ArrowElectronics/I.IMX8_Thor96/README.md

# I.IMX8_Thor96
Arrow Global solution based on iMX8M MPU for Human Machine Interface Applications
