ArrowElectronics/I.IMX8_Thor96/Hardware Docs/Schematic/eI_Arrow_iMX8M_HMI_Platform_SCHEMATIC.pdf

# Arrow iMX8M HMI Platform

# 13-Aug-2018

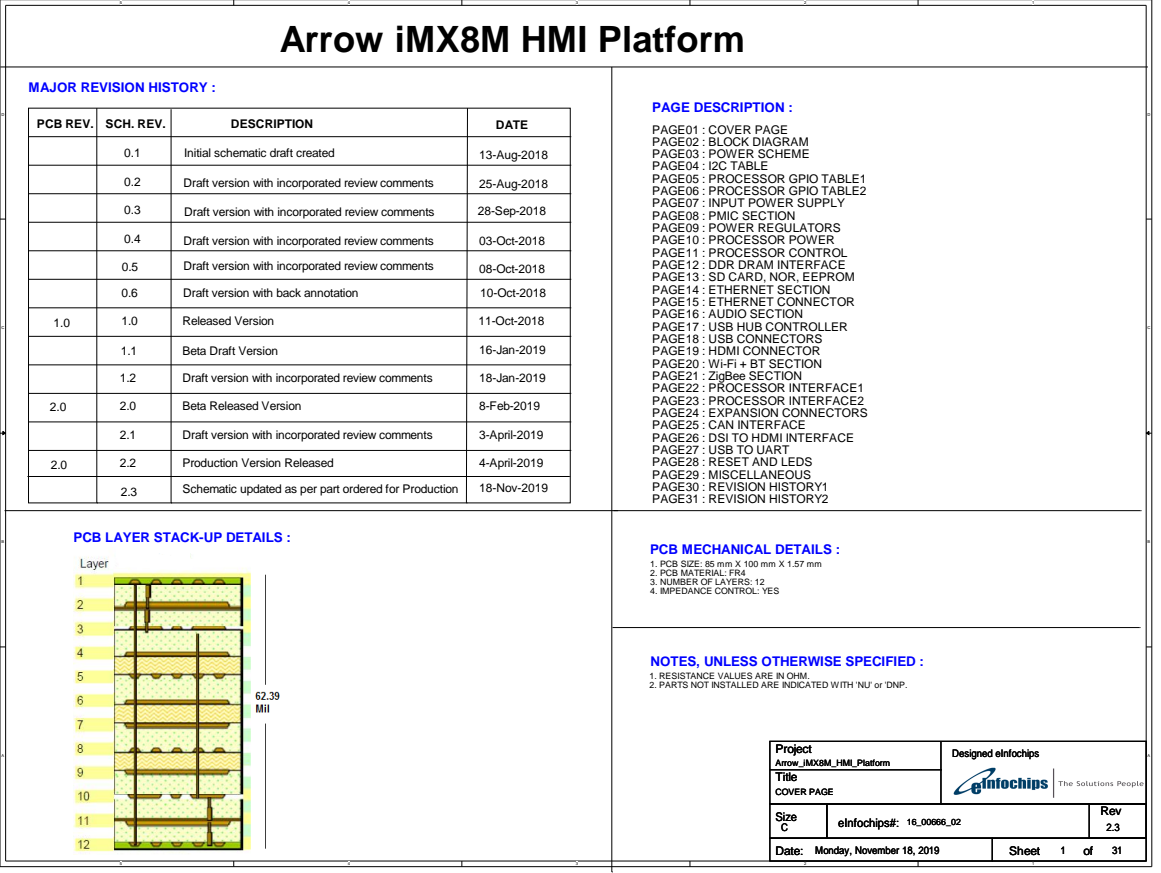
[picture p171: page 1]
8-Feb-2019; 3-April-2019; 25-Aug-2018; Released Version; 16-Jan-2019; 11-Oct-2018; 10-Oct-2018; DATE; Draft version with incorporated review comments; 18-Jan-2019; Beta Released Version; PCB REV.; SCH. REV.; DESCRIPTION; 28-Sep-2018; 03-Oct-2018; 08-Oct-2018; 4-April-2019; PAGE DESCRIPTION :; 18-Nov-2019 2.3; Schematic updated as per part ordered for Production; Title; Size; Project; Rev; Date:; Sheet; eInfochips#:; Designed eInfochips; Monday, November 18, 2019; COVER PAGE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

MAJOR REVISION HISTORY :

PAGE01 : COVER PAGE
PAGE02 : BLOCK DIAGRAM
PAGE03 : POWER SCHEME
PAGE04 : I2C TABLE
PAGE05 : PROCESSOR GPIO TABLE1
PAGE06 : PROCESSOR GPIO TABLE2
PAGE07 : INPUT POWER SUPPLY
PAGE08 : PMIC SECTION
PAGE09 : POWER REGULATORS
PAGE10 : PROCESSOR POWER
PAGE11 : PROCESSOR CONTROL
PAGE12 : DDR DRAM INTERFACE
PAGE13 : SD CARD, NOR, EEPROM
PAGE14 : ETHERNET SECTION
PAGE15 : ETHERNET CONNECTOR
PAGE16 : AUDIO SECTION
PAGE17 : USB HUB CONTROLLER
PAGE18 : USB CONNECTORS
PAGE19 : HDMI CONNECTOR
PAGE20 : Wi-Fi + BT SECTION
PAGE21 : ZigBee SECTION
PAGE22 : PROCESSOR INTERFACE1
PAGE23 : PROCESSOR INTERFACE2

Initial schematic draft created

Draft version with incorporated review comments

Draft version with back annotation

Beta Draft Version

PAGE24 : EXPANSION CONNECTORS
PAGE25 : CAN INTERFACE
PAGE26 : DSI TO HDMI INTERFACE
PAGE27 : USB TO UART
PAGE28 : RESET AND LEDS
PAGE29 : MISCELLANEOUS
PAGE30 : REVISION HISTORY1
PAGE31 : REVISION HISTORY2

Production Version Released

PCB LAYER STACK-UP DETAILS :

PCB MECHANICAL DETAILS :

1. PCB SIZE: 85 mm X 100 mm X 1.57 mm
2. PCB MATERIAL: FR4
3. NUMBER OF LAYERS: 12
4. IMPEDANCE CONTROL: YES

NOTES, UNLESS OTHERWISE SPECIFIED :

1. RESISTANCE VALUES ARE IN OHM.
2. PARTS NOT INSTALLED ARE INDICATED WITH 'NU' or 'DNP.

# BLOCK DIAGRAM

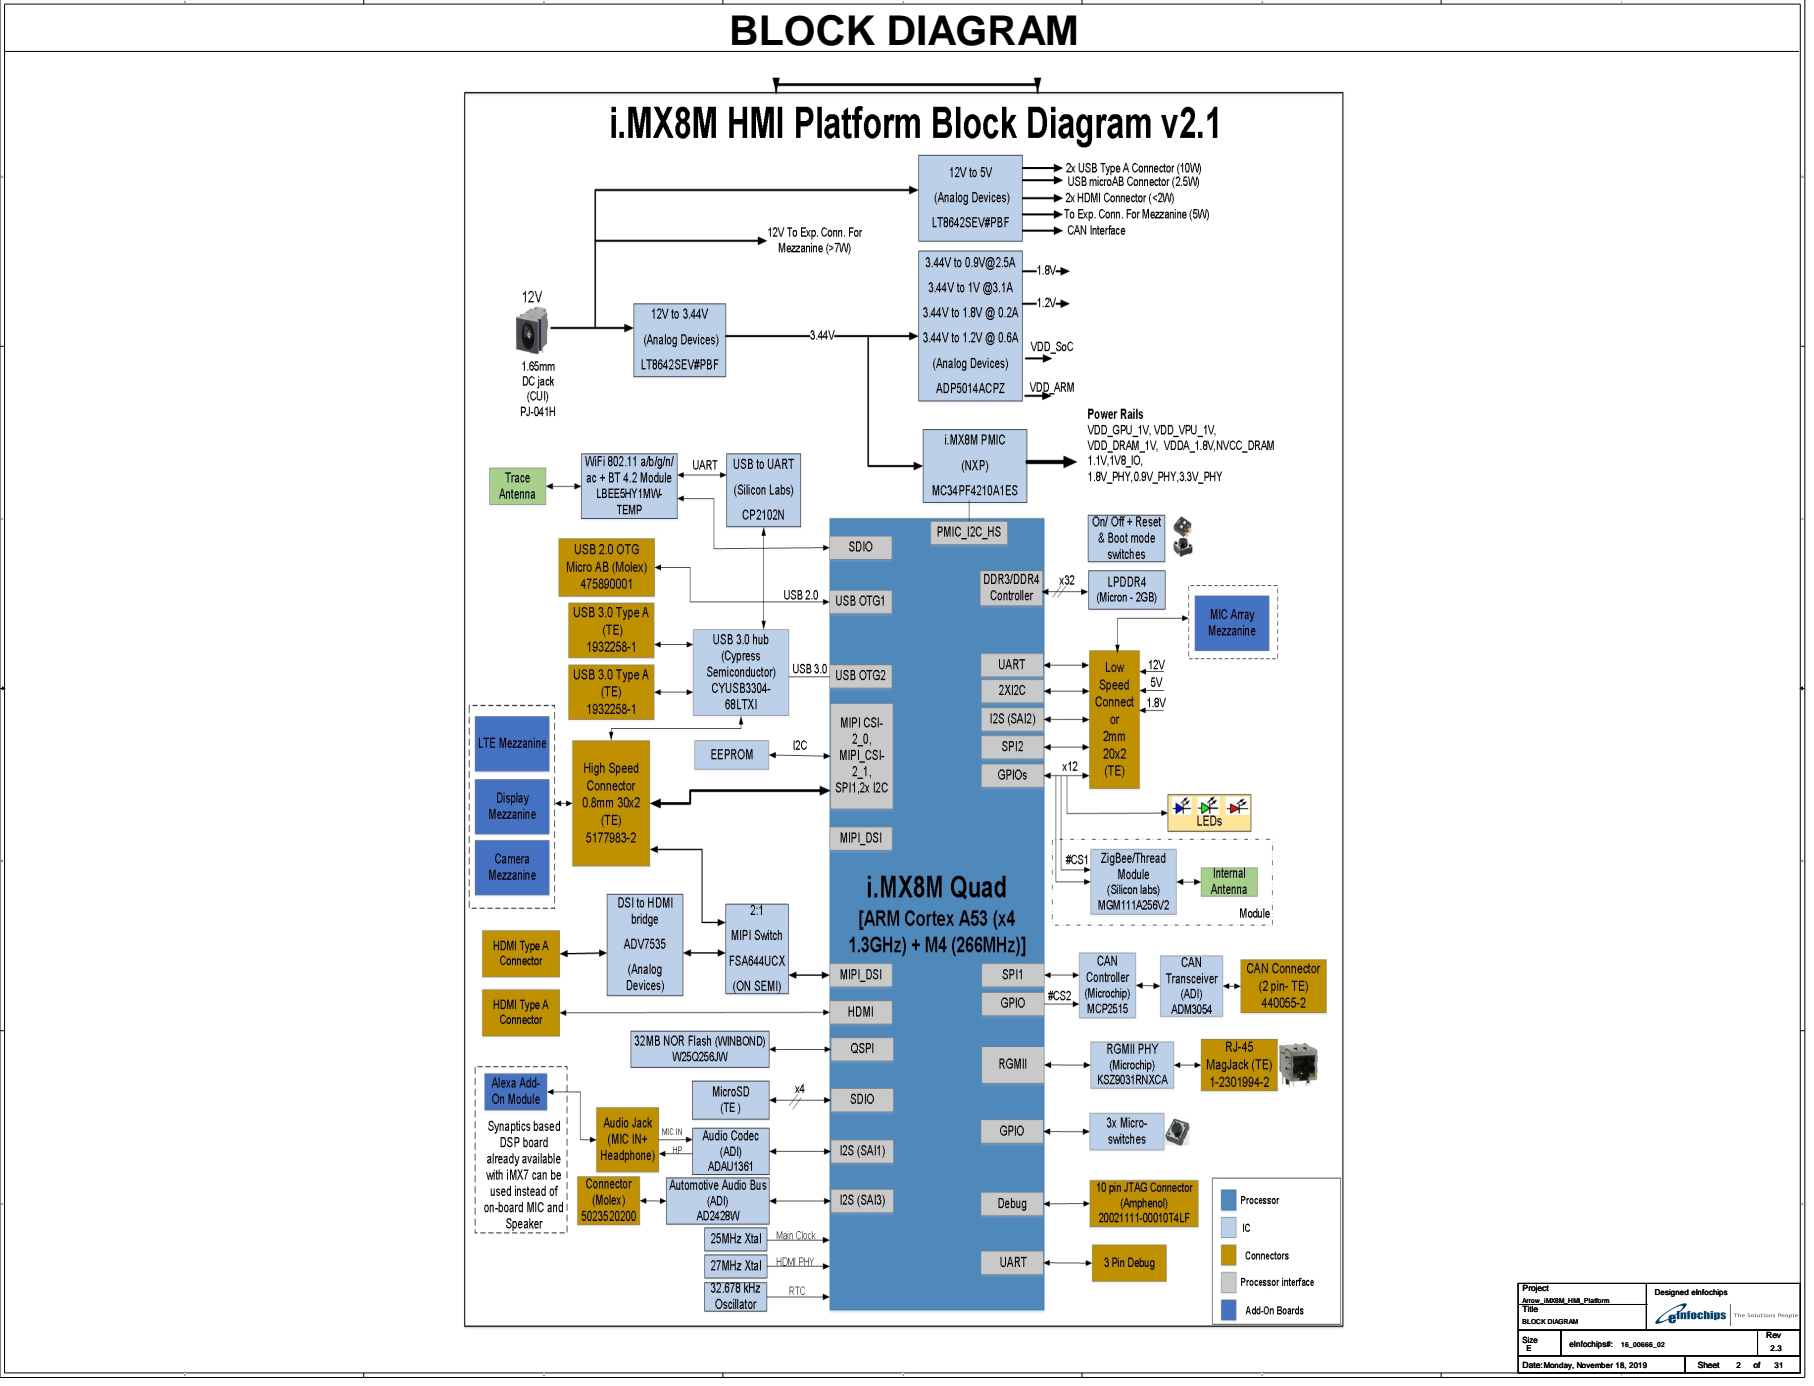
[picture p172: page 2]
Title; Project; Designed eInfochips; Monday, November 18, 2019; Arrow_iMX8M_HMI_Platform; BLOCK DIAGRAM

# POWER SCHEME

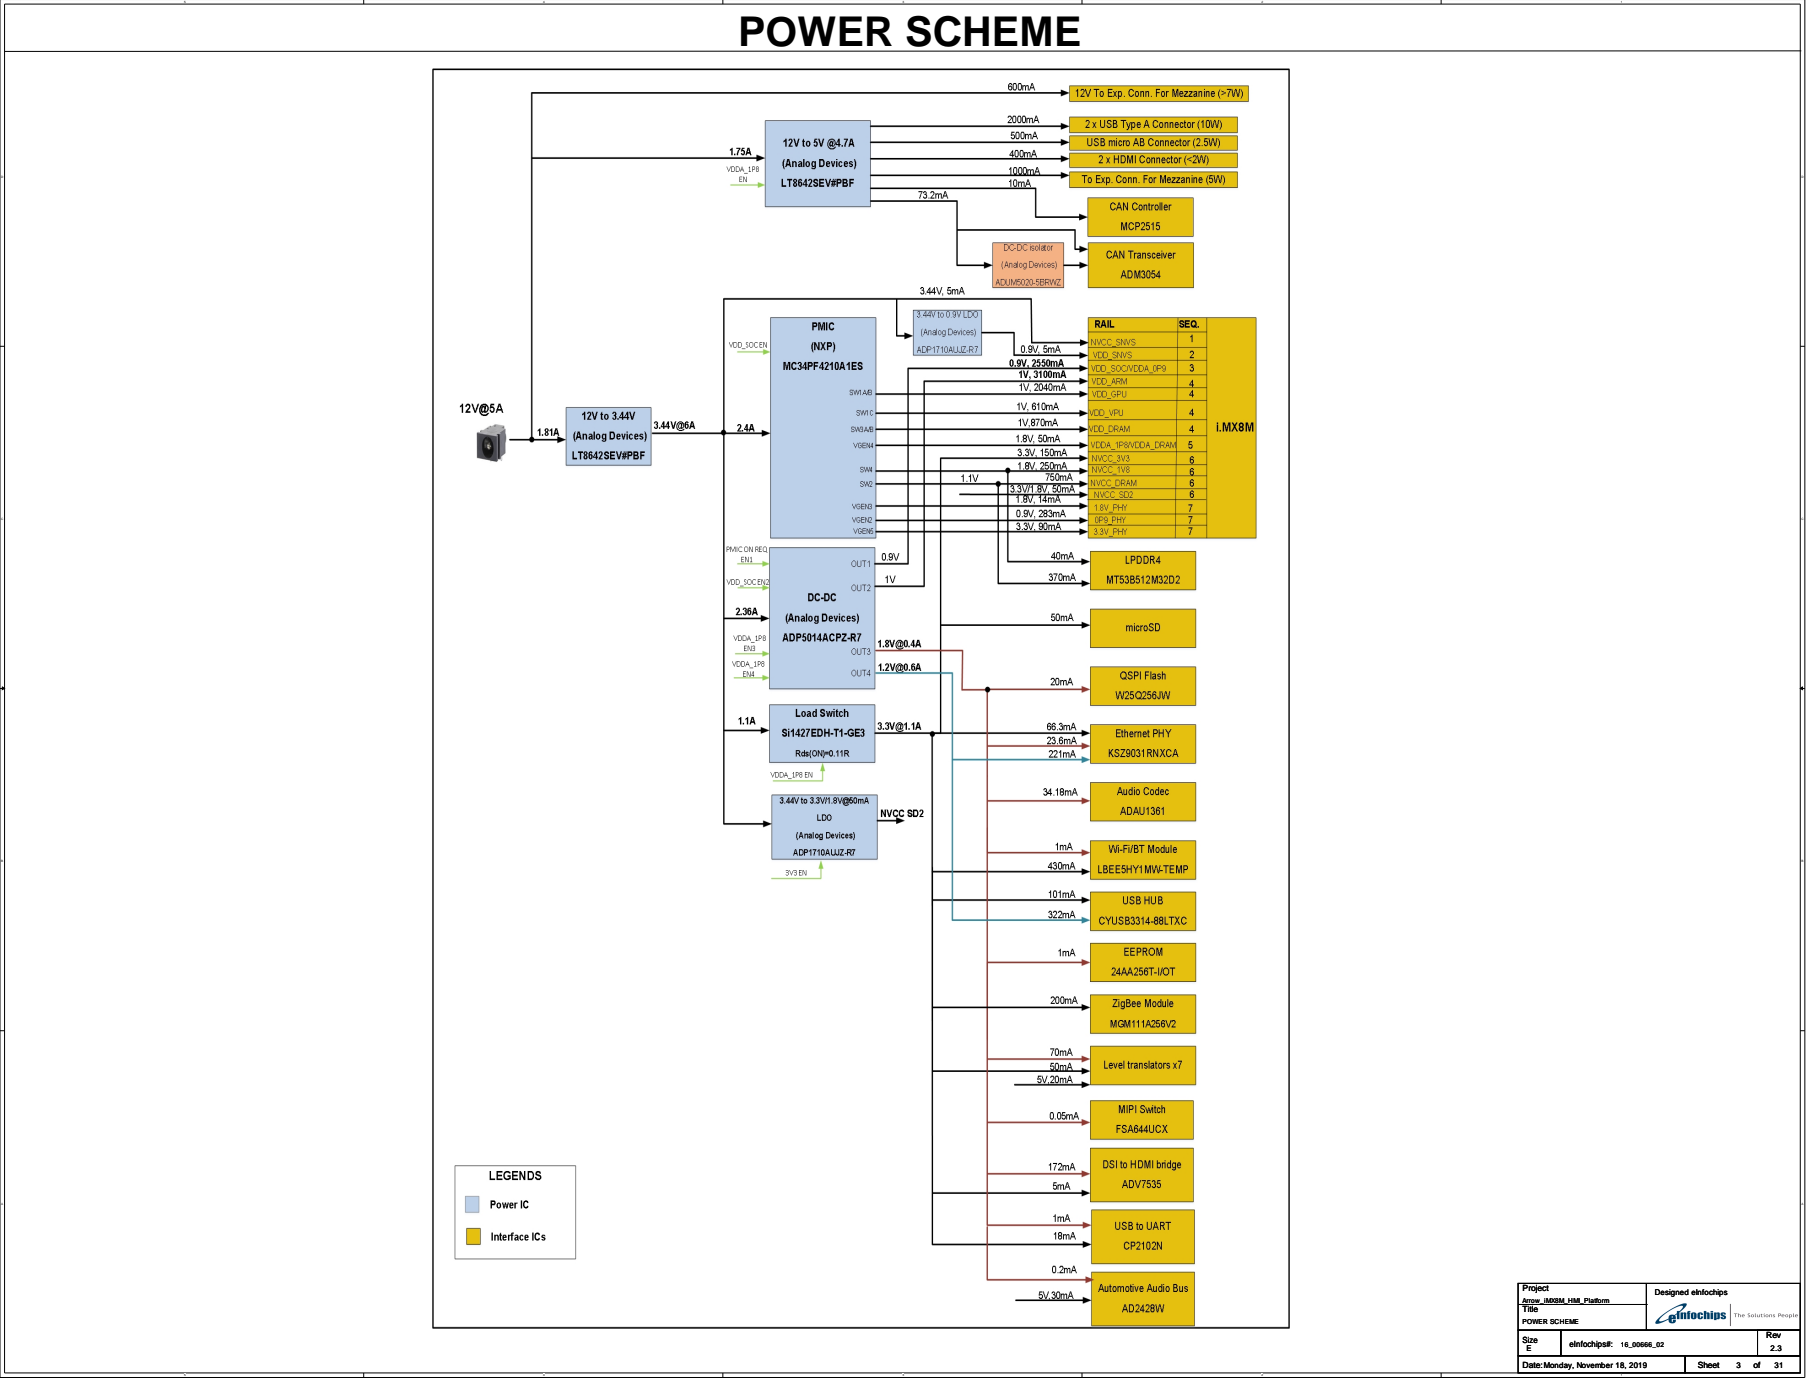
[picture p173: page 3]
Title; Project; Designed eInfochips; Monday, November 18, 2019; Arrow_iMX8M_HMI_Platform; POWER SCHEME

# I2C ADDRESS TABLE

PMIC PF4210 | 1.8V

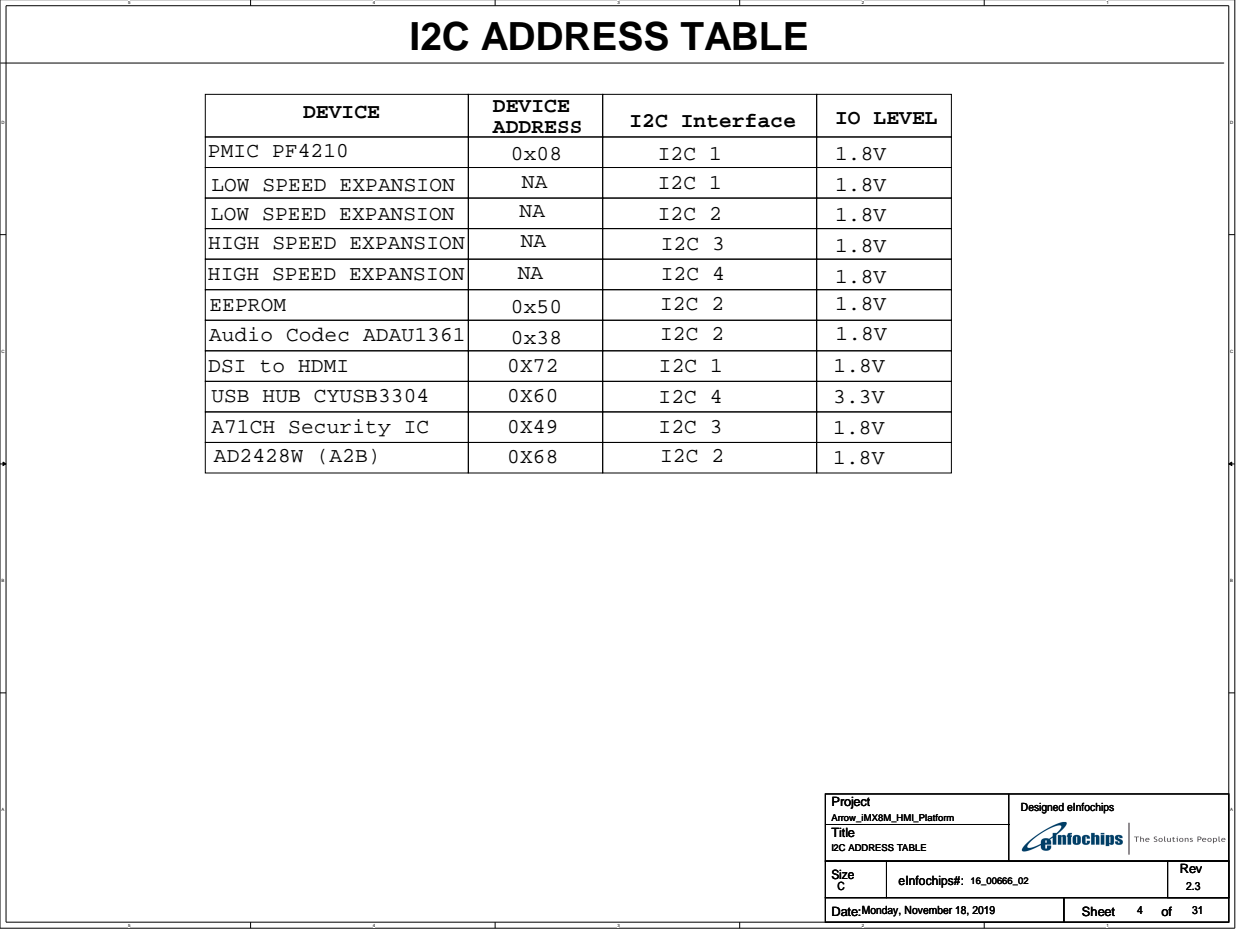
[picture p174: page 4]
LOW SPEED EXPANSION; IO LEVEL; DEVICE; I2C Interface; DEVICE ADDRESS; USB HUB CYUSB3304; A71CH Security IC; Title; Project; Designed eInfochips; Monday, November 18, 2019; Arrow_iMX8M_HMI_Platform; I2C ADDRESS TABLE

LOW SPEED EXPANSION
HIGH SPEED EXPANSION
EEPROM
Audio Codec ADAU1361
DSI to HDMI

# PROCESSOR GPIO TABLE1

# GPIO6

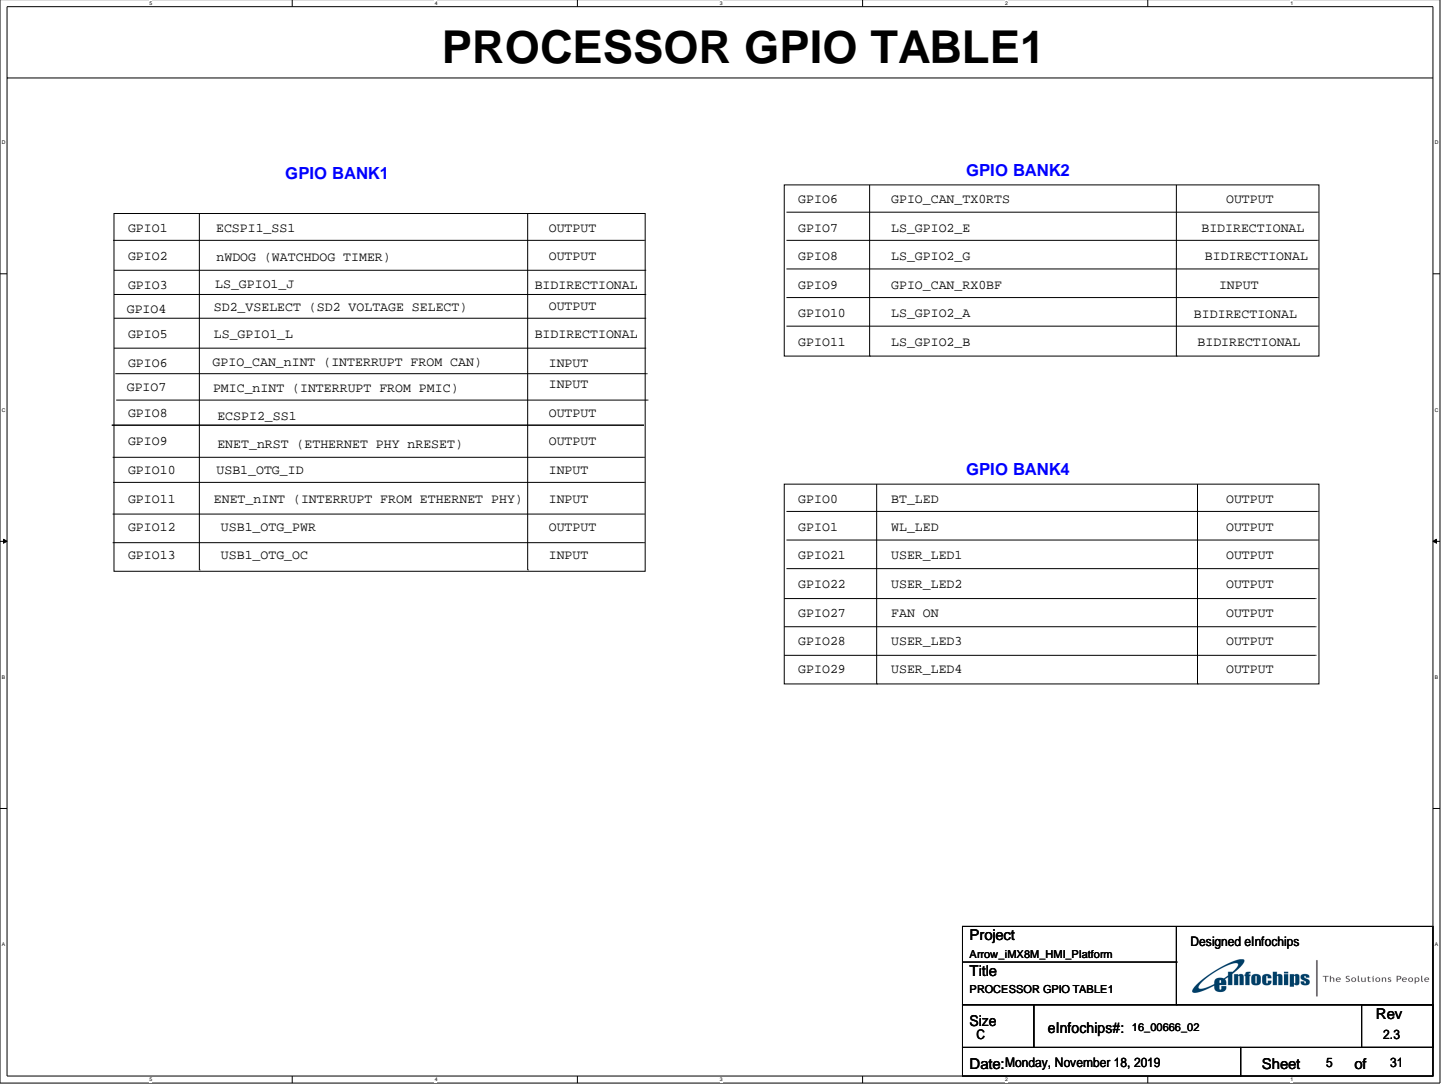
[picture p175: page 5]
LS_GPIO1_J; USB1_OTG_ID; SD2_VSELECT (SD2 VOLTAGE SELECT); OUTPUT; BIDIRECTIONAL; GPIO5; LS_GPIO1_L; GPIO6; GPIO21; GPIO22; GPIO3; GPIO9; GPIO8; GPIO12; GPIO1; GPIO29; GPIO11; GPIO7; GPIO10; GPIO2; GPIO4; GPIO28; GPIO13; GPIO_CAN_TX0RTS; GPIO BANK2; GPIO BANK4; USER_LED1; INPUT; USB1_OTG_PWR; USB1_OTG_OC; GPIO BANK1; GPIO_CAN_RX0BF; LS_GPIO2_E; LS_GPIO2_G; ECSPI1_SS1; ECSPI2_SS1; USER_LED2; USER_LED3; USER_LED4; GPIO27; FAN ON; LS_GPIO2_A; LS_GPIO2_B; GPIO0; BT_LED; WL_LED; Title; Project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

nWDOG (WATCHDOG TIMER)

GPIO_CAN_nINT (INTERRUPT FROM CAN)

PMIC_nINT (INTERRUPT FROM PMIC)

ENET_nRST (ETHERNET PHY nRESET)

ENET_nINT (INTERRUPT FROM ETHERNET PHY)

# PROCESSOR GPIO TABLE2

# INPUT

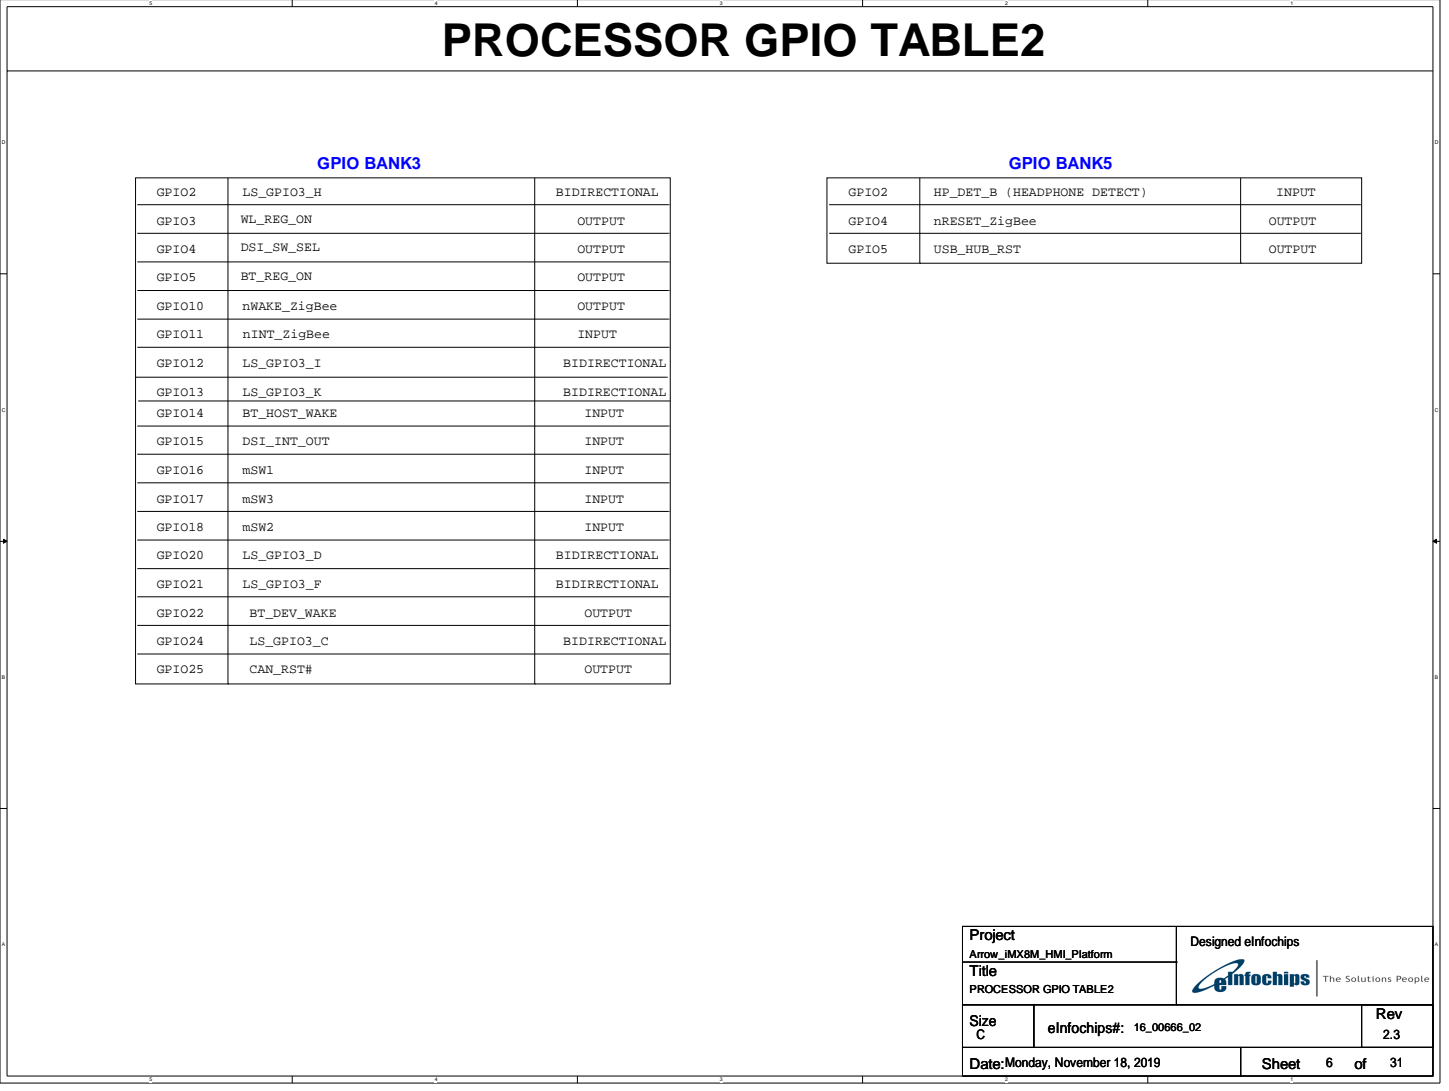
[picture p176: page 6]
mSW2; GPIO3; GPIO4; GPIO22; GPIO5; GPIO15; GPIO14; BT_HOST_WAKE; INPUT; DSI_INT_OUT; GPIO2; USB_HUB_RST; OUTPUT; nRESET_ZigBee; GPIO16; GPIO12; LS_GPIO3_D; LS_GPIO3_K; GPIO17; mSW3; GPIO18; GPIO21; LS_GPIO3_F; BIDIRECTIONAL; GPIO20; GPIO13; LS_GPIO3_H; mSW1; LS_GPIO3_I; GPIO24; LS_GPIO3_C; BT_DEV_WAKE; GPIO BANK5; GPIO BANK3; HP_DET_B (HEADPHONE DETECT); WL_REG_ON; GPIO11; nINT_ZigBee; DSI_SW_SEL; GPIO25; CAN_RST#; BT_REG_ON; GPIO10; nWAKE_ZigBee; Title; Project; Designed eInfochips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

# INPUT POWER PROTECTION CIRCUIT

# INPUT POWER SUPPLY

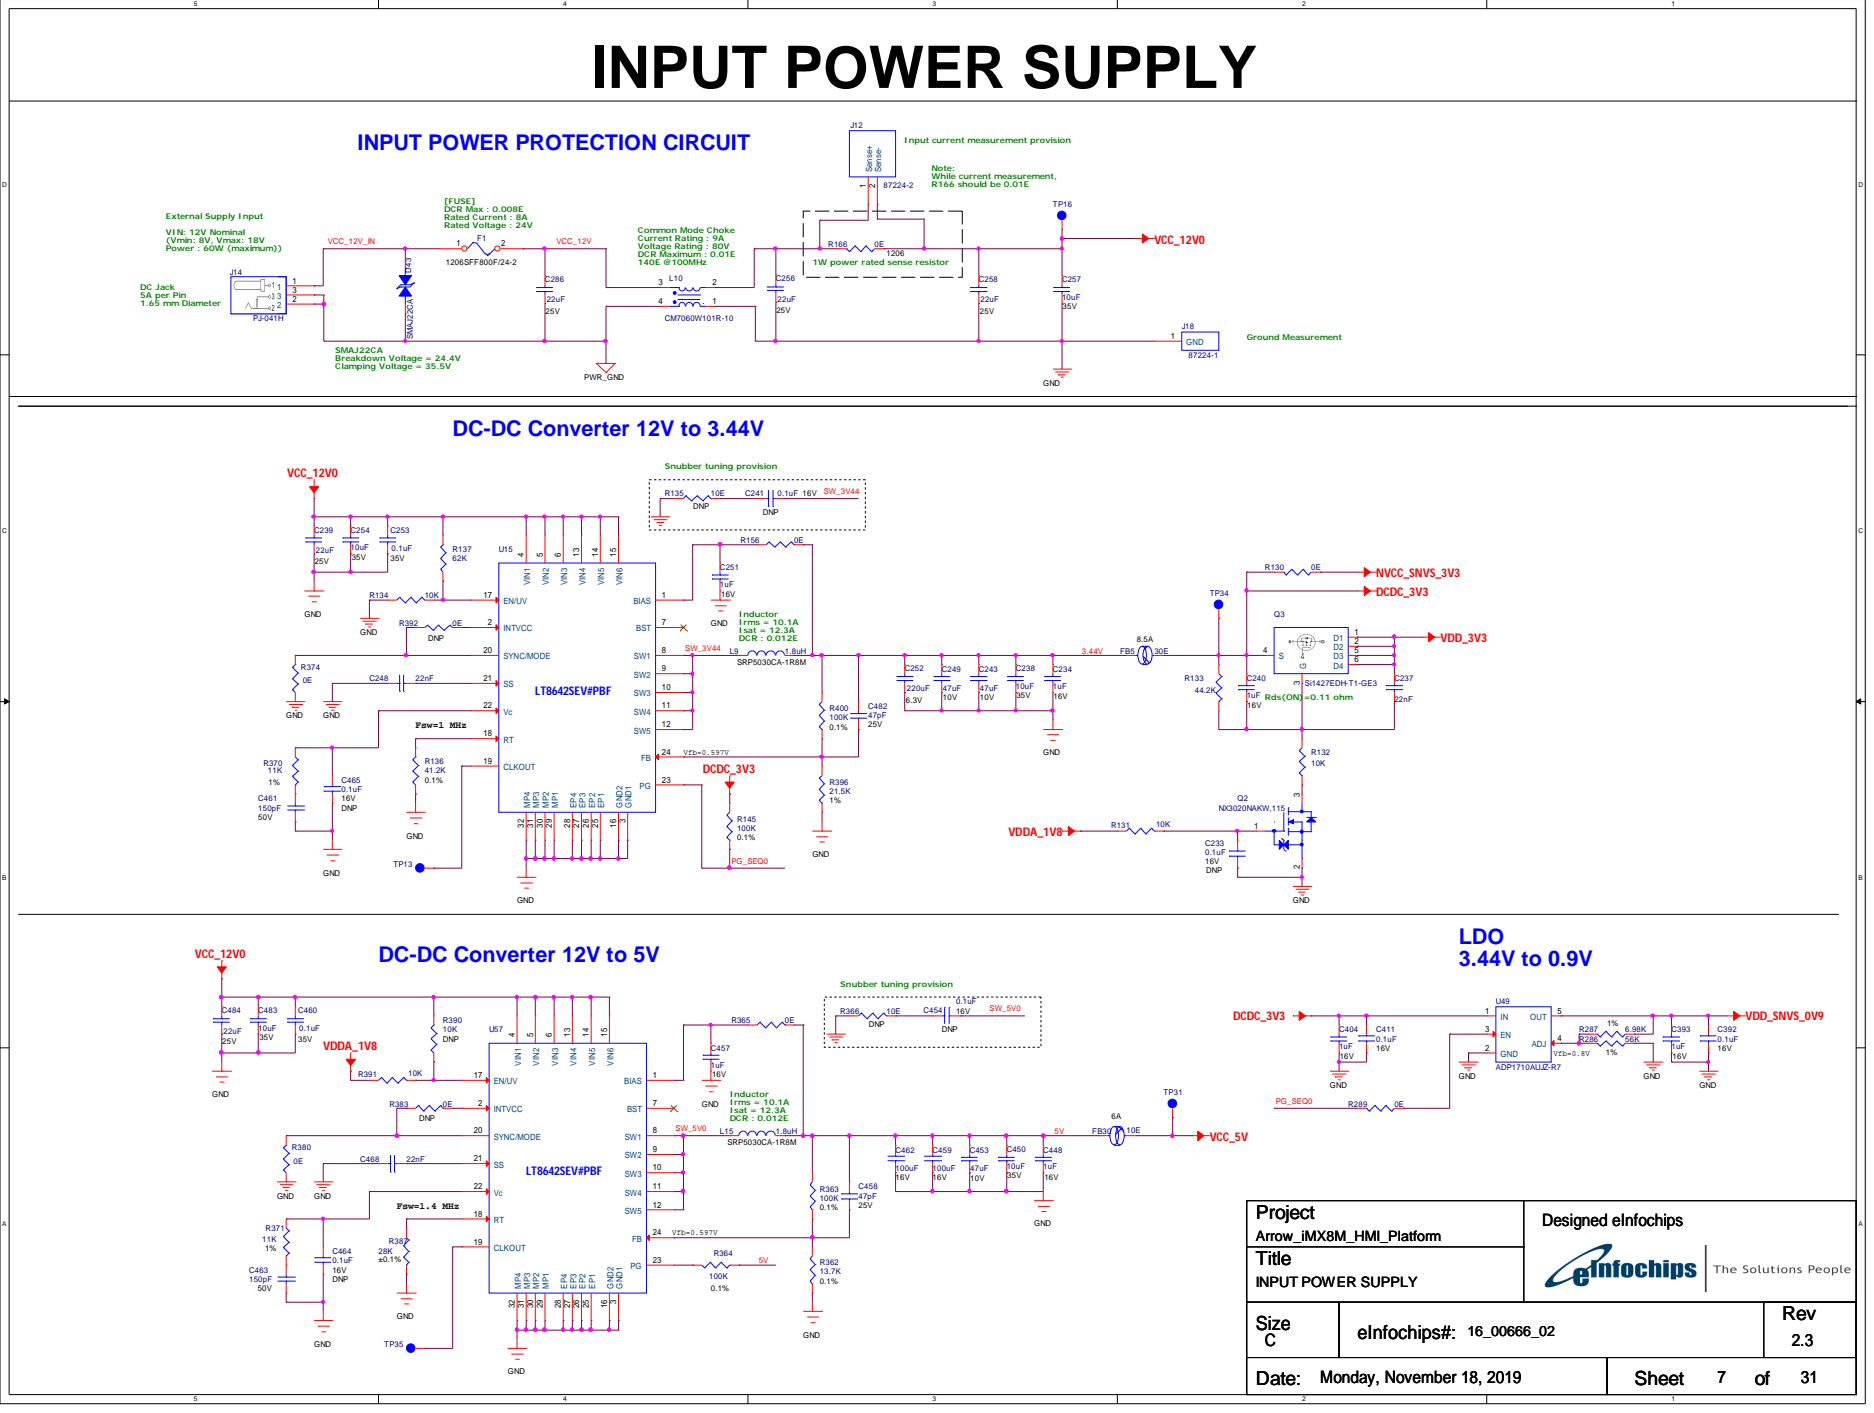
[picture p177: page 7]

Input current measurement provision

1W power rated sense resistor

DC-DC Converter 12V to 3.44V

DC-DC Converter 12V to 5V

# PMIC SECTION

## NVCC_SNVS_3V3

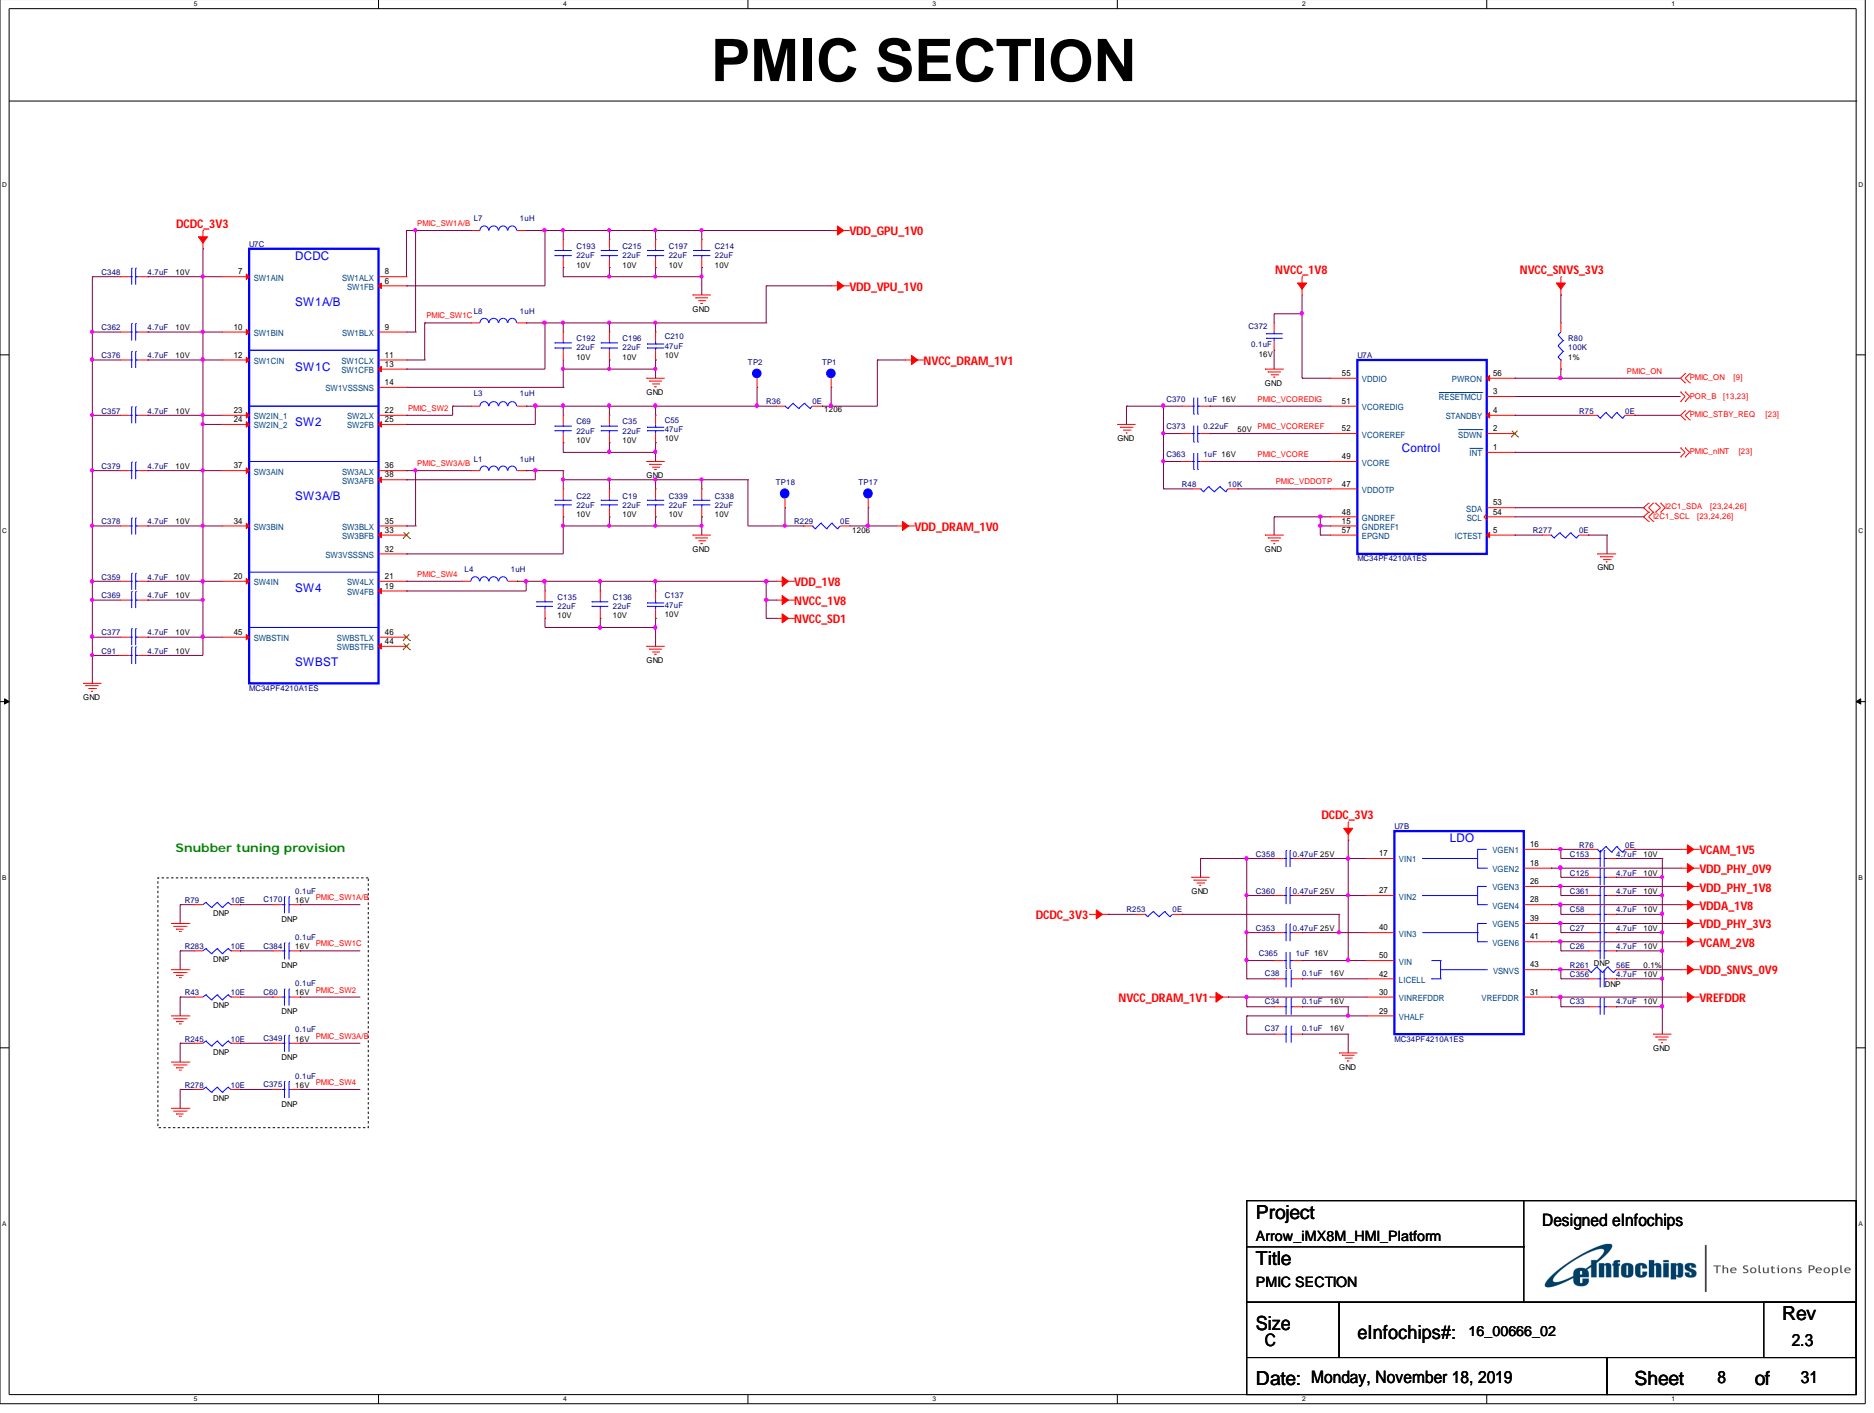
[picture p178: page 8]

# POWER REGULATORS

## CAD Note: Place decoupling capacitors near to the power pins

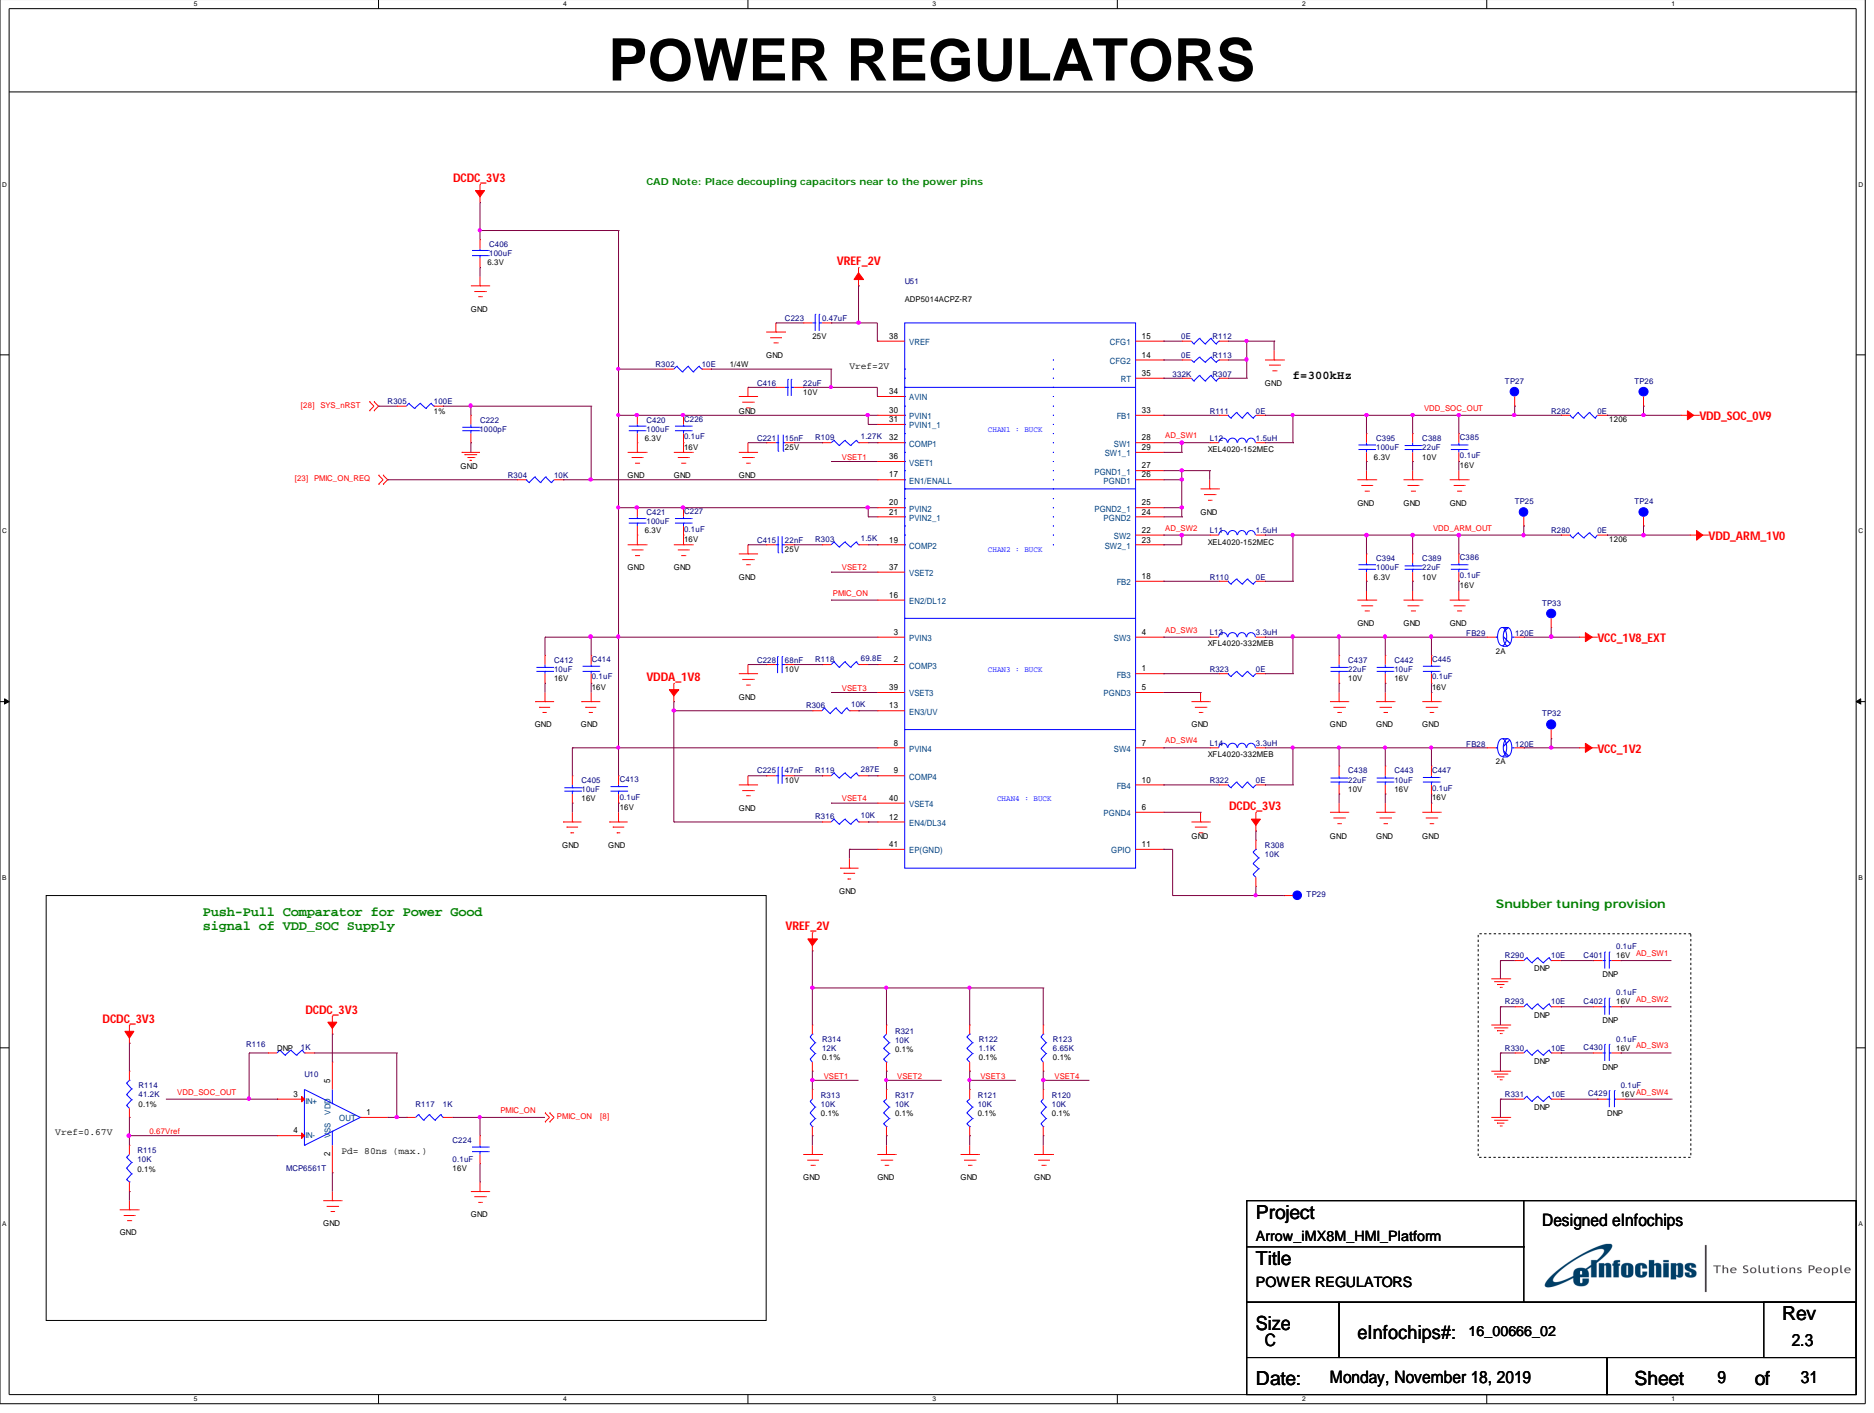
[picture p179: page 9]

Push-Pull Comparator for Power Good
signal of VDD_SOC Supply

# PROCESSOR(iMX 8M) POWER AND GROUND

NVCC_SNVS_3V3 | NVCC_1V8 | VDD_1V8 | NVCC_1V8

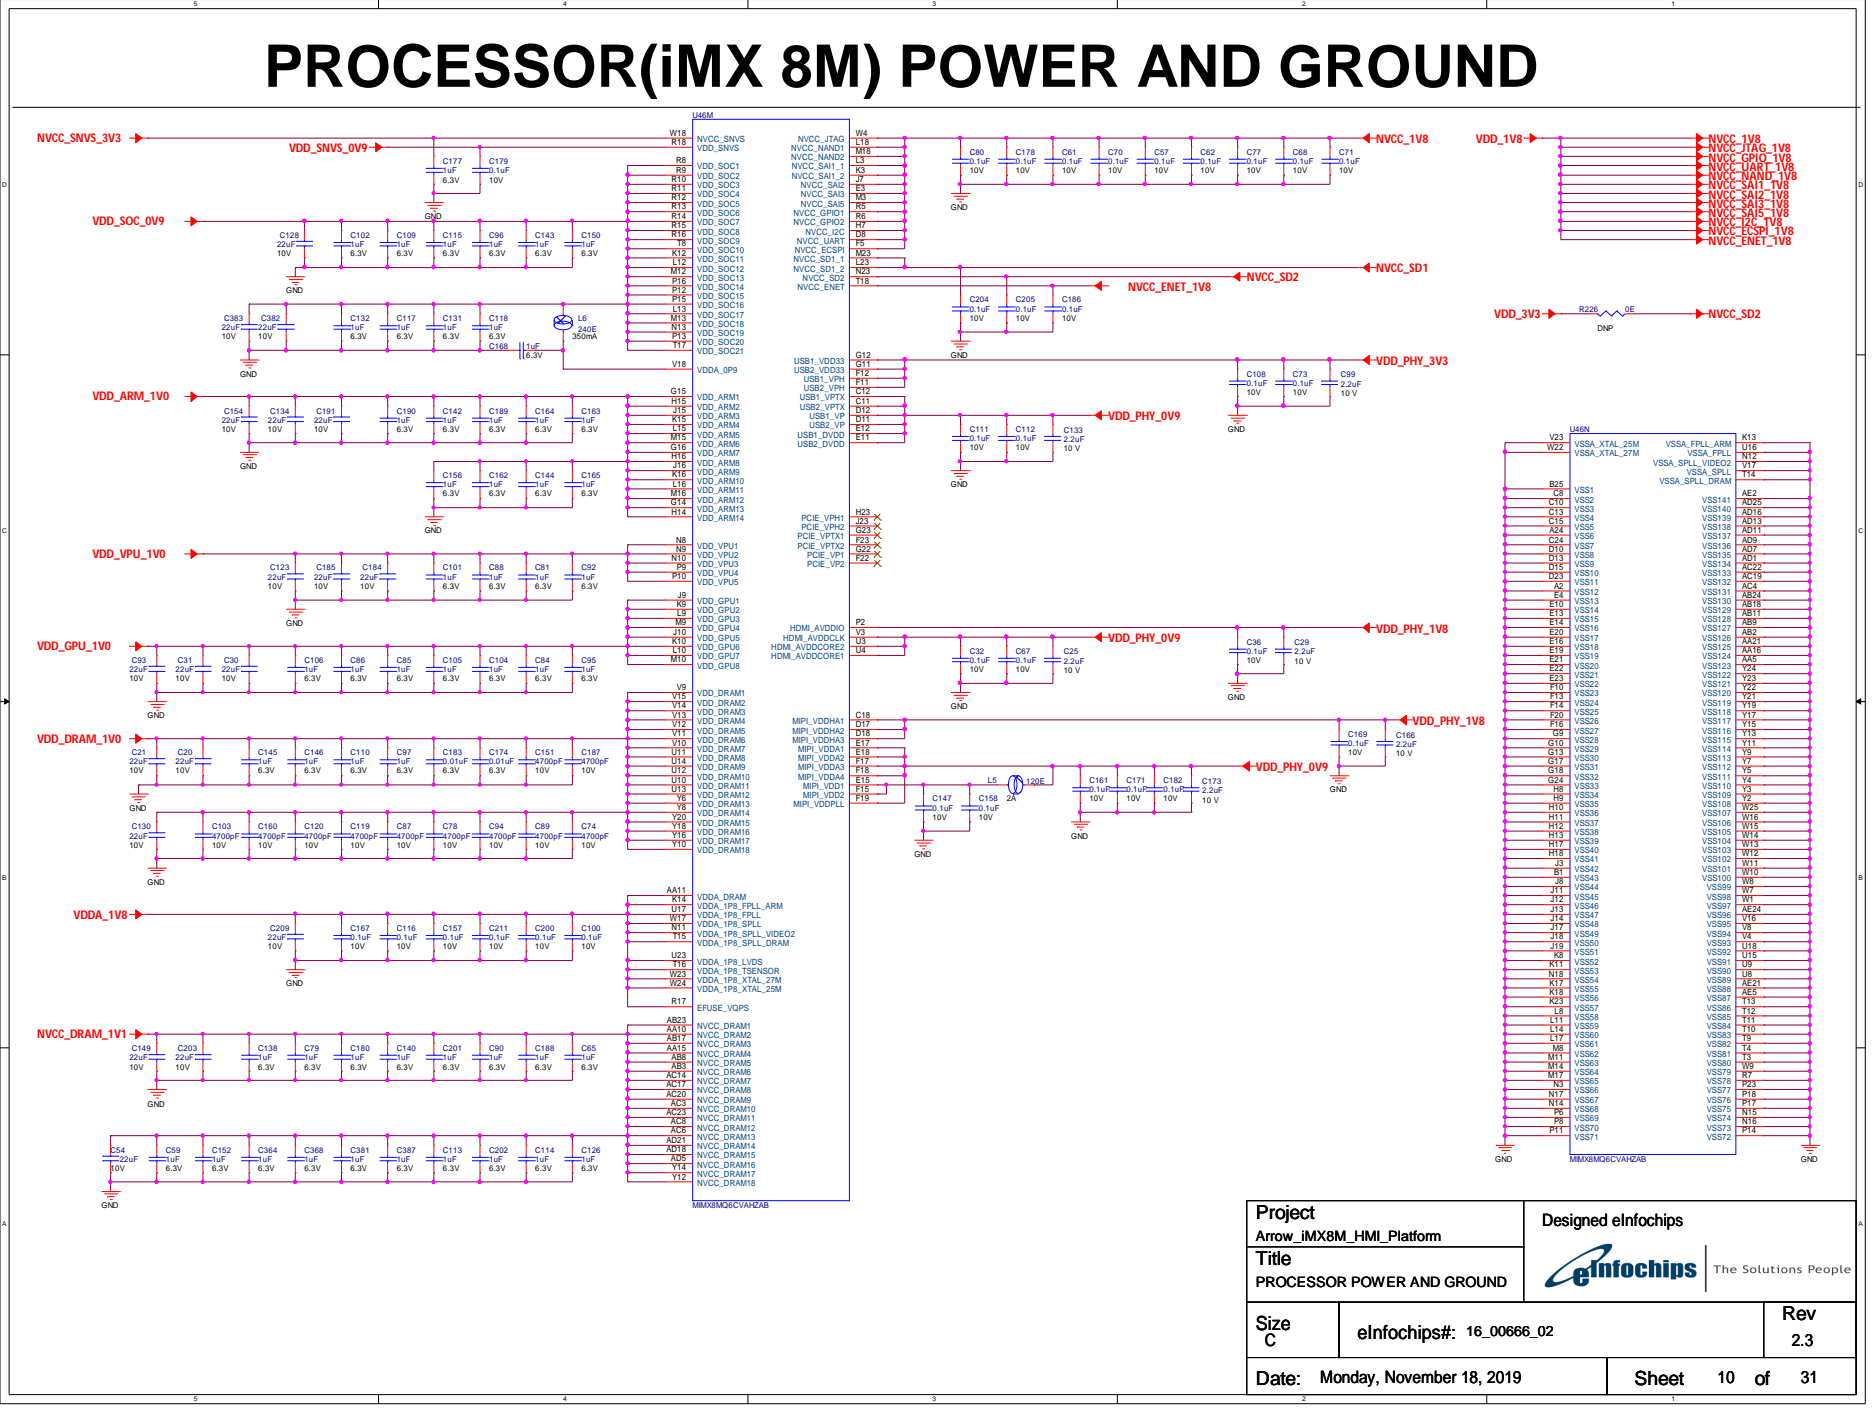
[picture p180: page 10]

PROCESSOR POWER AND GROUND

# PROCESSOR(iMX 8M QUAD) CONTROL

# QSPI boot is not supported by ROM in current Silicon revision

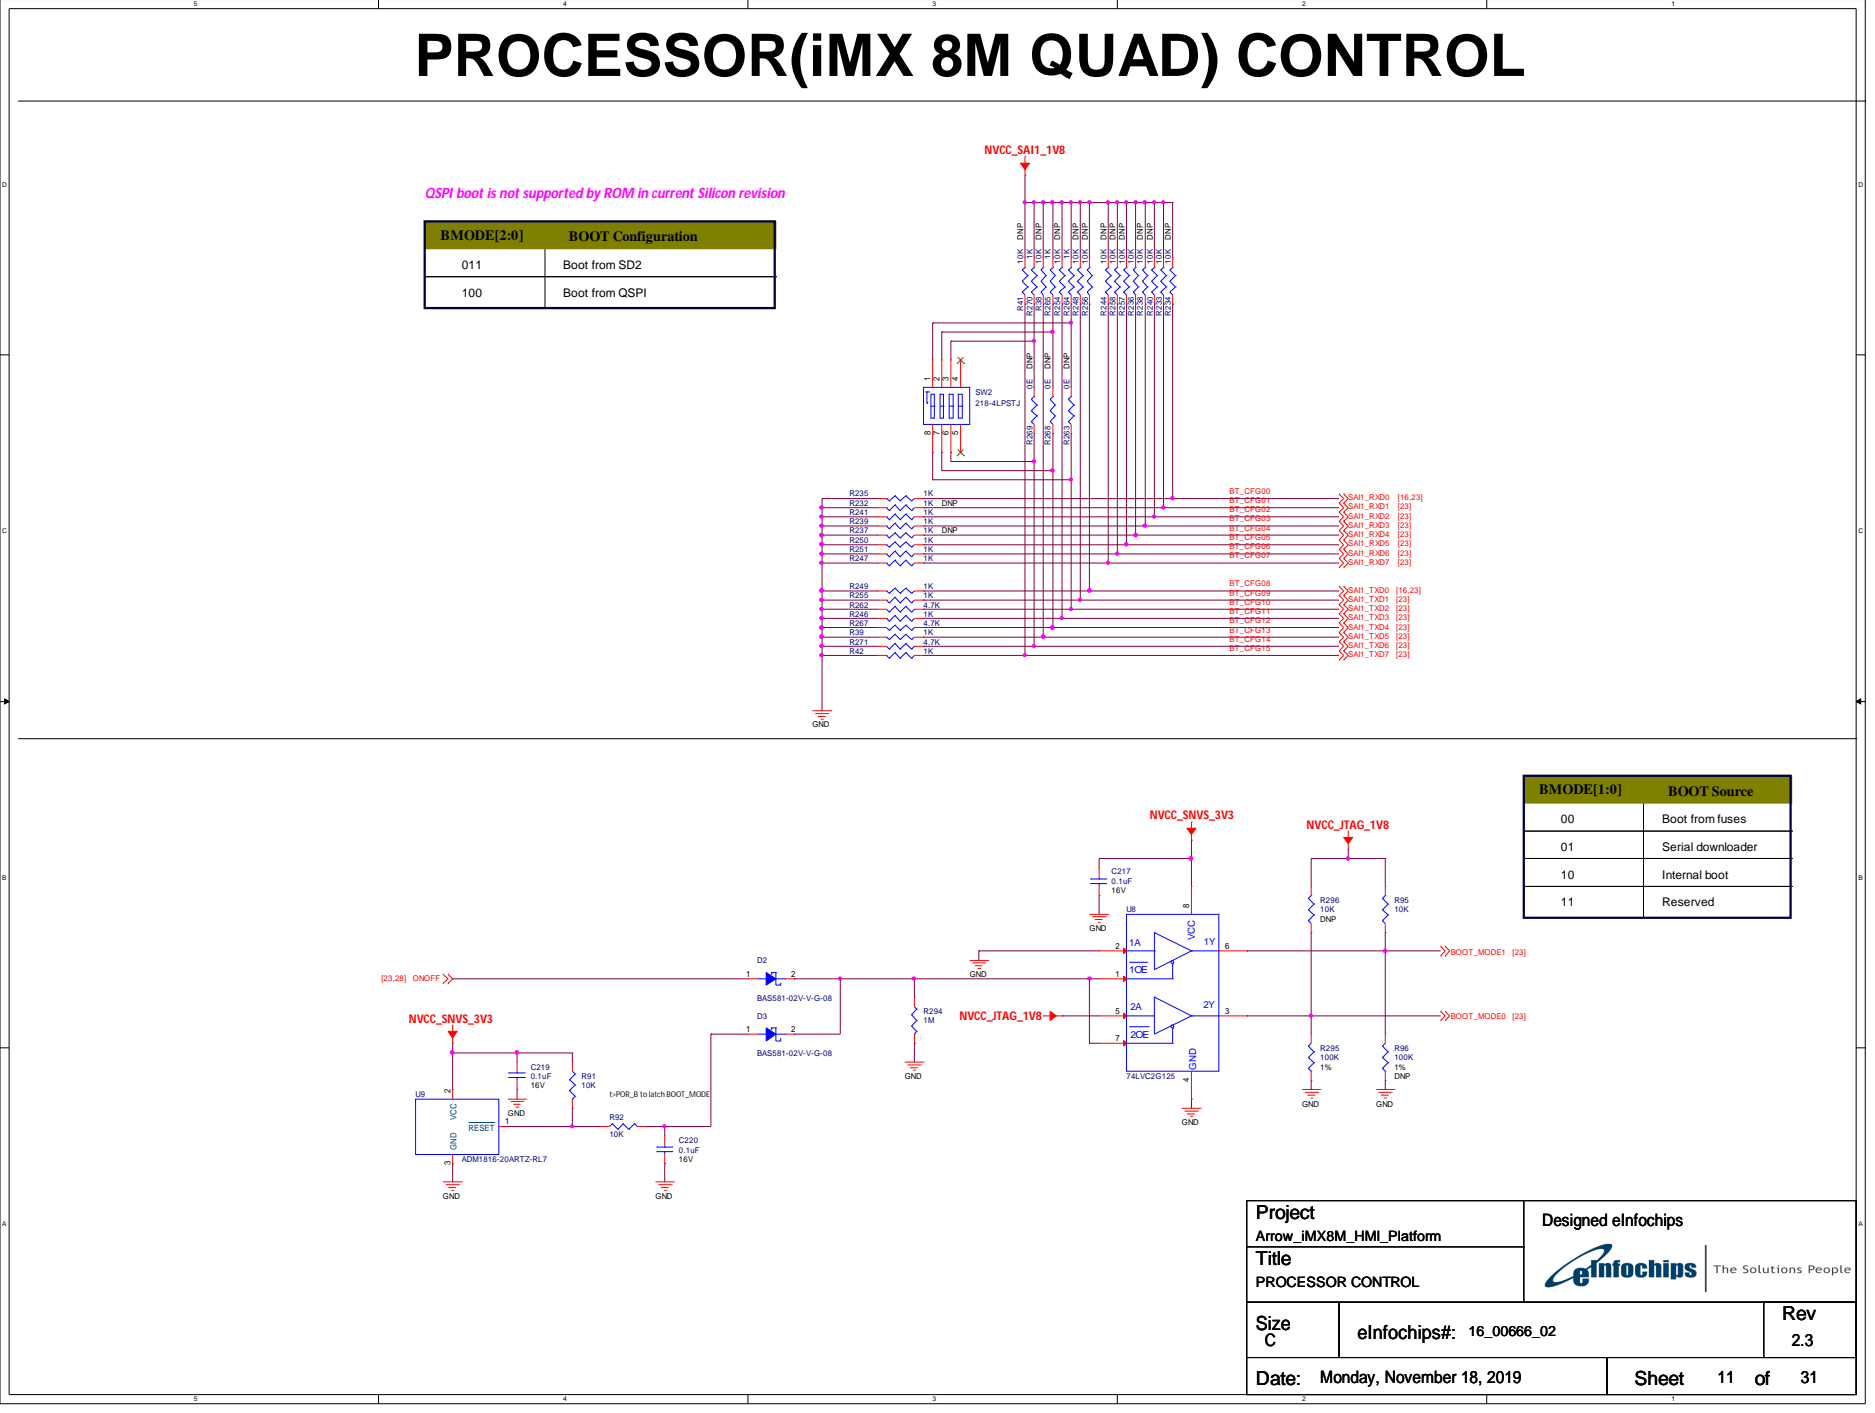
[picture p181: page 11]

# DDR INTERFACE

## CAD Note:

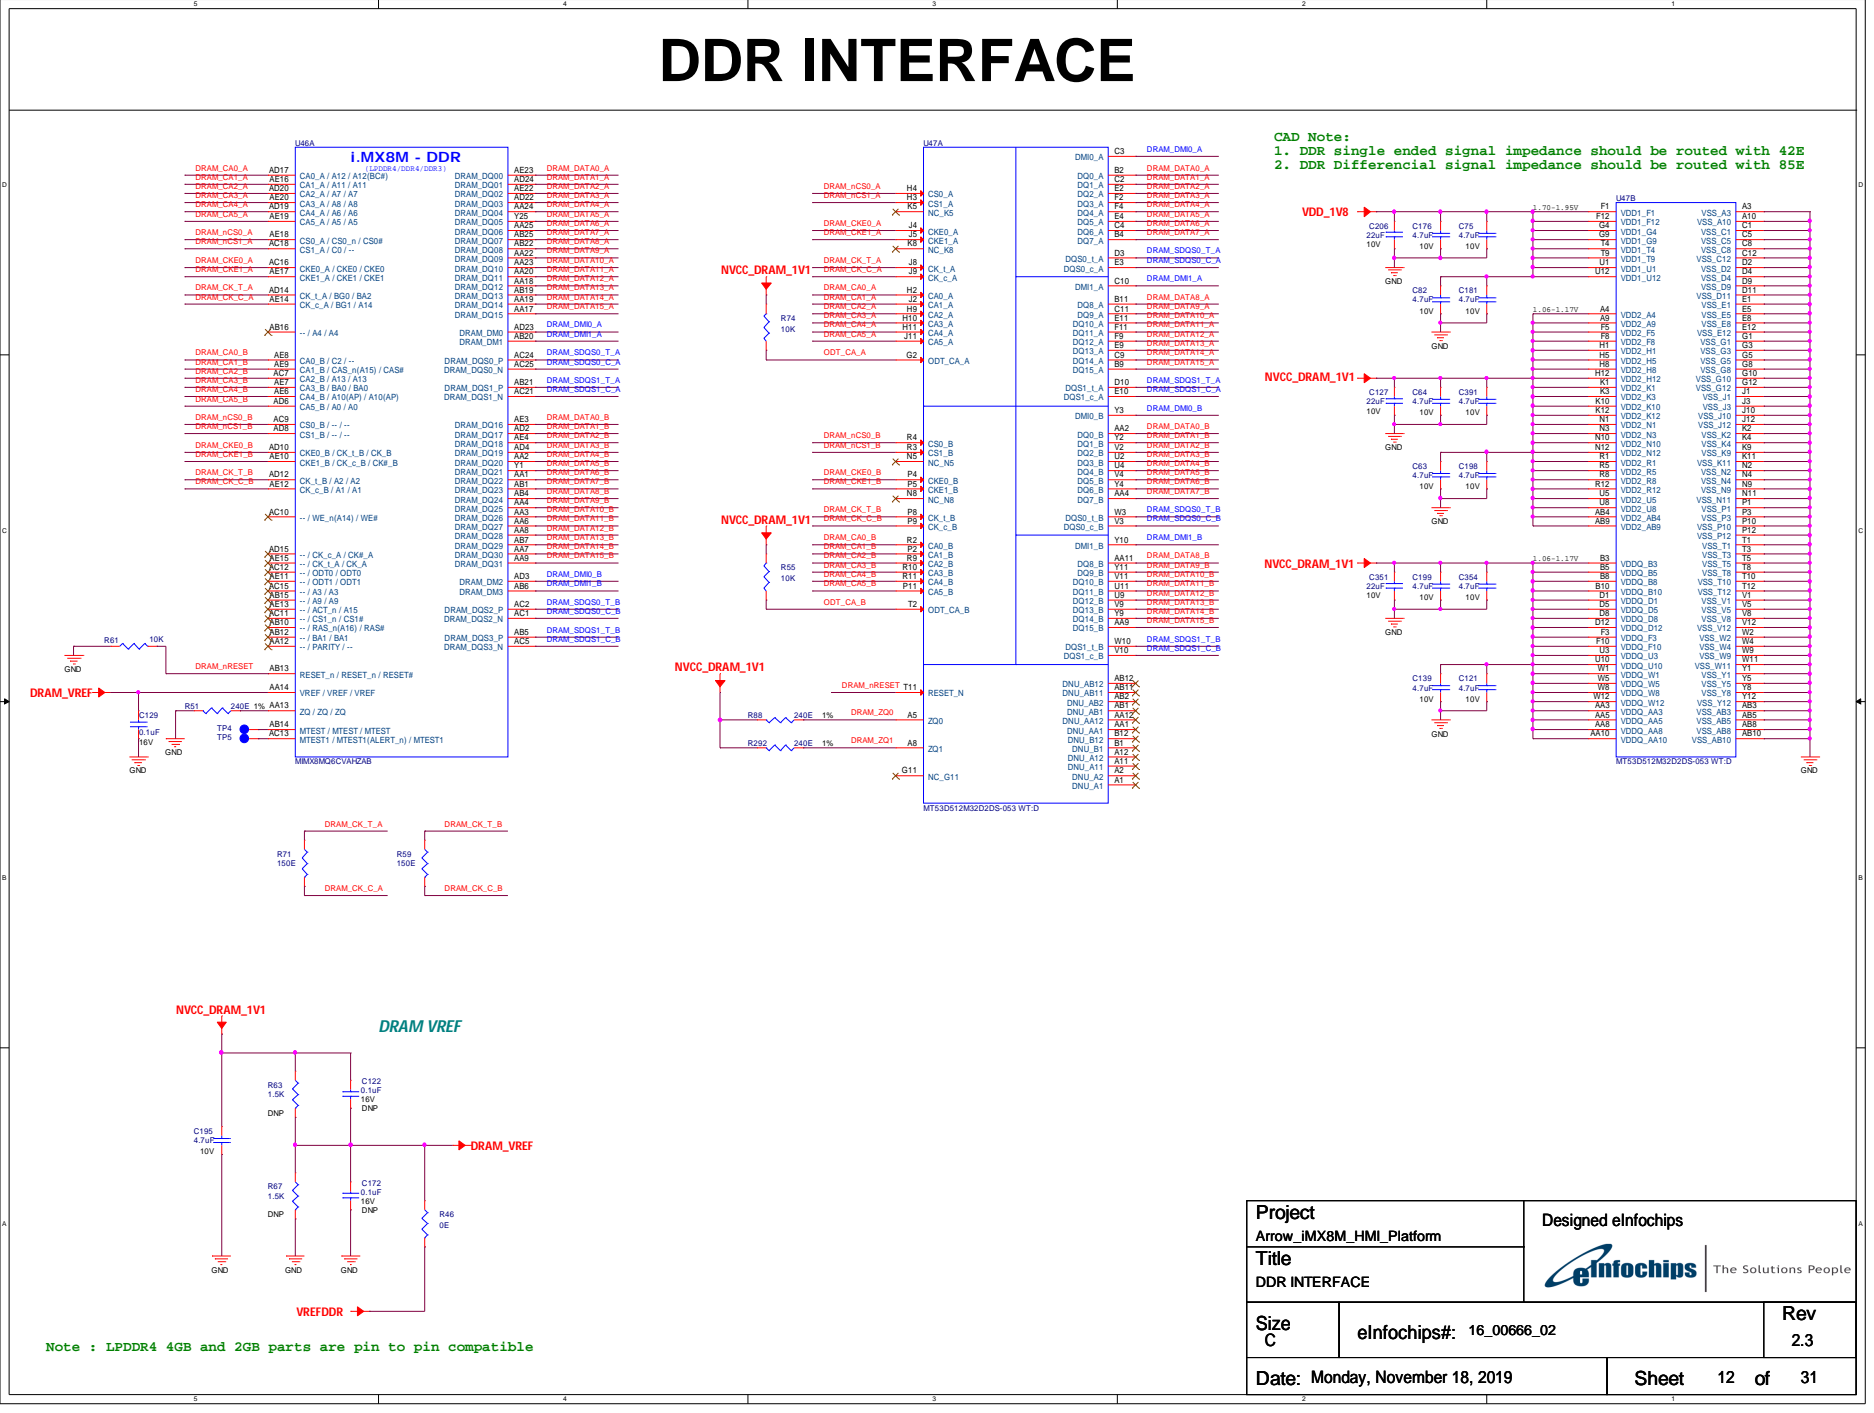
[picture p182: page 12]

1. DDR single ended signal impedance should be routed with 42E
2. DDR Differencial signal impedance should be routed with 85E

Note : LPDDR4 4GB and 2GB parts are pin to pin compatible

# MIMX8MQ6DVAJZAA

# NOR MEMORY

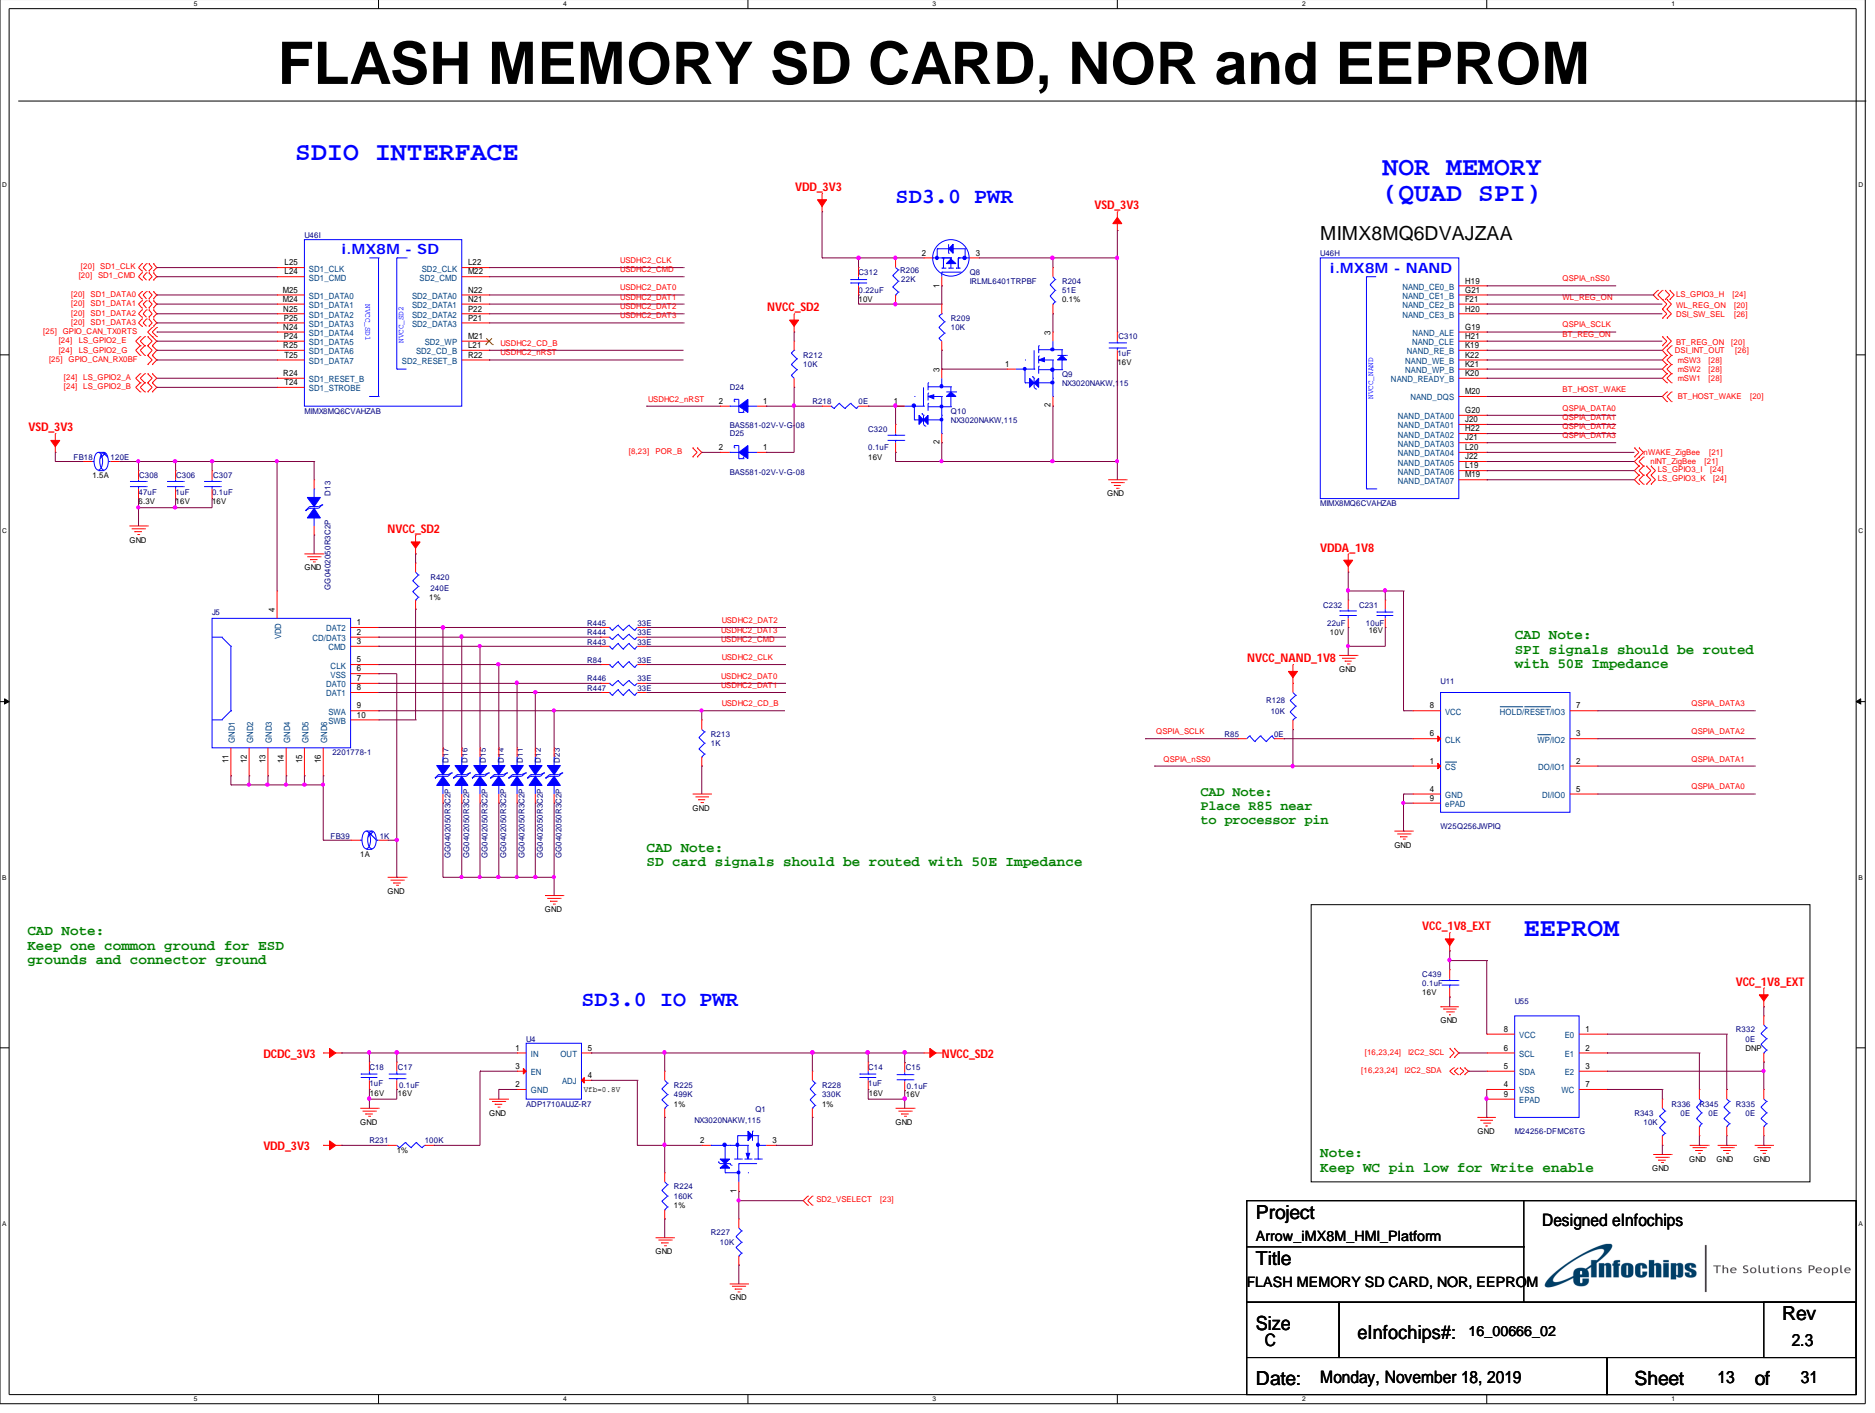
[picture p183: page 13]

FLASH MEMORY SD CARD, NOR and EEPROM

CAD Note:
SPI signals should be routed
with 50E Impedance

SD card signals should be routed with 50E Impedance

Keep one common ground for ESD
grounds and connector ground

Note:
Keep WC pin low for Write enable

FLASH MEMORY SD CARD, NOR, EEPROM

# ETHERNET SECTION

## Note: 1.8Volt ENET0_RGMII TX and RX

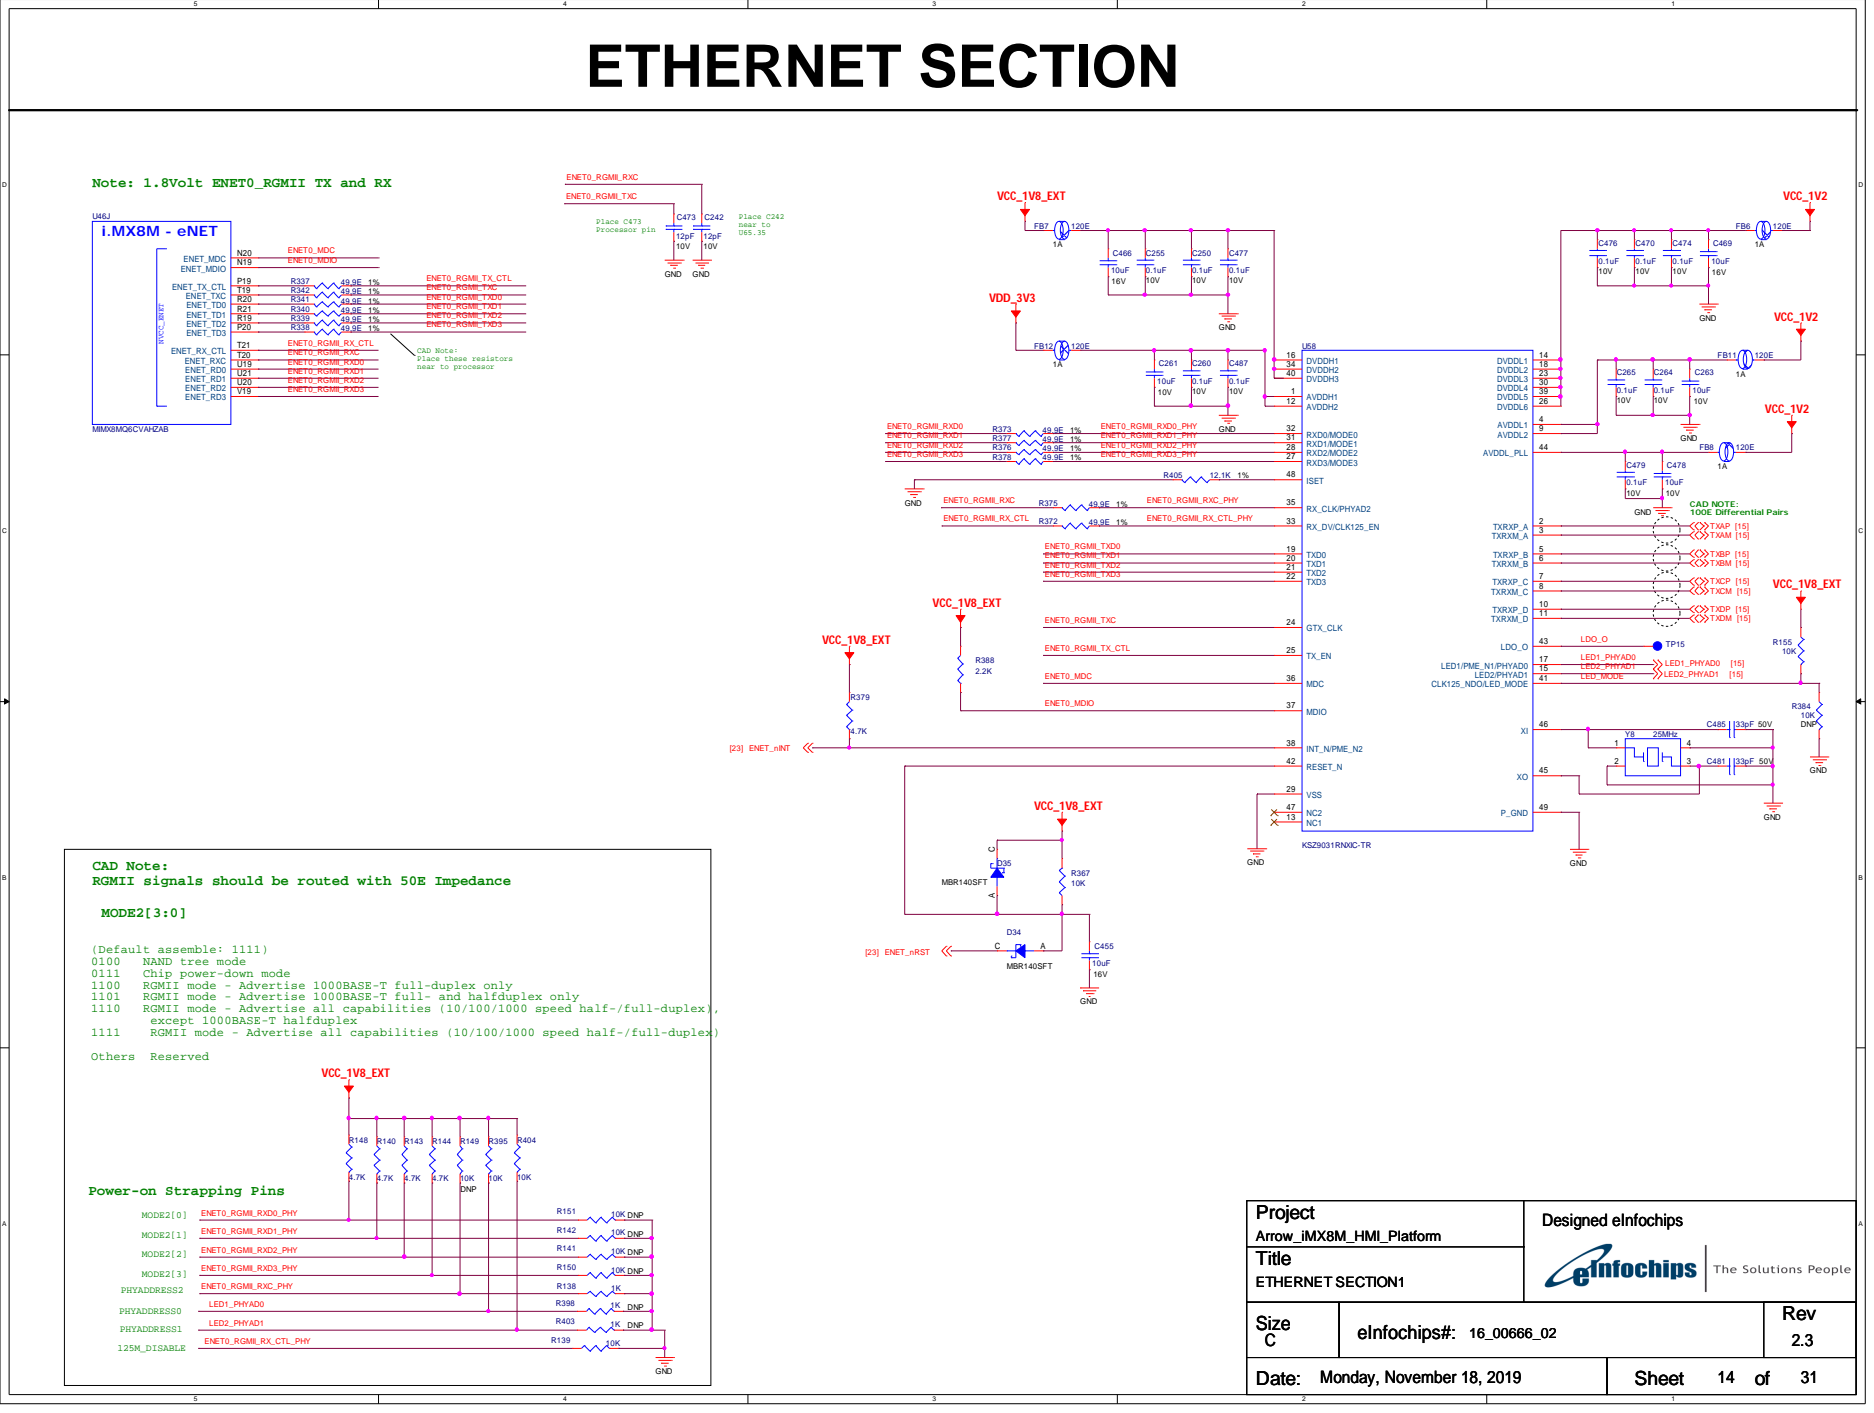
[picture p184: page 14]

CAD Note:
RGMII signals should be routed with 50E Impedance

Power-on Strapping Pins

# ETHERNET CONNECTOR INTERFACE ( RGMII MODE )

# ETHERNET CONNECTOR

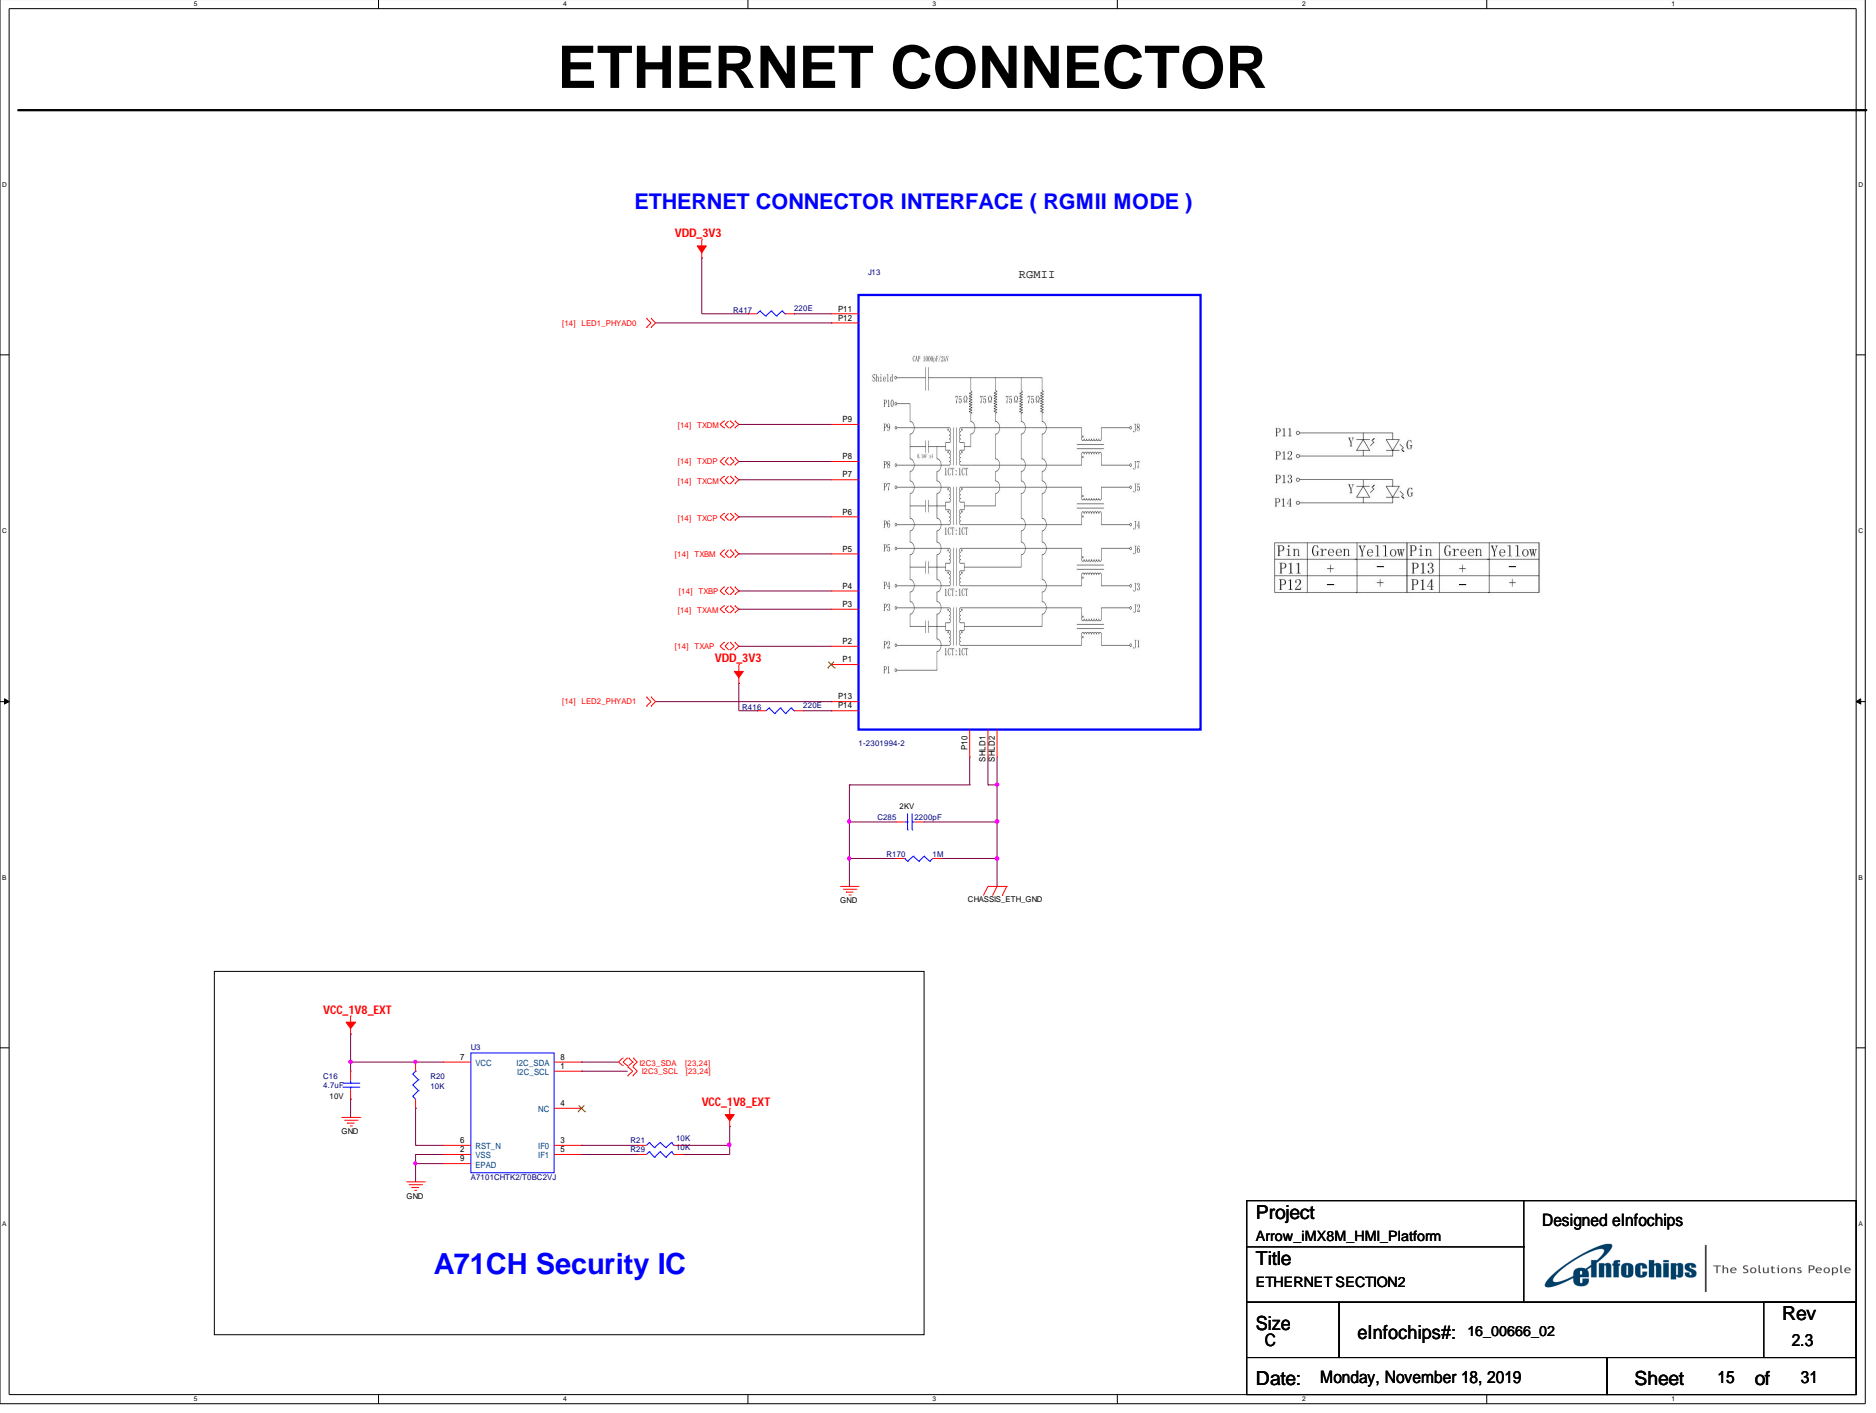
[picture p185: page 15]

# AUDIO SECTION

## Audio Codec Jack

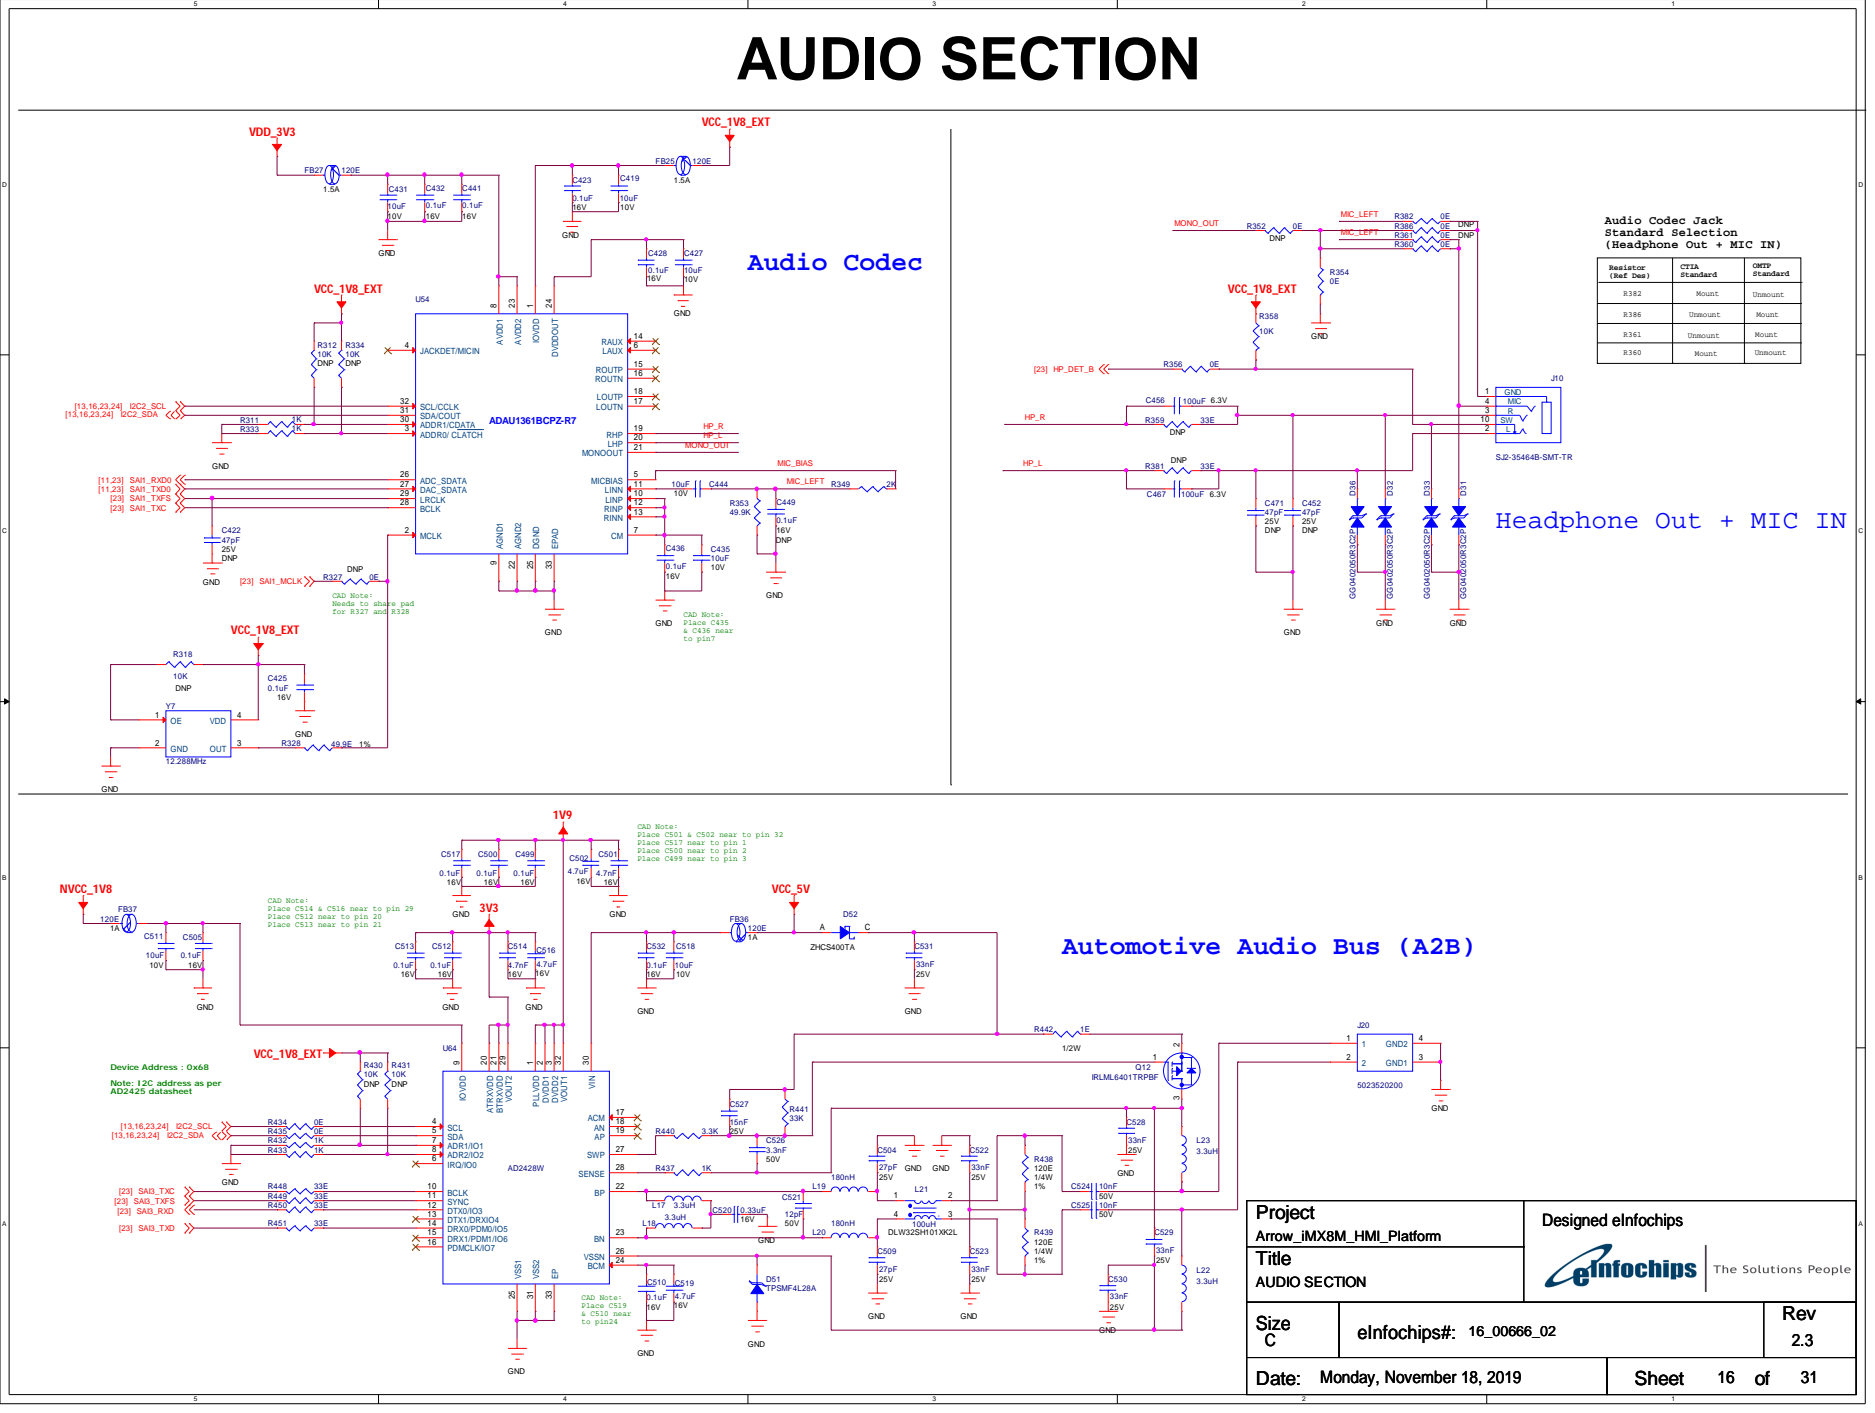
[picture p186: page 16]

Standard Selection
(Headphone Out + MIC IN)

Headphone Out + MIC IN

CAD Note:
Needs to share pad

Place C501 & C502 near to pin 32
Place C517 near to pin 1
Place C500 near to pin 2
Place C499 near to pin 3

Place C514 & C516 near to pin 29
Place C512 near to pin 20
Place C513 near to pin 21

Note: I2C address as per
AD2425 datasheet

# USB HUB CONTROLLER

# VOLTAGE LEVEL TRANSLATOR

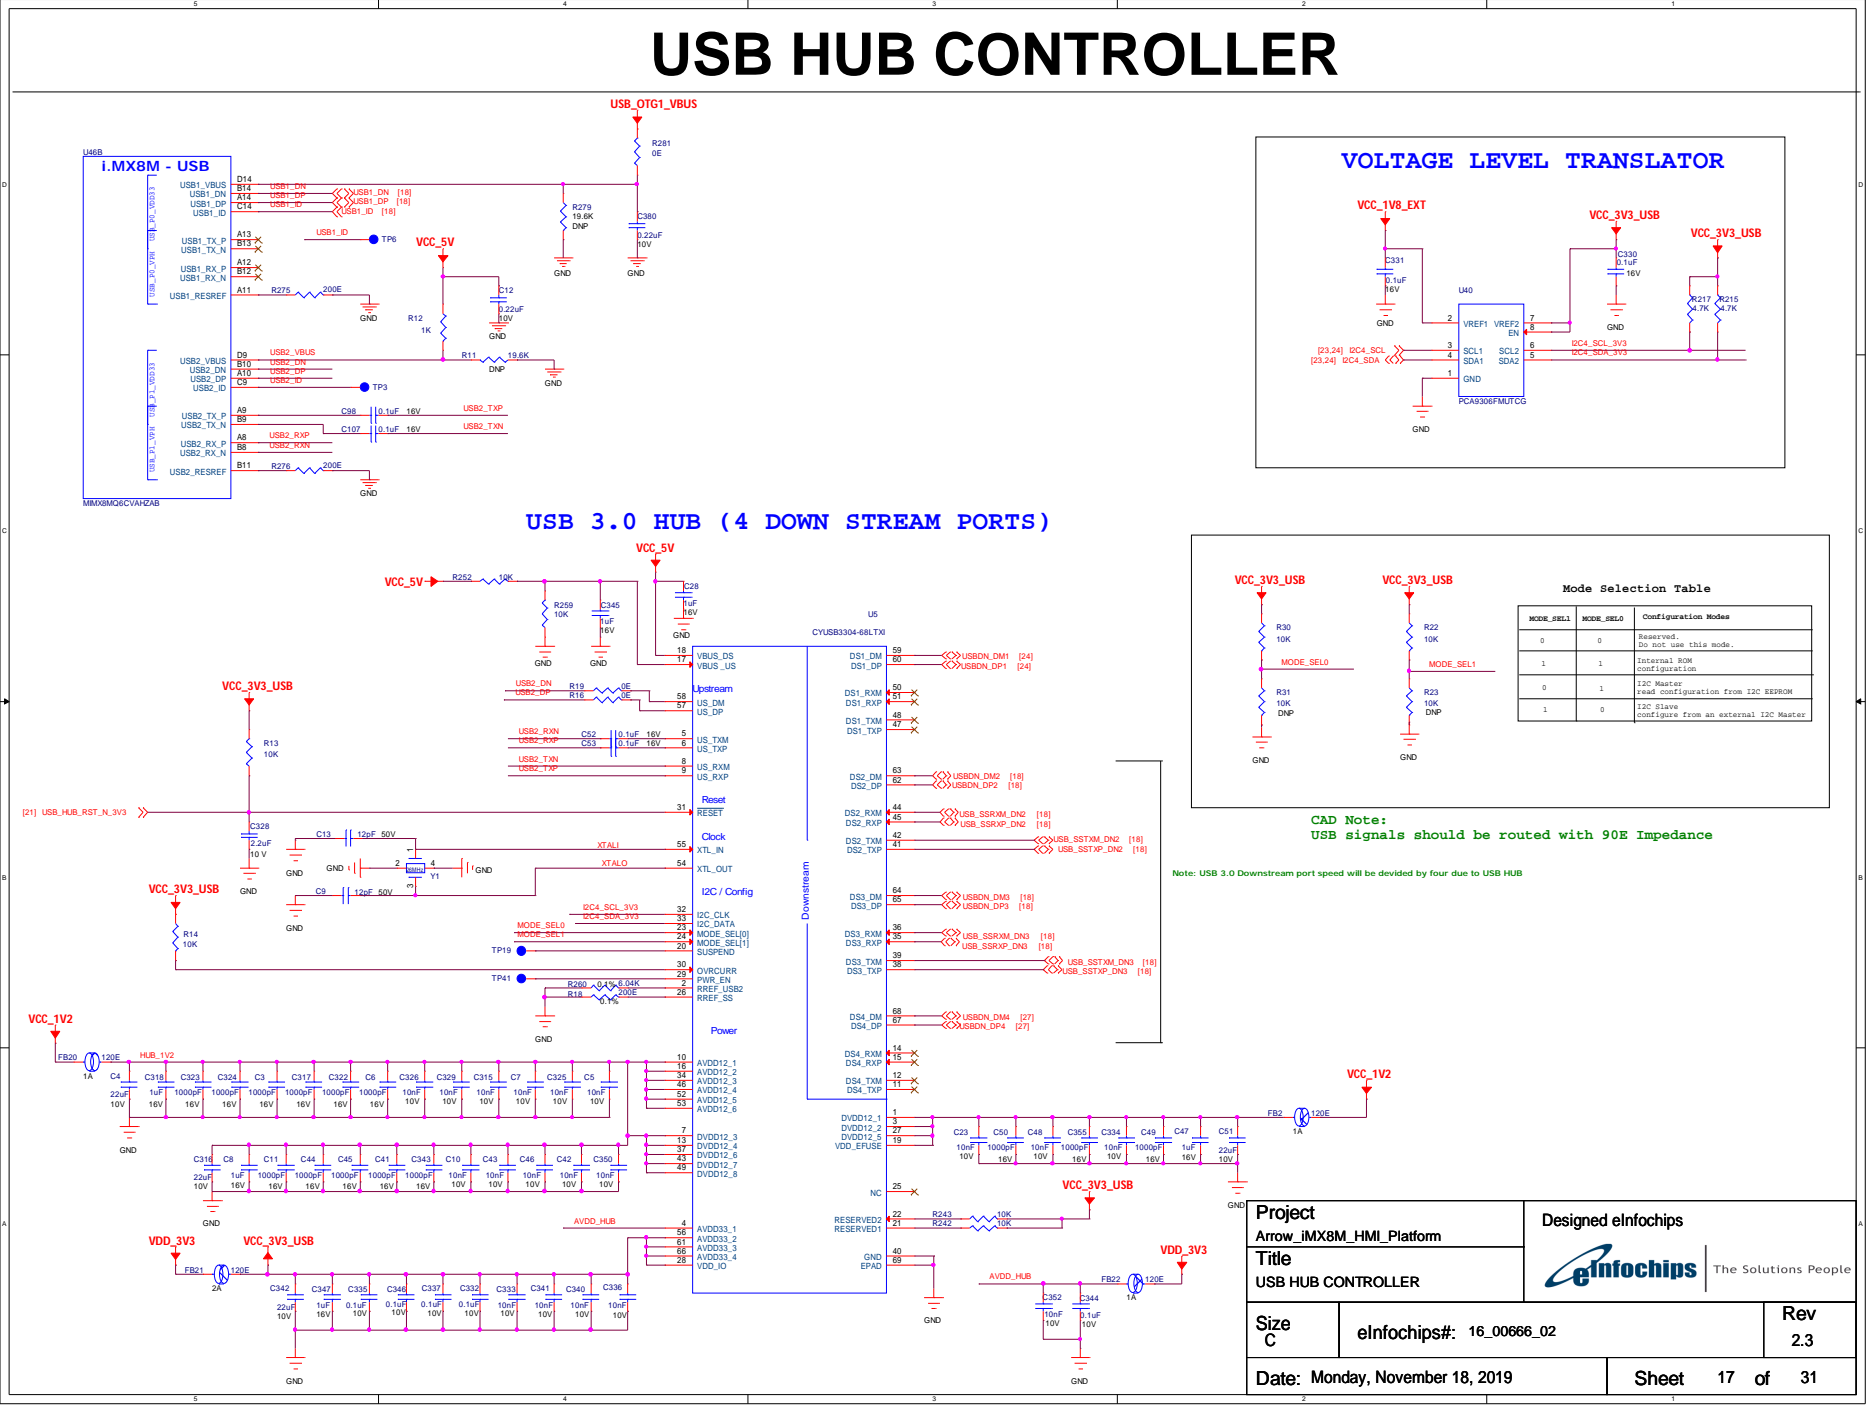
[picture p187: page 17]

USB 3.0 HUB (4 DOWN STREAM PORTS)

Reserved.
Do not use this mode.

I2C Master
read configuration from I2C EEPROM

I2C Slave
configure from an external I2C Master

CAD Note:
USB signals should be routed with 90E Impedance

Note: USB 3.0 Downstream port speed will be devided by four due to USB HUB

# USB 3.0 TYPE A HOST CONNECTORS

# USB CONNECTORS

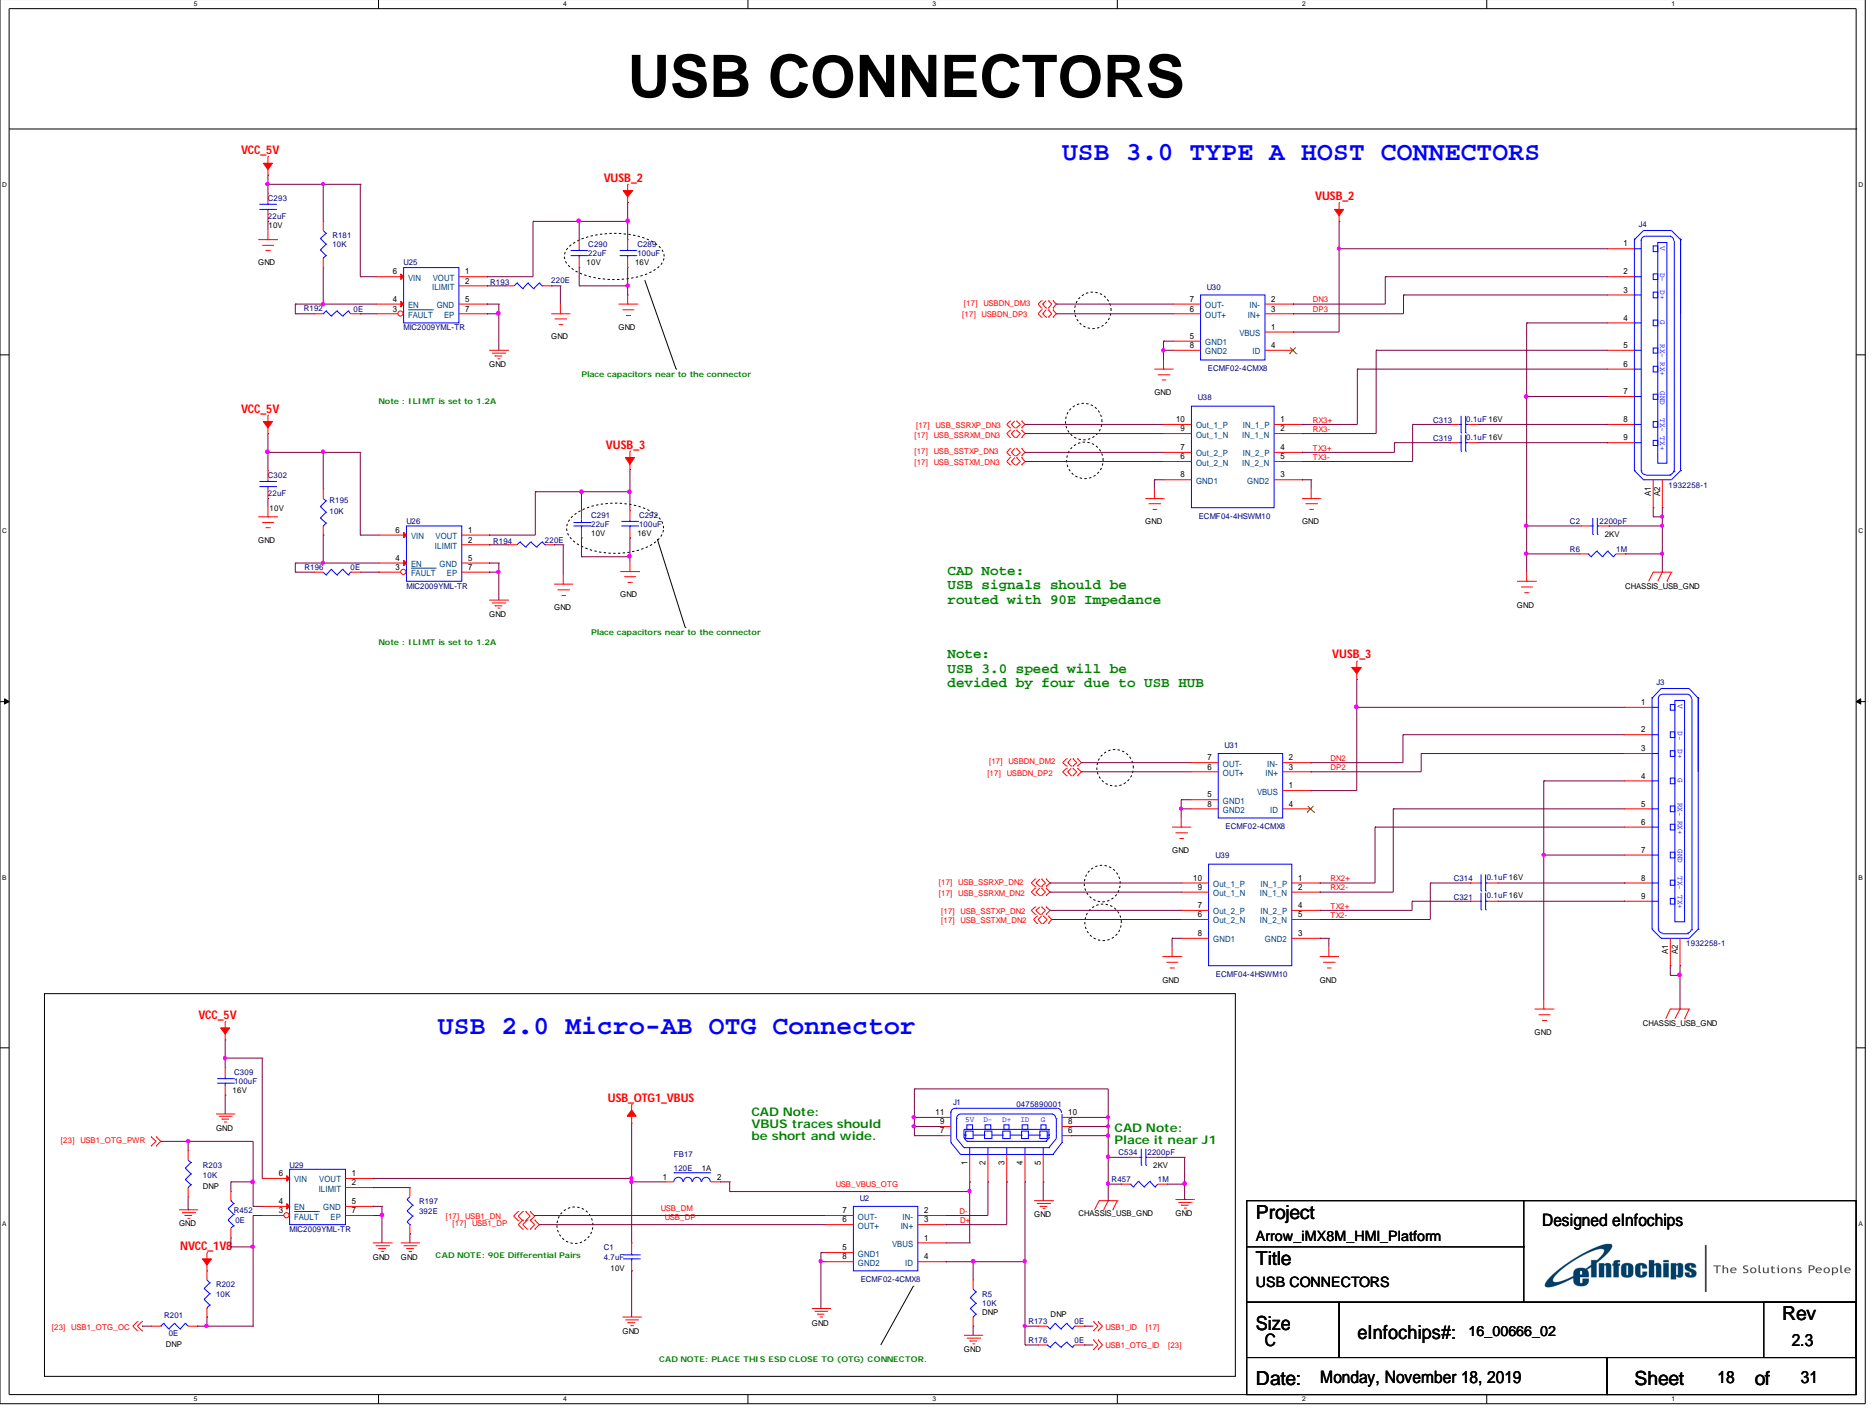
[picture p188: page 18]

V TX+ TX- GND RX+ RX- G D+ D-

Place capacitors near to the connector

Note : ILIMT is set to 1.2A

CAD Note:
USB signals should be
routed with 90E Impedance

Note:
USB 3.0 speed will be
devided by four due to USB HUB

USB 2.0 Micro-AB OTG Connector

CAD NOTE: 90E Differential Pairs

CAD NOTE: PLACE THIS ESD CLOSE TO (OTG) CONNECTOR.

# HDMI CONNECTOR

# HDMI data EMI/ESD

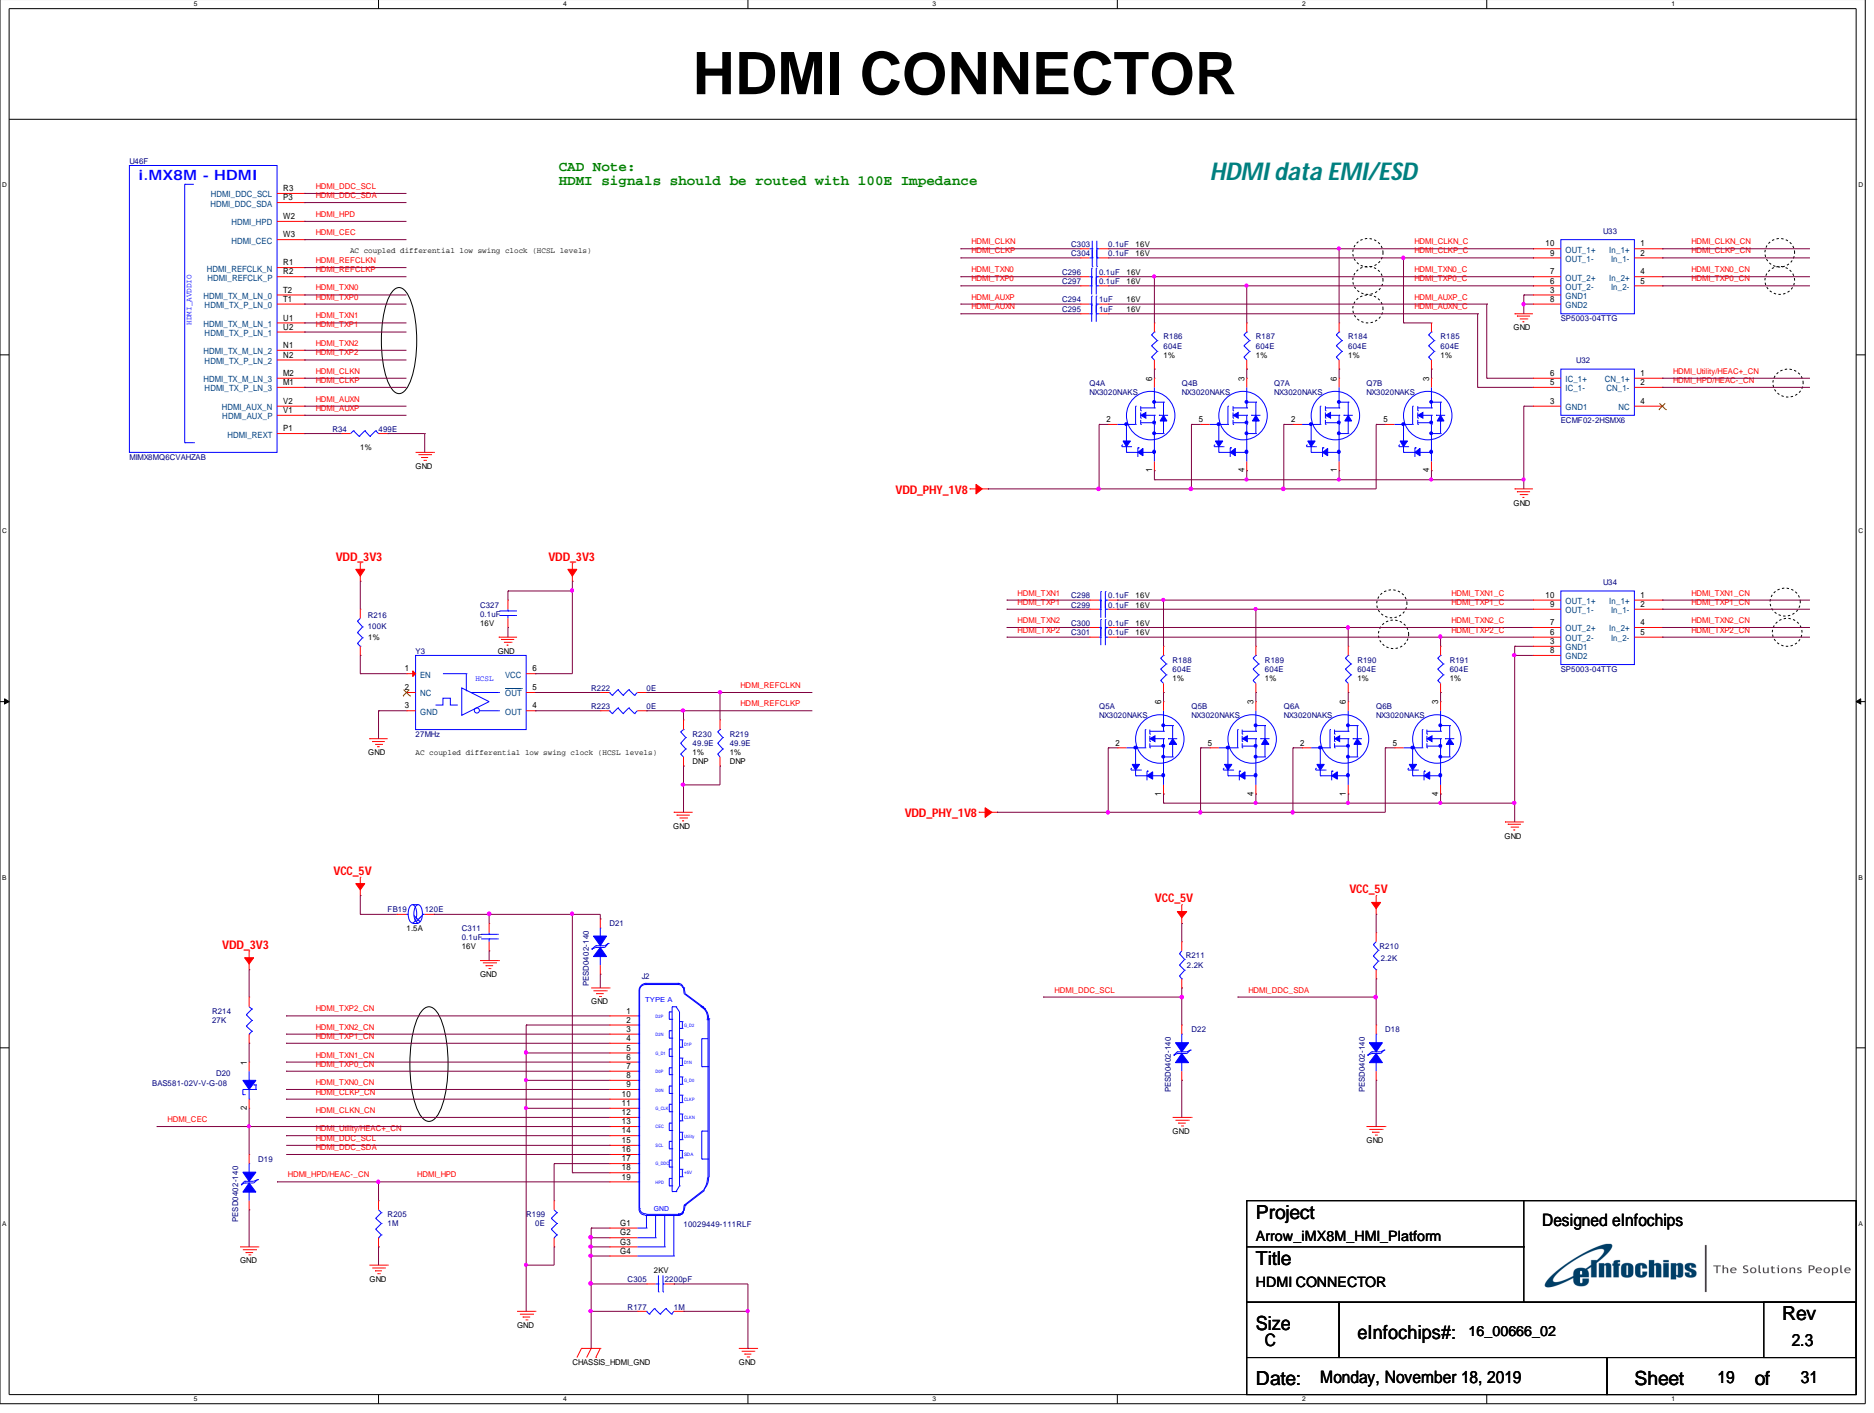
[picture p189: page 19]

CAD Note:
HDMI signals should be routed with 100E Impedance

AC coupled differential low swing clock (HCSL levels)

# Wi-Fi AND BLUETOOTH SECTION

## VDD_3V3

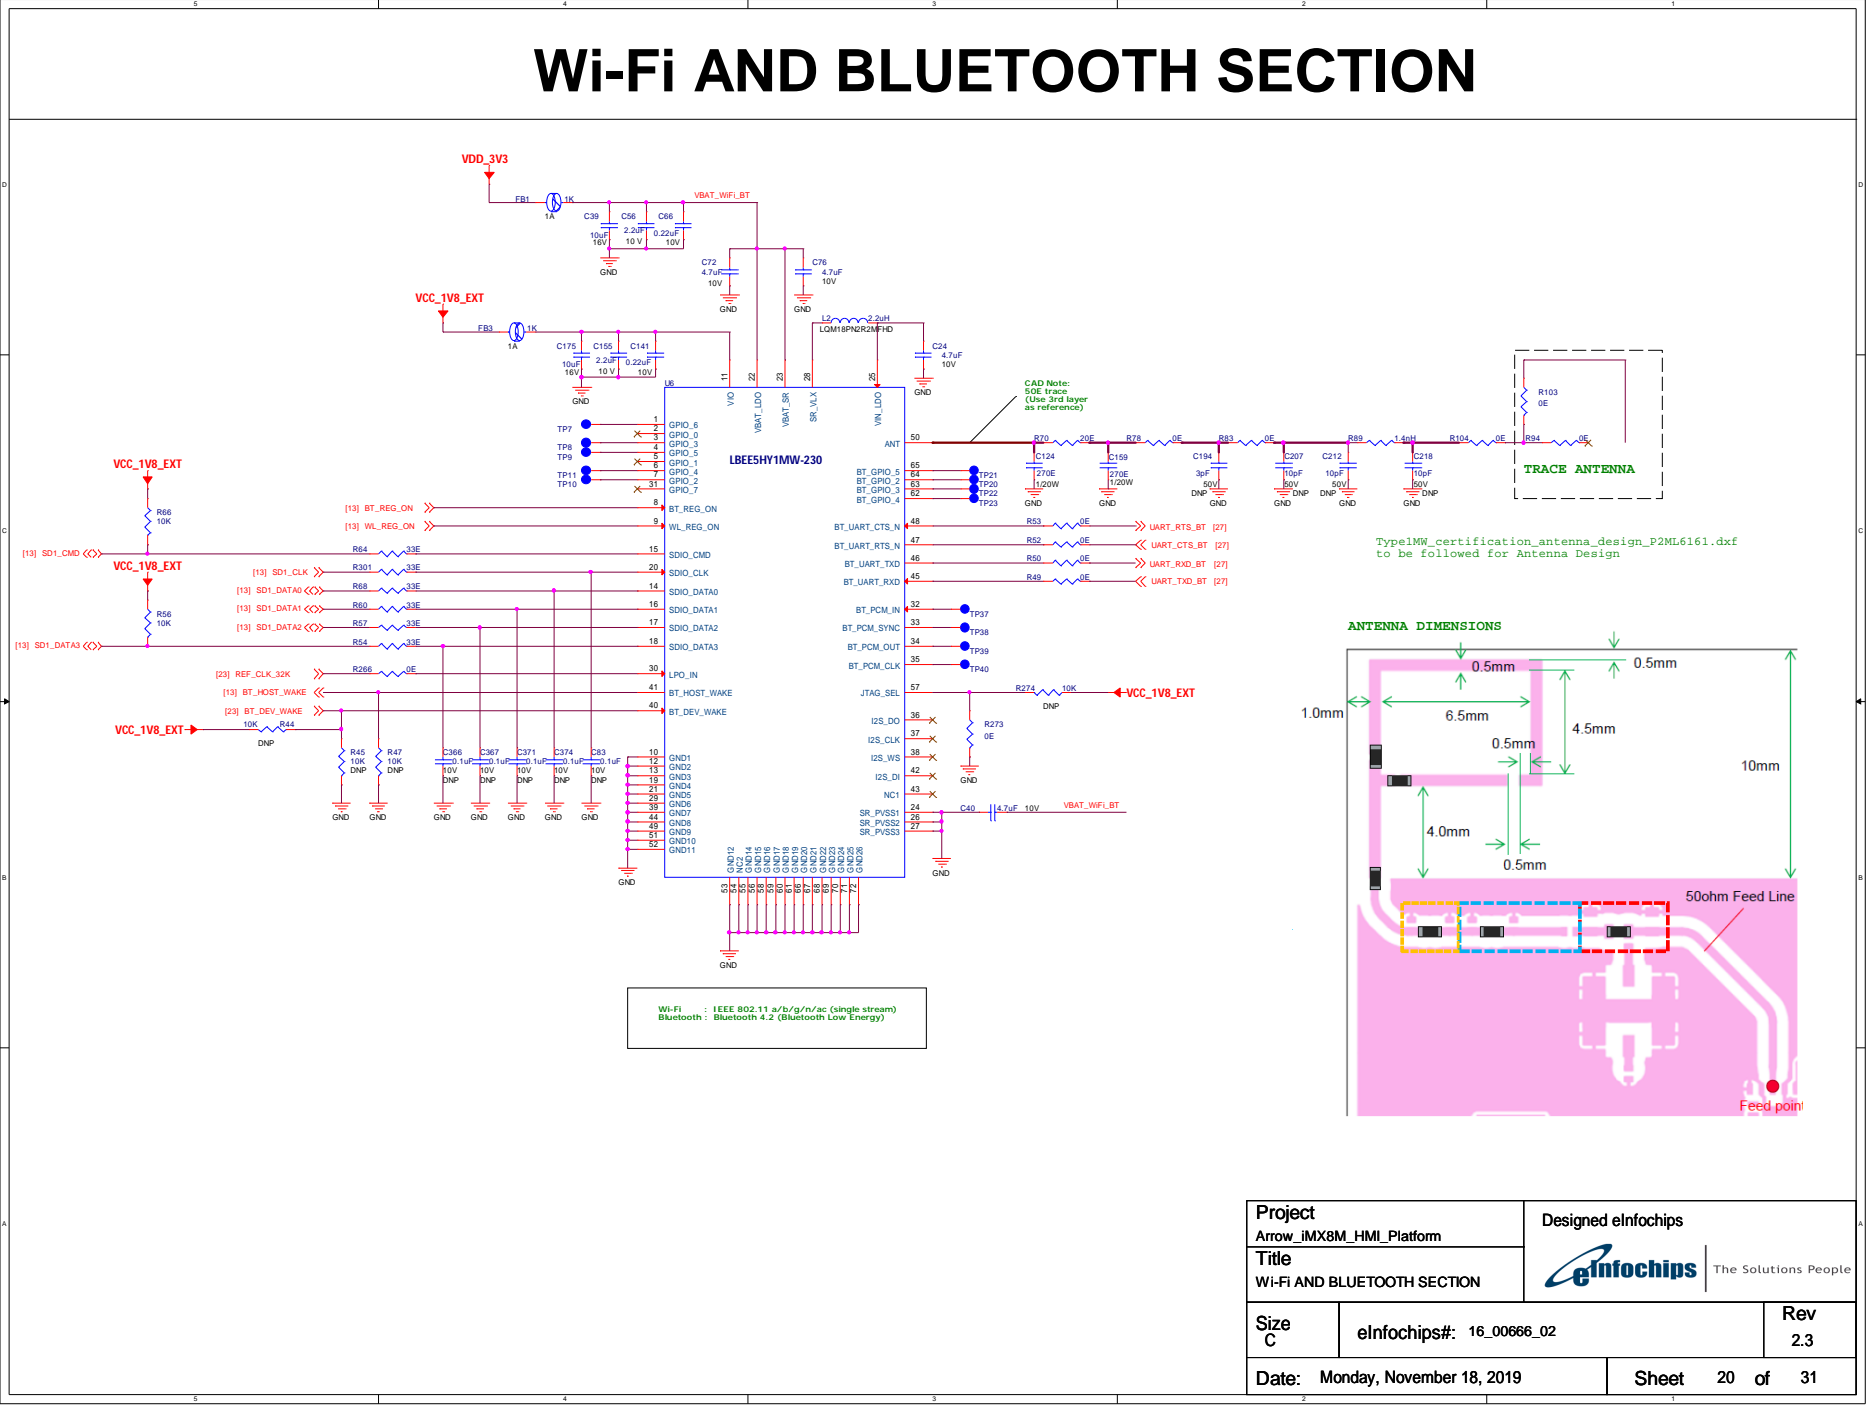
[picture p190: page 20]

Type1MW_certification_antenna_design_P2ML6161.dxf
to be followed for Antenna Design

Bluetooth : Bluetooth 4.2 (Bluetooth Low Energy)

Wi-Fi AND BLUETOOTH SECTION

# ZIGBEE SECTION

## VDD_3V3

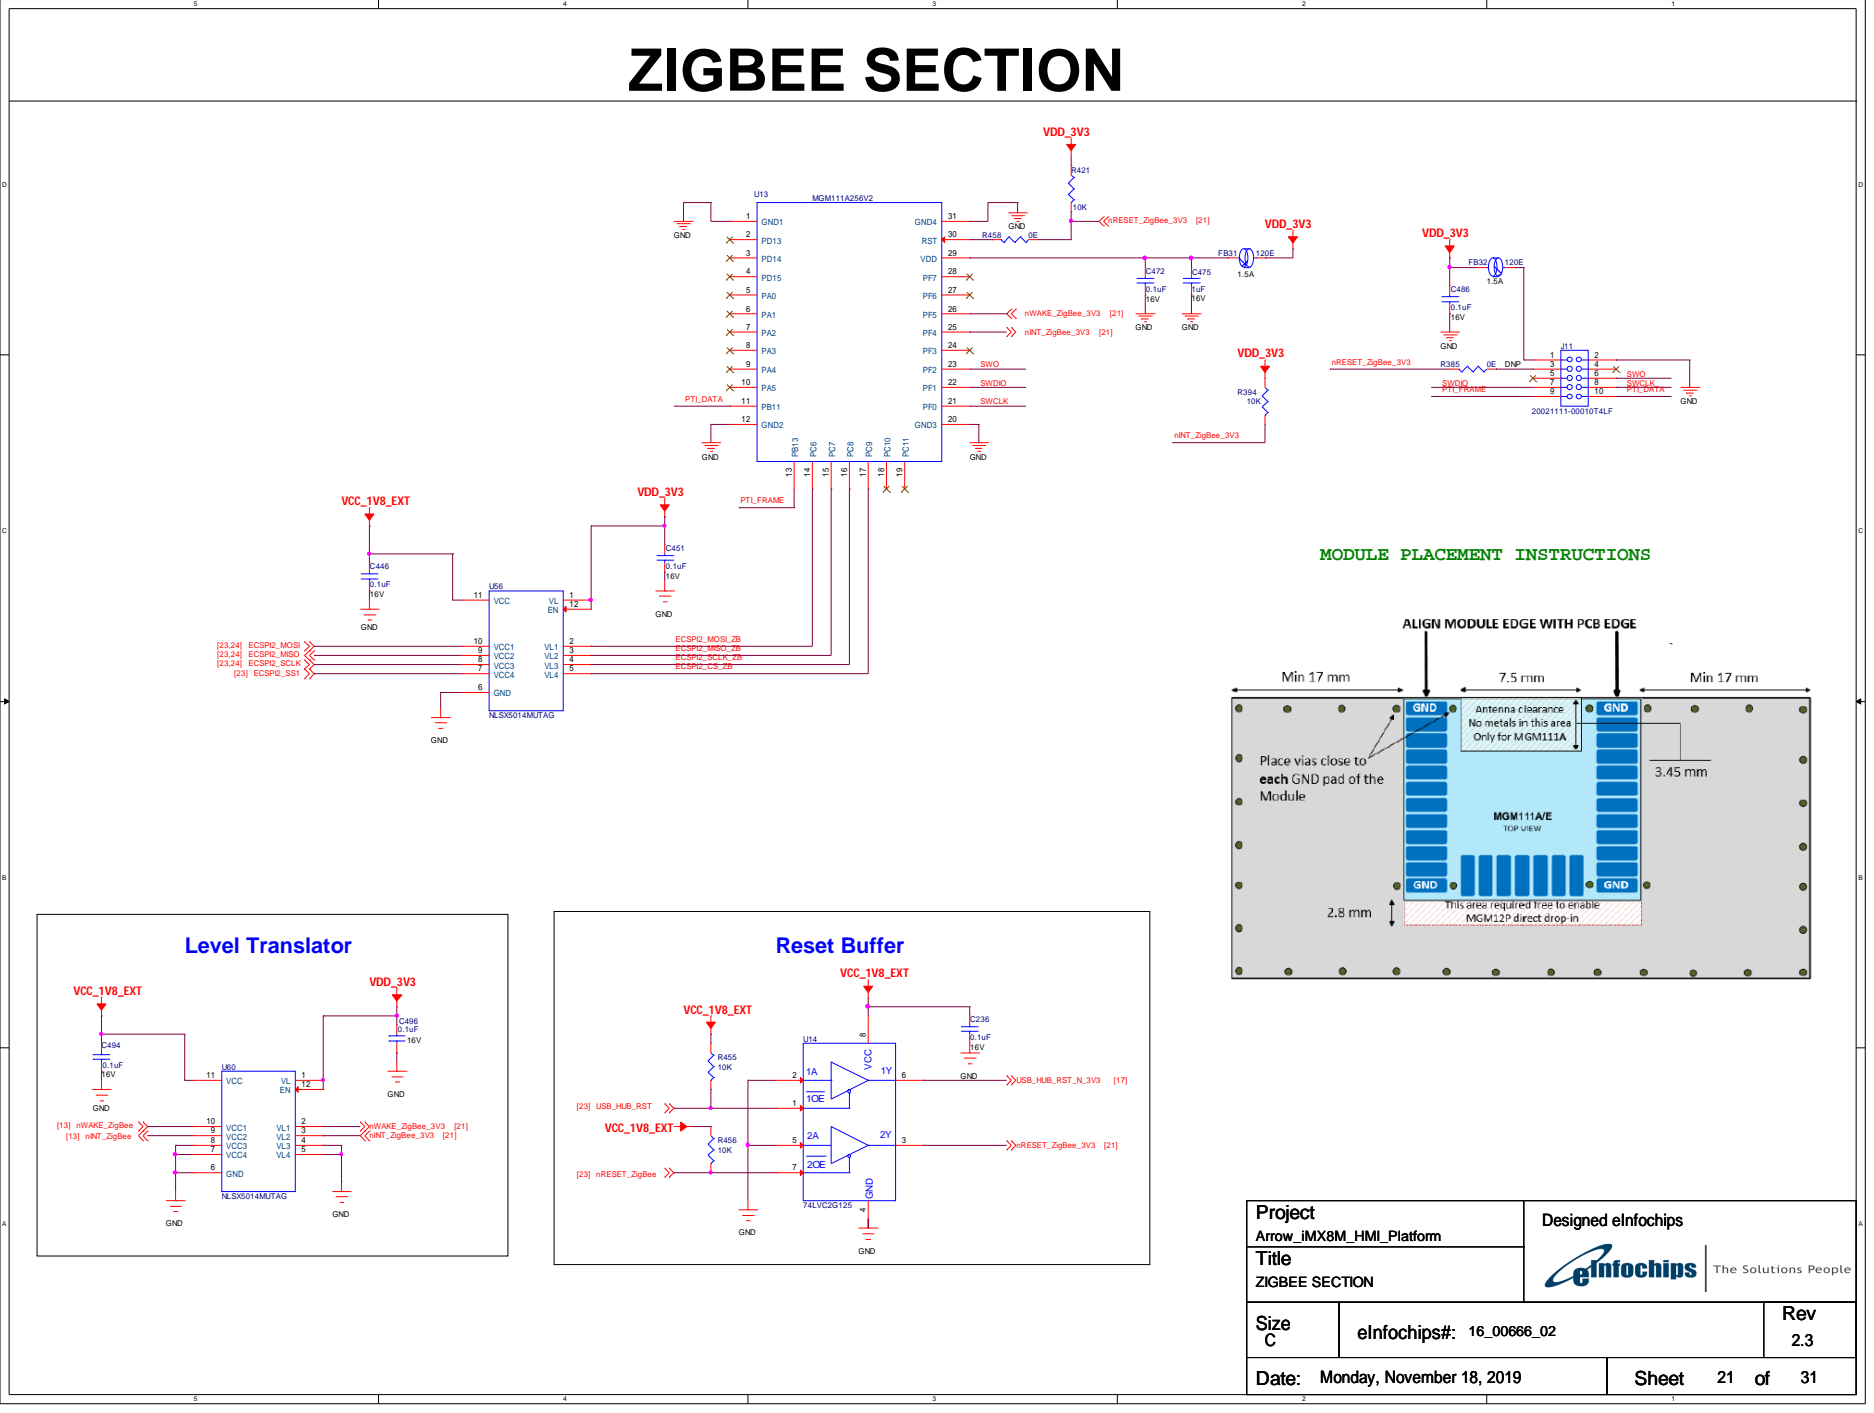
[picture p191: page 21]

# PROCESSOR OTHER INTERFACES1

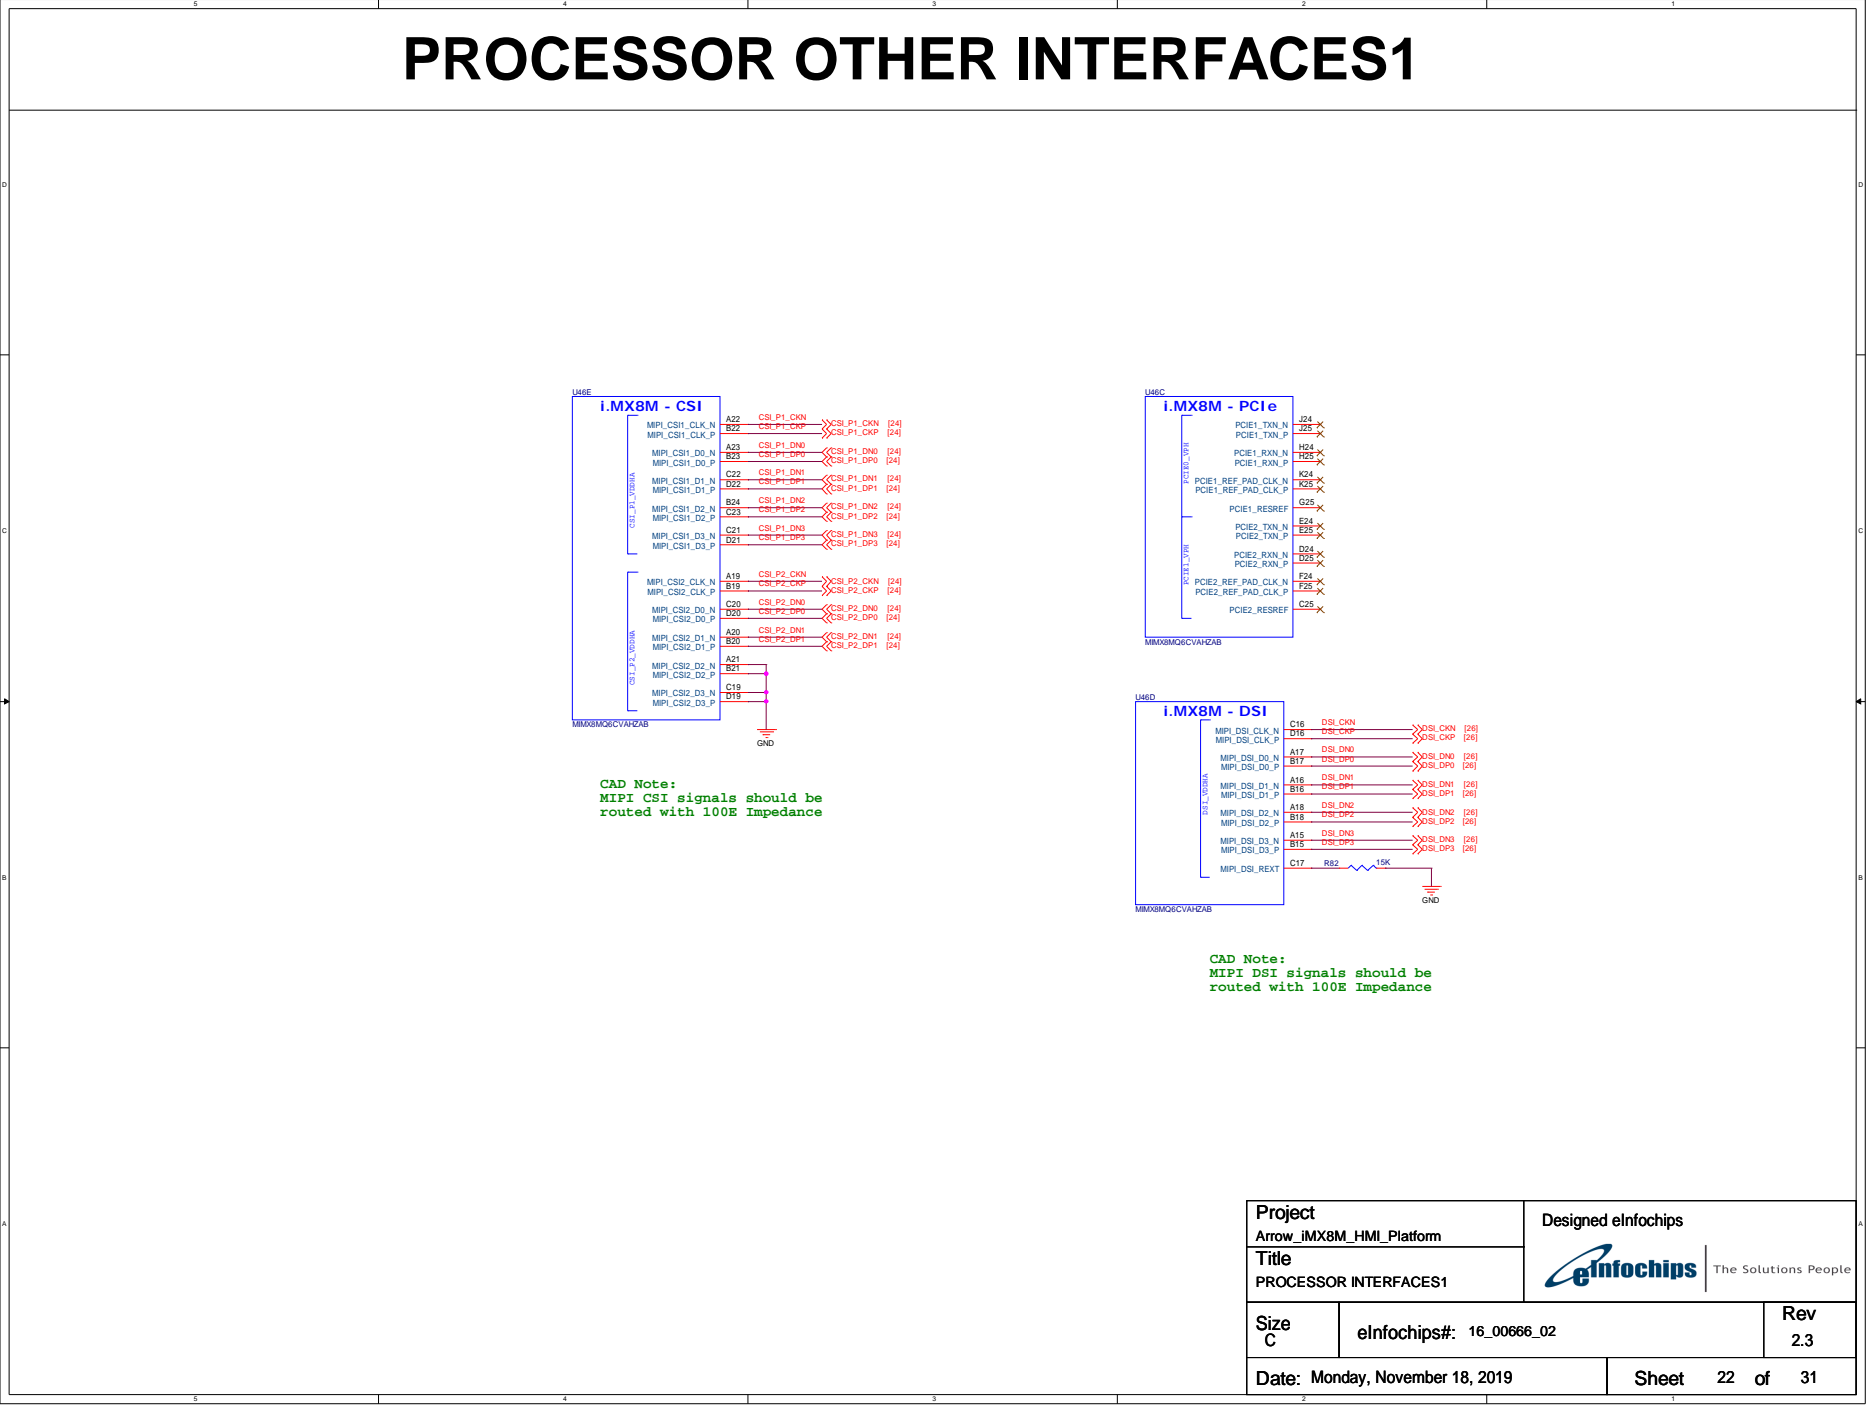
[picture p192: page 22]

CAD Note:
MIPI CSI signals should be
routed with 100E Impedance

MIPI DSI signals should be

# PROCESSOR OTHER INTERFACES2

## CAD Note:

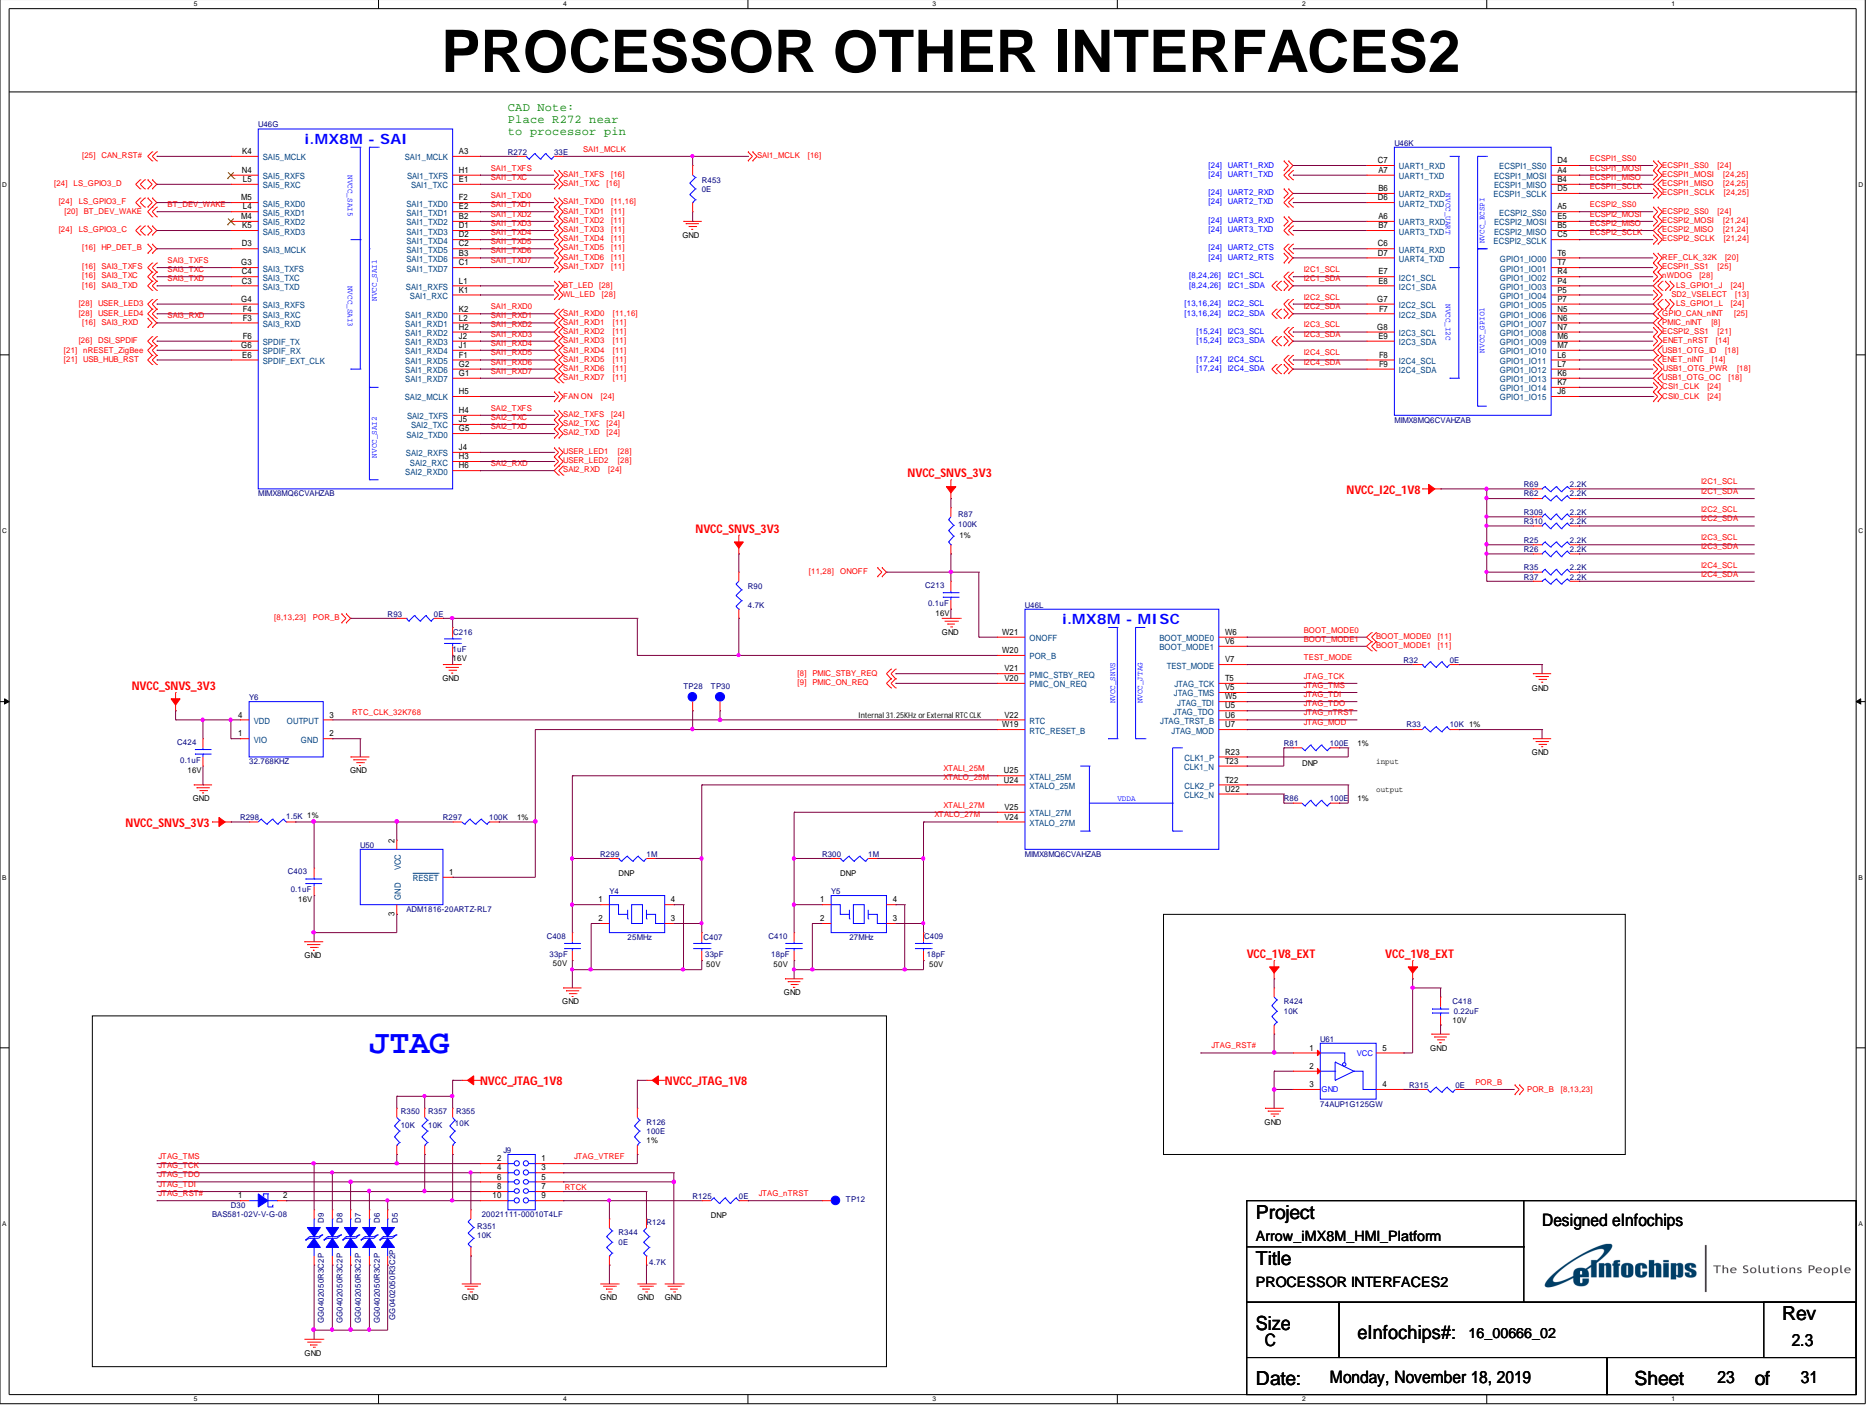
[picture p193: page 23]

Internal 31.25KHz or External RTC CLK

# HS / LS EXPANSION CONNECTOR

# CSI1 EMI FILTERS

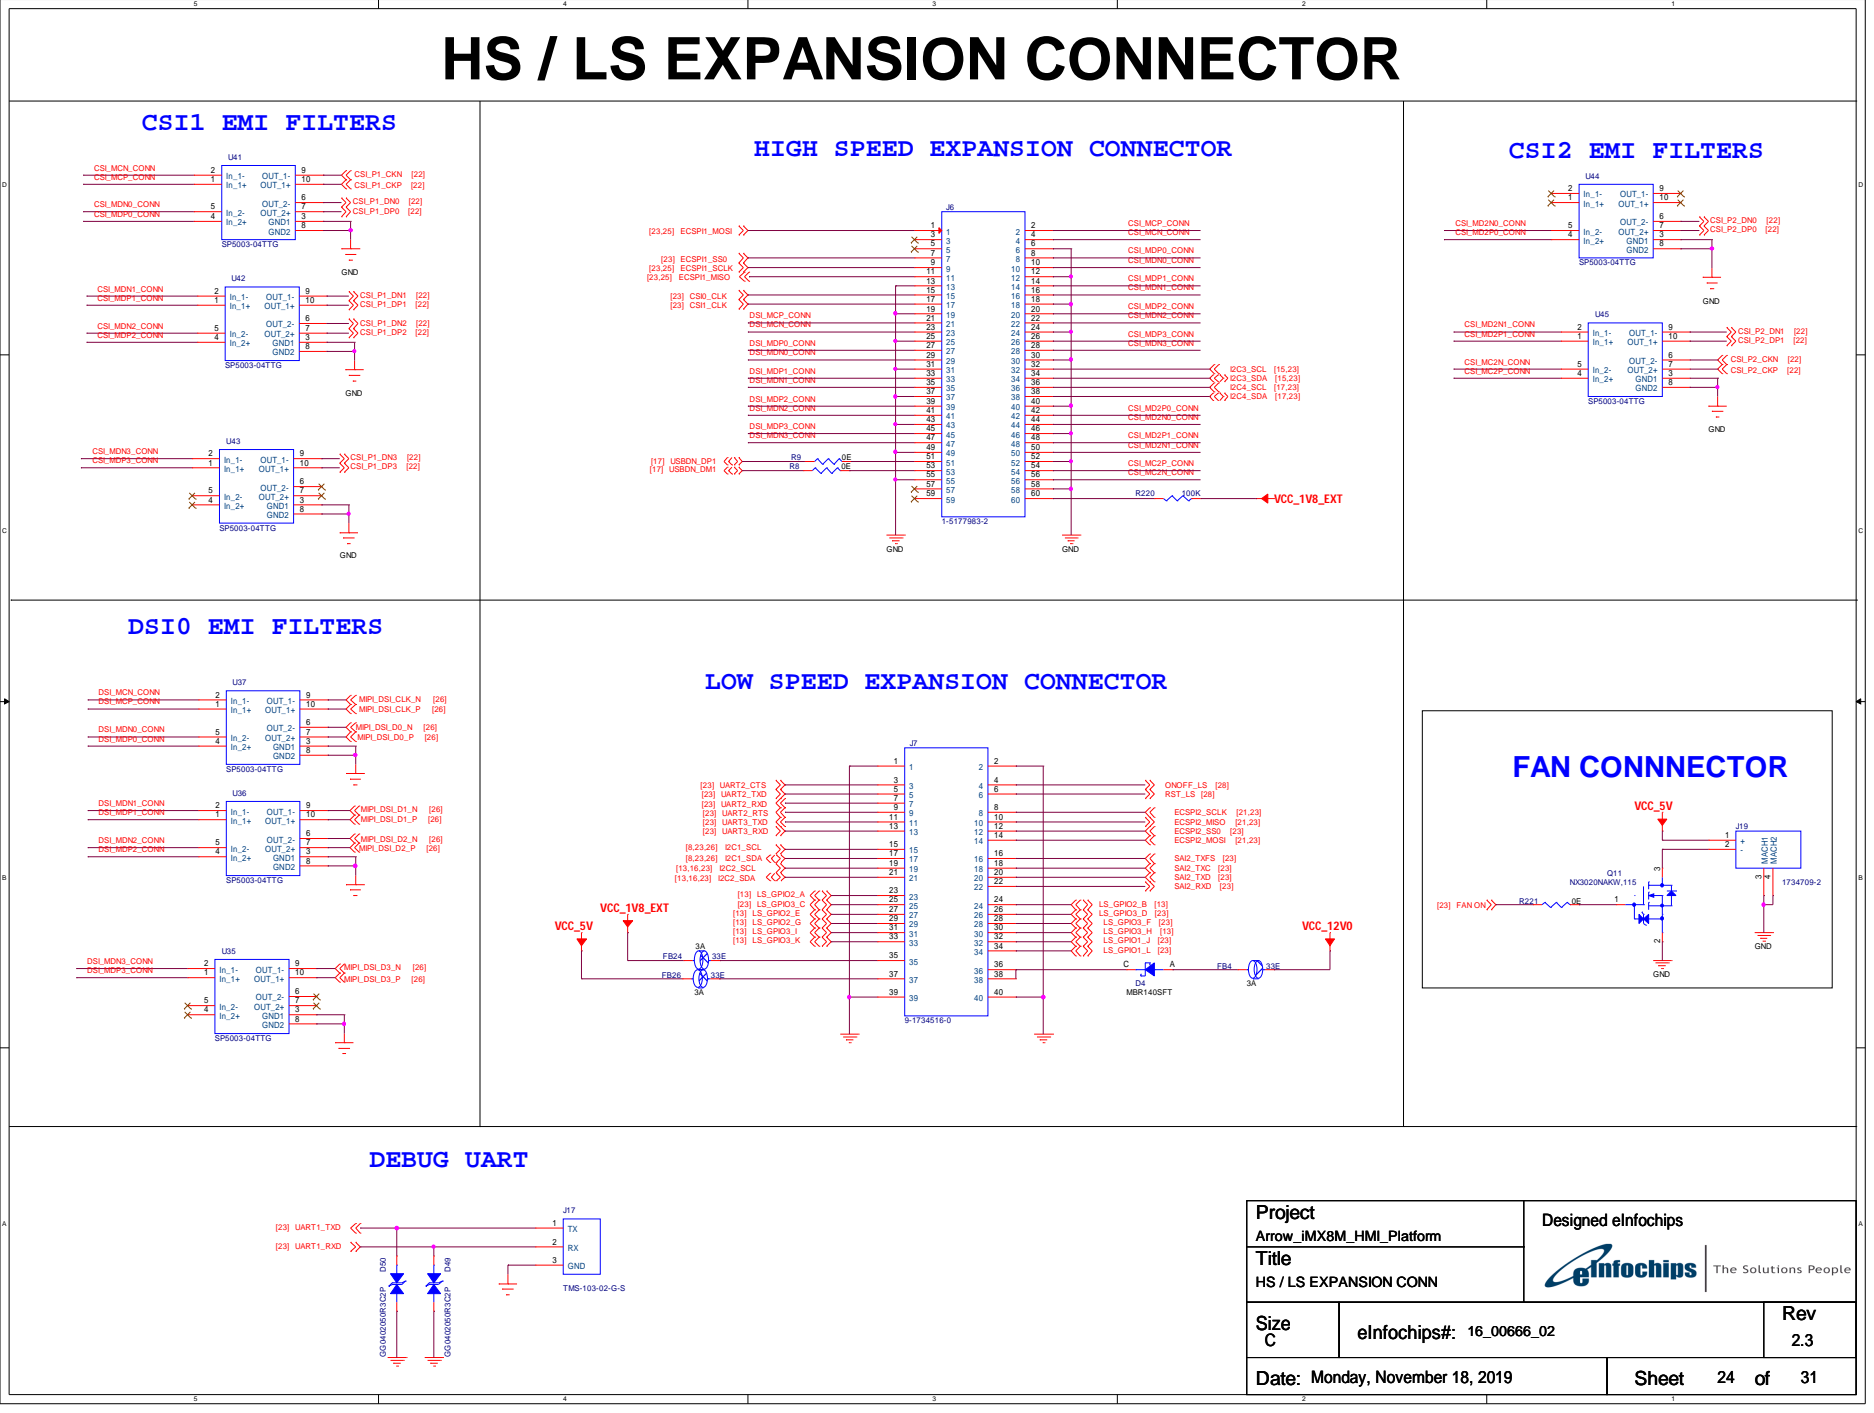
[picture p194: page 24]

HIGH SPEED EXPANSION CONNECTOR

LOW SPEED EXPANSION CONNECTOR

HS / LS EXPANSION CONN

# CAN INTERFACE

# DC-DC ISOLATOR

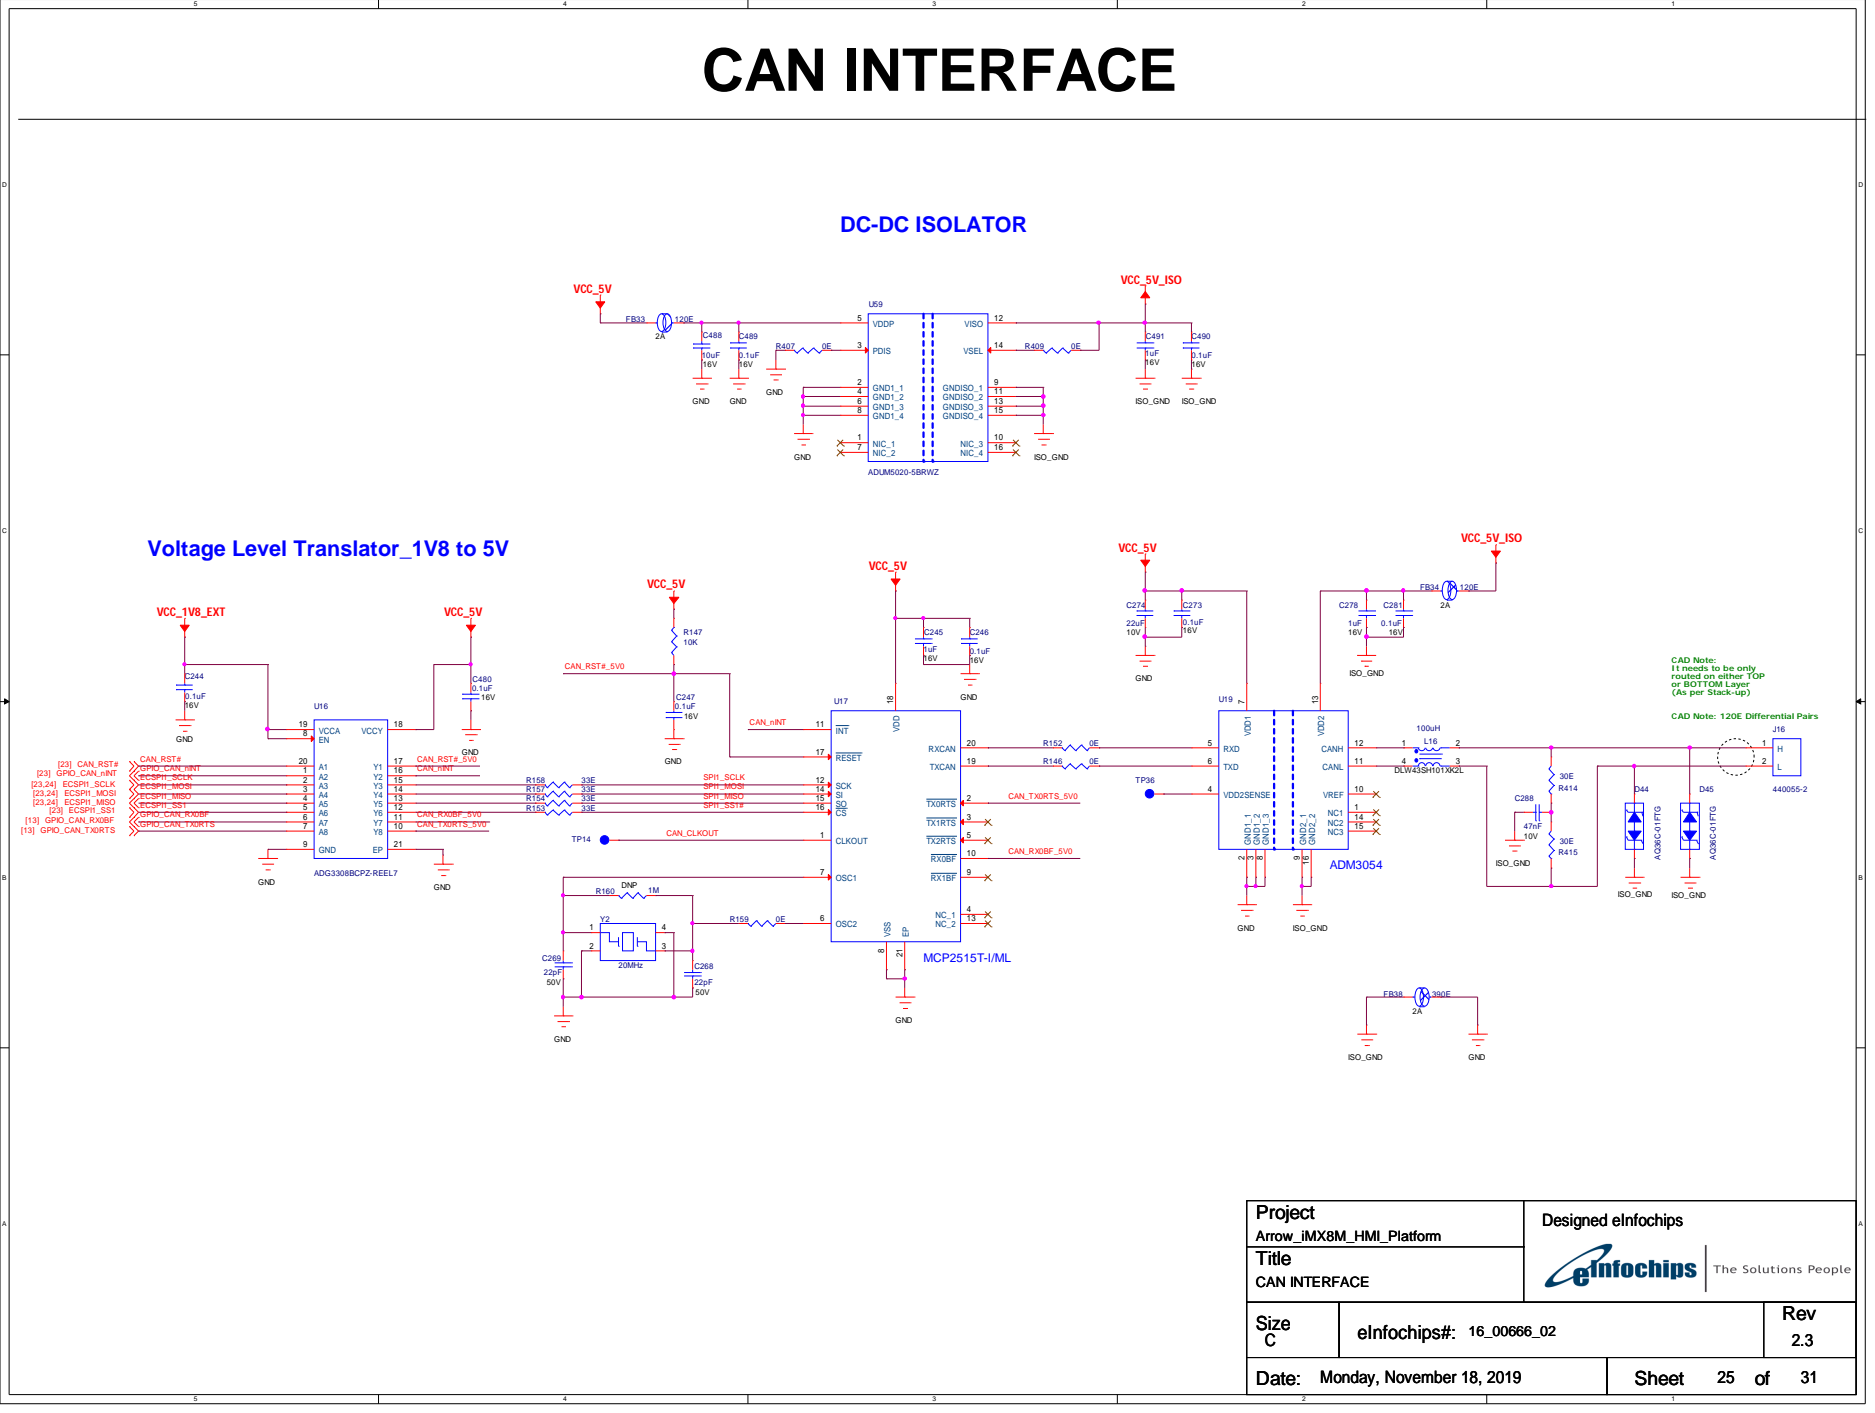
[picture p195: page 25]

CAD Note:
It needs to be only
routed on either TOP
or BOTTOM Layer
(As per Stack-up)

CAD Note: 120E Differential Pairs

# DSI TO HDMI INTERFACE

## CAD Note:

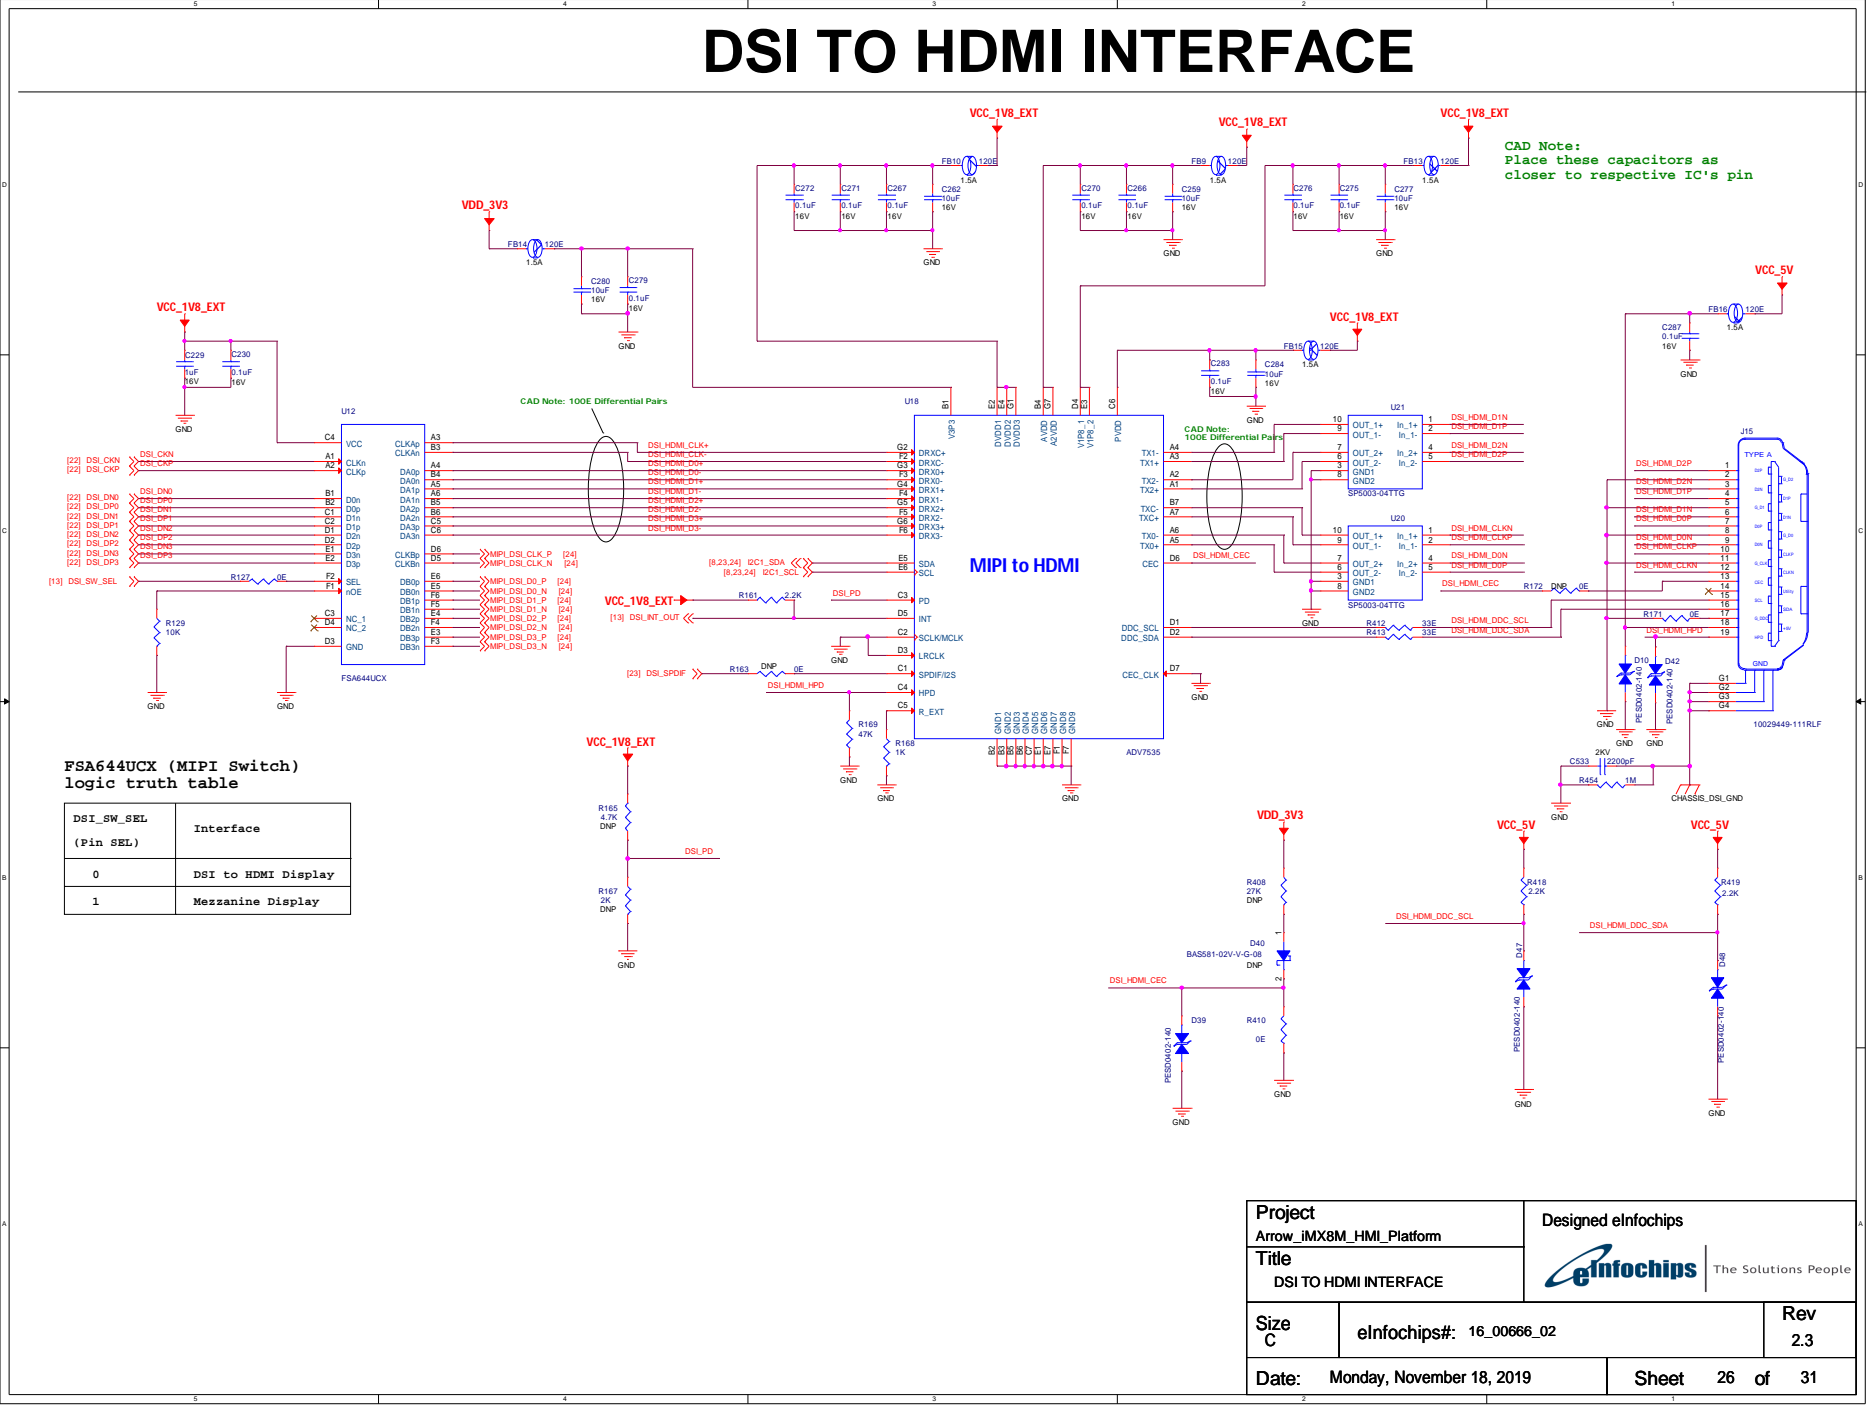
[picture p196: page 26]

Place these capacitors as
closer to respective IC's pin

CAD Note: 100E Differential Pairs

DSI_HDMI_D2N 3 DSI_HDMI_D1P 4 5

DSI_HDMI_D1N 6 DSI_HDMI_D0P 7 8

DSI_HDMI_D0N 9 DSI_HDMI_CLKP 10 11

DSI_HDMI_CLKN 12 13

0 DSI to HDMI Display

DSI TO HDMI INTERFACE

# USB TO UART FOR LS CONNECTOR

## VCC_1V8_EXT

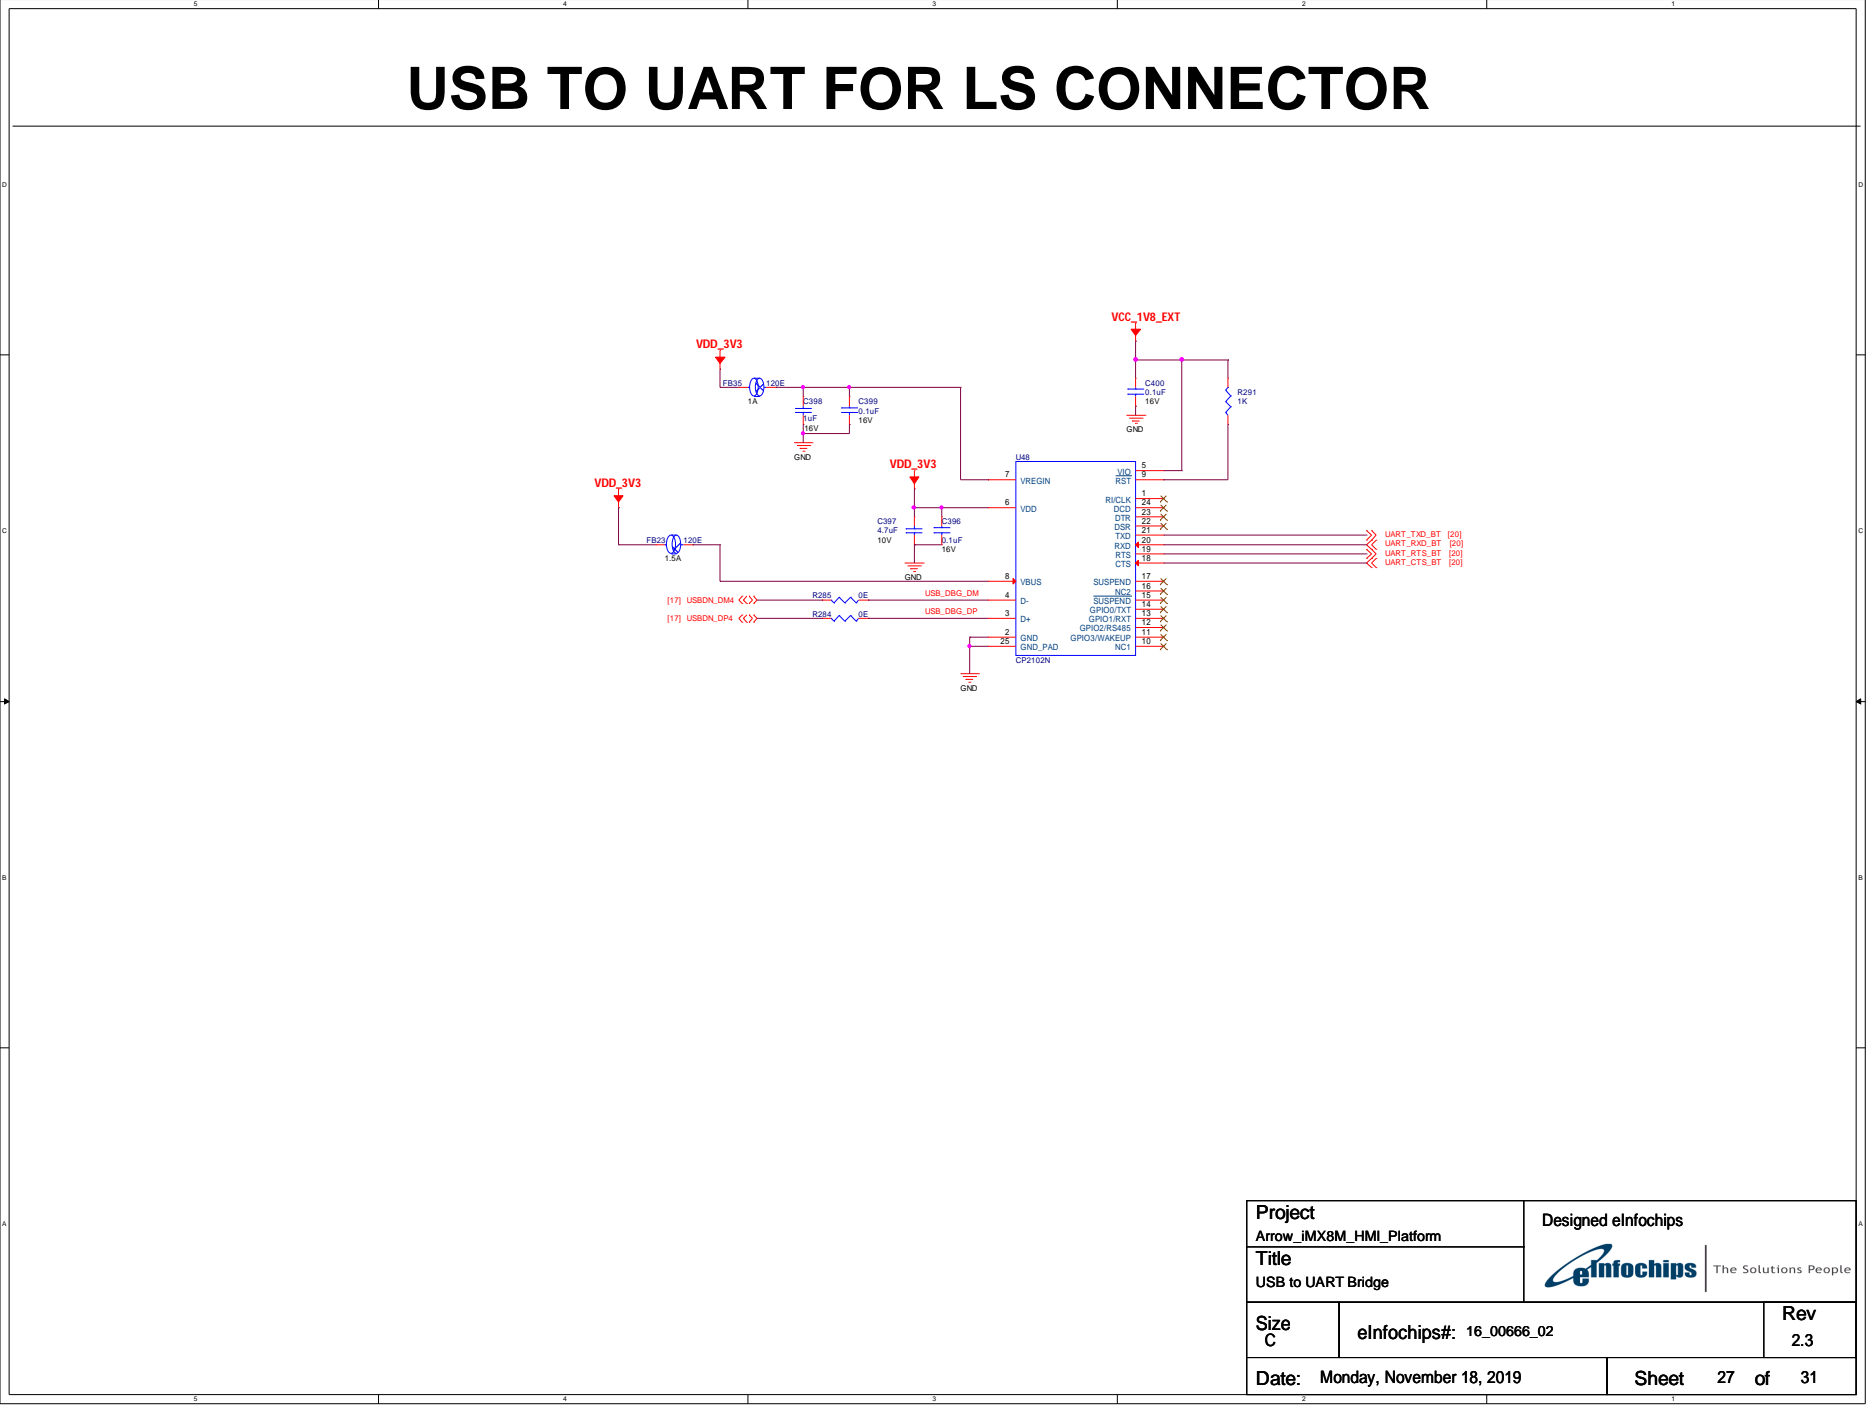
[picture p197: page 27]

USB to UART Bridge

# RESET SCHEME AND LED

# BLUETOOTH BLUE LED

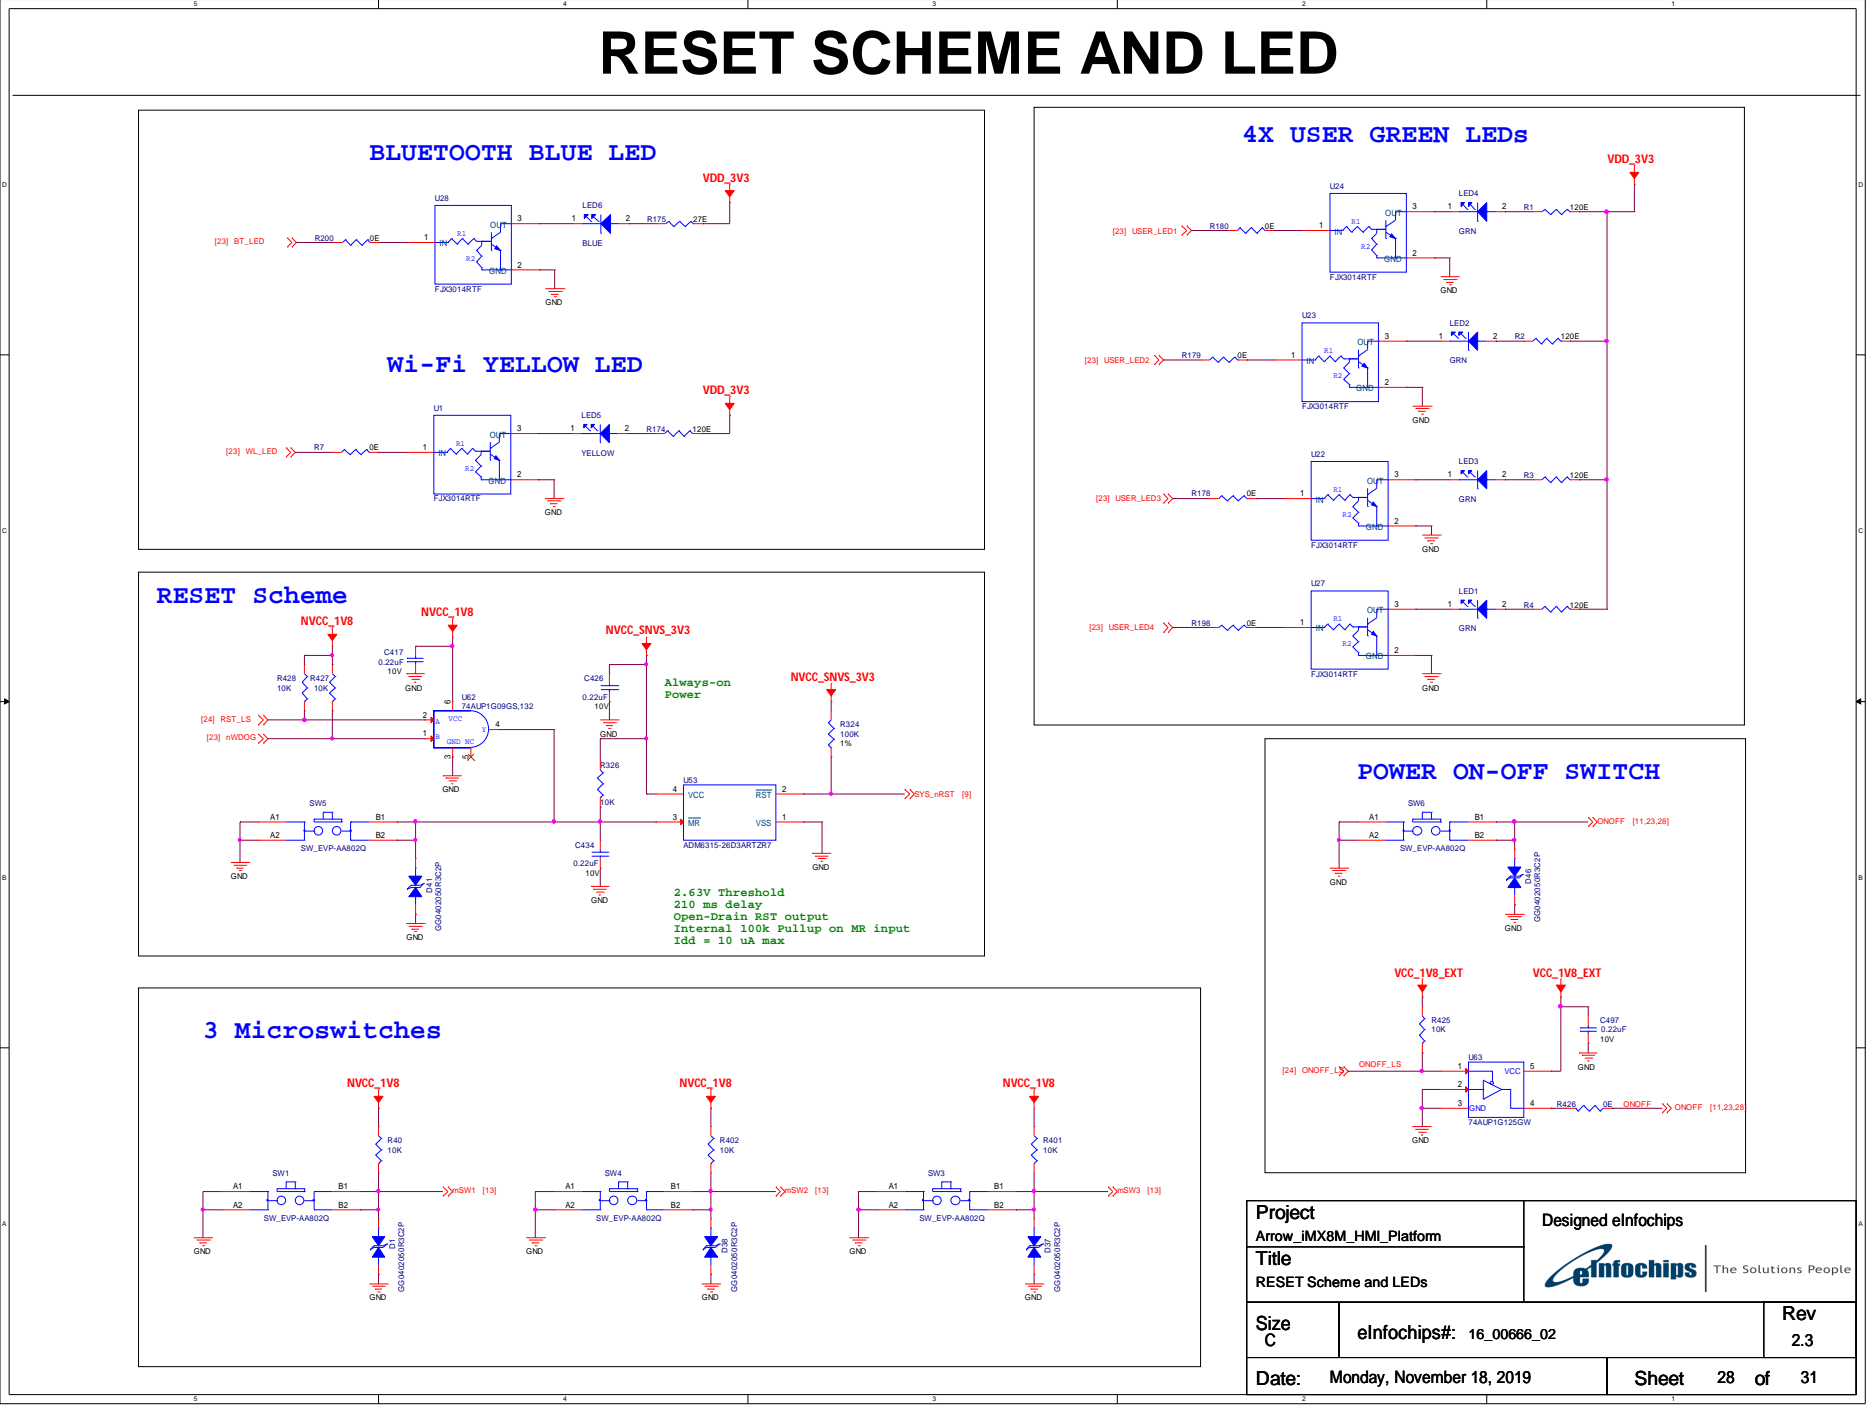
[picture p198: page 28]

Wi-Fi YELLOW LED

POWER ON-OFF SWITCH

2.63V Threshold
210 ms delay
Open-Drain RST output
Internal 100k Pullup on MR input
Idd = 10 uA max

RESET Scheme and LEDs

# Mounting Holes

# MISCELLANEOUS

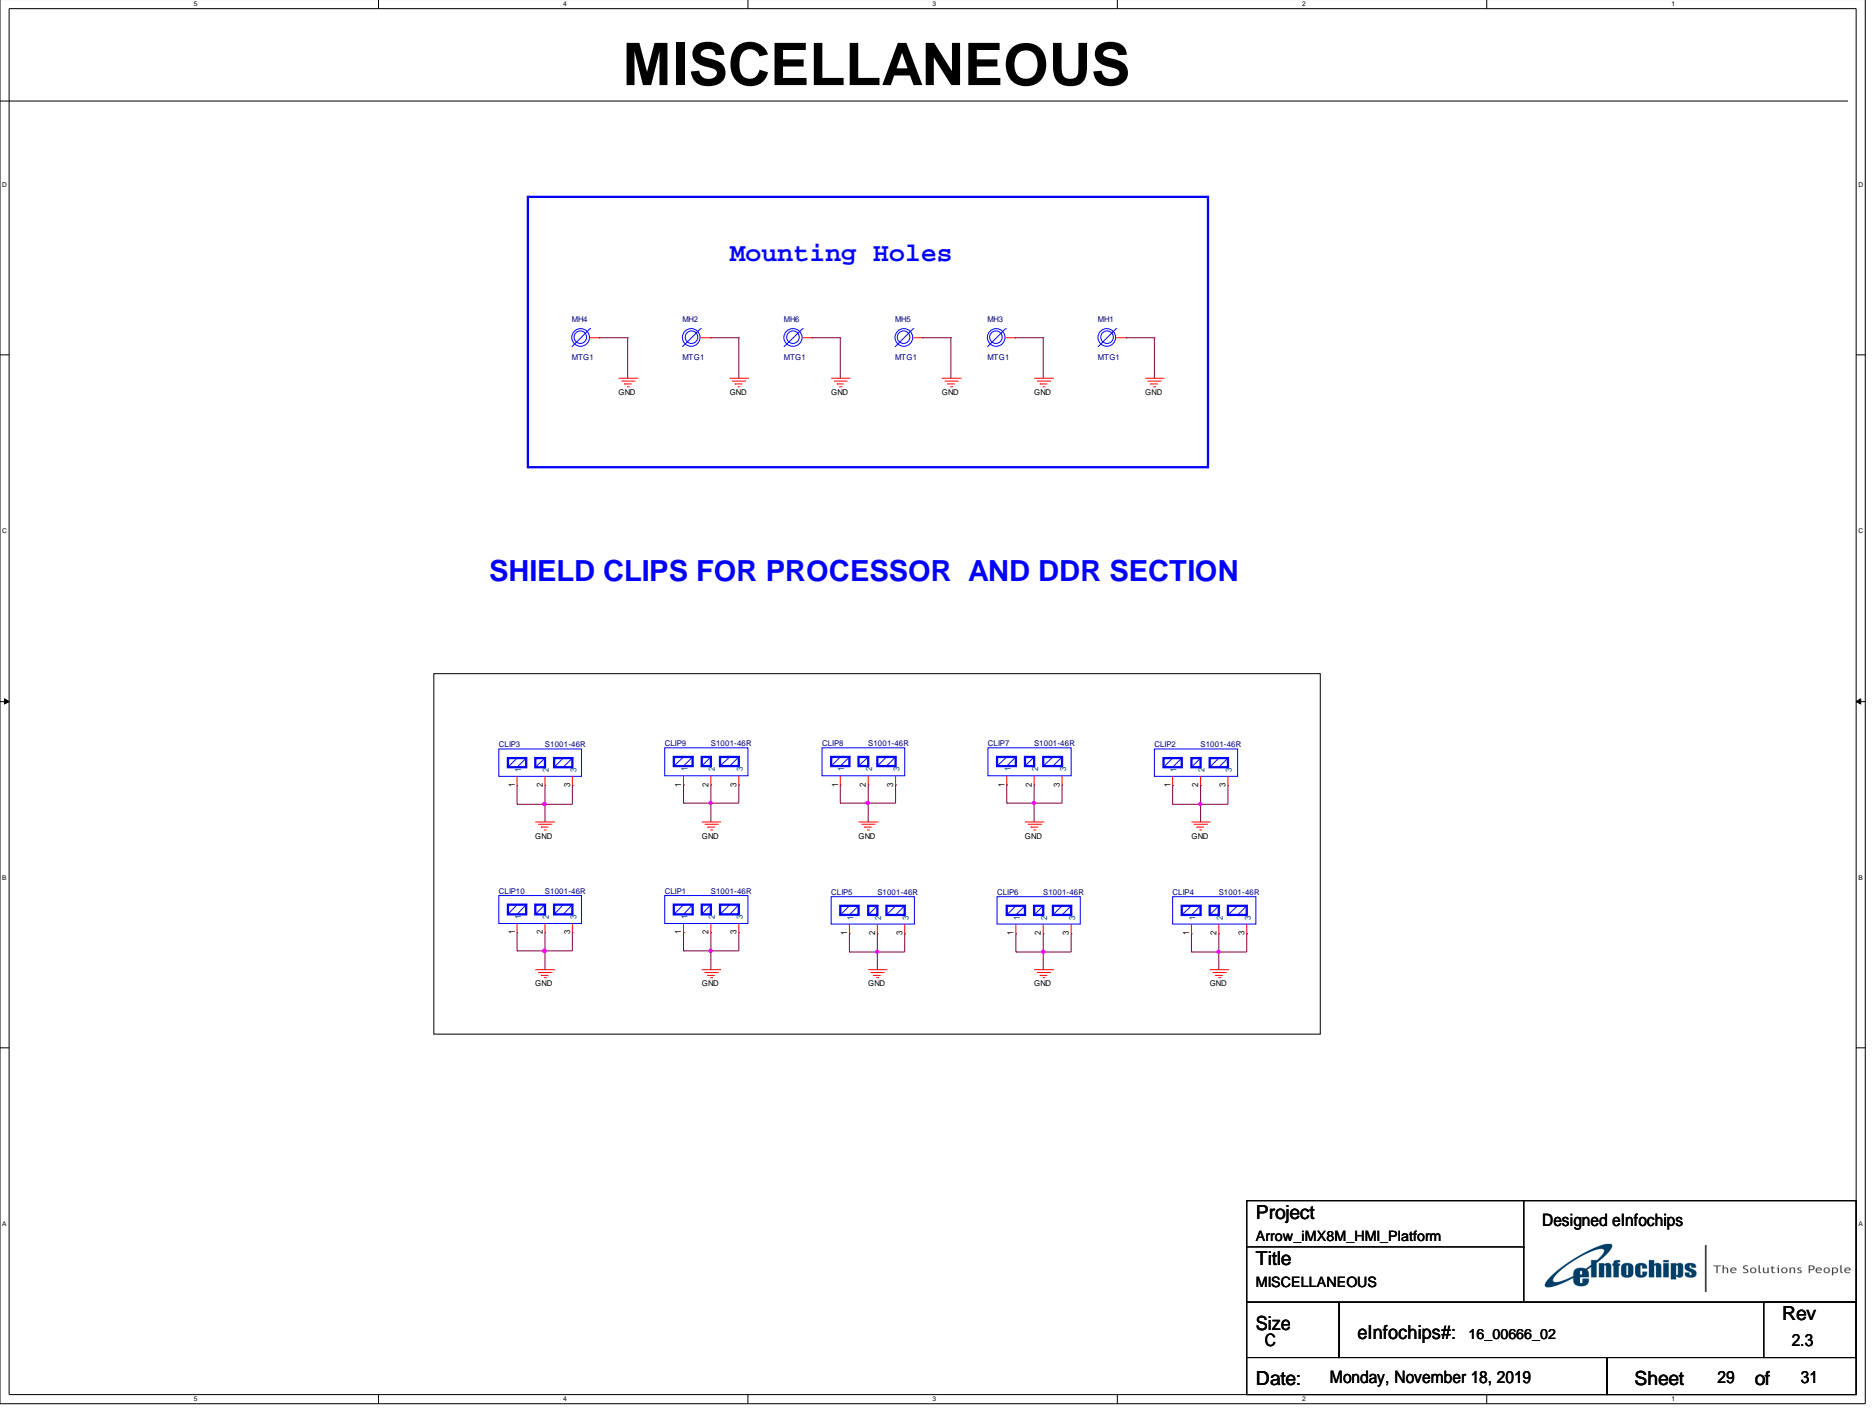
[picture p199: page 29]
GND; Title; Project; Designed eInfochips; Monday, November 18, 2019; Arrow_iMX8M_HMI_Platform; MISCELLANEOUS; CLIP1; CLIP4; MTG1; CLIP6; CLIP5; CLIP2; CLIP3; CLIP8; CLIP7; CLIP10; CLIP9

SHIELD CLIPS FOR PROCESSOR AND DDR SECTION

D | D
C | C
B | B
A | A
PCB REV | SCH REV | CHANGE DESCRIPTION | DATE | AUTHOR
| 0.1 | Initial draft version created for internal review | 13/08/2018 | eInfochips

# REVISION HISTORY1

0.2 | U7 part changed to MCP6561T, related circuitry changed and added N channel MOSFET | 25/08/2018 | eInfochips
| SW1 and SW2:SW6 part changed for smaller footprints
| ESD added on JTAG connector and R329, R330, R331 are mounted | | eInfochips
| Net name updated for CSI signals on page 24 ; L2 part number changed

0.3

Pull up provision removed for SD card signals ; R1764, R1765 pull down added at HPD pin of HDMI

# Reverse protection diode D803 for 12V mezzanine supply added Y502 changed to 20MHz ; C456 & C457 values changed to 16pF ; Removed U60

22uF and 220uF caps to be changed to smaller package ; L9,L10 parts changed for less height

1uF/16V changed to 0402 package ; 22uF/10V changed to 0603 package USB HUB Section power capacitors changed to small package Ethernet Section power capacitors changed to small package L3, L9, L10, L11, L12, L19, L20, L21, L104, L702, L703, L704, L705, L707 parts changed C1734, C1735, C1736, C1767 FPs changed to smaller ; Chassis ground changed U4 removed ; Q1603 added ; U603 value changed as per mfg part ; Y501 pin names modified Y3 part changed ; J9 & J20 part number changed ; U244 added ; C2118 added ; R11 removed GPIO table updated ; C2119 added

# Murata review comments implemented ; Analog Devices review comments implemented J8, J9, J15, J16, J23 parts changed and footprints changed

R1815, R1816, R1817 added ; C2138 added ; R510 & R511 changed to 22E ; R1764 & R1765 changed to 1M

# USB to UART IC added ; A71CH Security IC added ; EEPROM part changed ADP2386 changed to LT8642S and respective passive components changed

# NXP review comments implemented ; Microchip Technology review comments implemented

Changed C12 to 2.2uF ; R510, R511 mounted ; R512,R513 changed to DNP ; Deleted PCIe supplies to processor Removed C521,C526,C524 ; Changed C529, C530 to 33pF ; Added 10K pull-down on net ENET0_RGMII_RX_CTL

Changed R455 to DNP ; Moved C562 after divider ; Y11 part changed same as Y401 USB HUB decaps added ; Switch symbol updated ; LED symbol updated ; CAD Notes added NXP review coments implemented ; C396 removed ; C2117 value changed to 100uF Implemented BOM review comments from Internal team U1603, C2141, C2142, R262, R265 removed ; R1824, R1825, R1826, R1827 added

# Changed U7 related circuit Implemented SCH review comments from Internal team ESD Part number is changed on HDMI connector USB HUB port 1 and 4 connection swapped

# R1843, R1844 resistors added, Y2 part changed

03/10/2018

28/09/2018

# 0.4 eInfochips

# Title

# Project

# Designed eInfochips

Monday, November 18, 2019 | 30 | 31

# Arrow_iMX8M_HMI_Platform

# REVISION HISTORY1

# Title

# Project

# Designed eInfochips

Monday, November 18, 2019 | 30 | 31

# Arrow_iMX8M_HMI_Platform

# REVISION HISTORY1

# Title

# Project

# Designed eInfochips

Monday, November 18, 2019 | 30 | 31

# Arrow_iMX8M_HMI_Platform

# REVISION HISTORY1

D | D
C | C
B | B
A | A

# DATE

# R398, R403 changed from mounted to DNP ; R395, R404 changed from DNP to mounted

# QSPI power net changed ; D820 Added ; R1846 & C2155 added

# REVISION HISTORY2

PCB REV | SCH REV | CHANGE DESCRIPTION | AUTHOR

# eInfochips

# Murata module part number changed to LBEE5HY1MW-230- from LBEE5HY1MW-TEMP

# eInfochips

# USB OTG Part Number changed to Molex-475890001 ; R166 changed to 0E

# Back annotation done

# C534,R457 and R458 are added,U14 VCC net name changed

# ADI review comments implemented

# CLIP16, CLIP18, CLIP32, CLIP33, CLIP34, CLIP35, CLIP36, CLIP37, CLIP38 removed

1.2 | 18/01/2019 | eInfochips

# eInfochips

Alpha released version | 11/10/2018

# Production version released

1.0

08/02/2019

# CAN SPI pull-up R389, R393, R397, R399 removed

# ADP5014 compensation network changed to C221=15nF, C415=22nF, C228=68nF, C225=47nF

Changed boot mode in BOM to internal boot ; Updated GPIO table in schematics ; R324 changed to 100K

# LBEE5HY1MW Attenuator circuit modified: C124=270E, C159=270E, R70=20E, R89=1.4nH

# D819 & R1845 added ; C2156 added ; R164 removed

USB_HUB_PWR_EN pull-up DNP for U25 & U26 for 5V; USB_HUB_PWR_EN pull-up added on 3.3V supply

Added 0E reistor on MIC pin of Lineout jack to make it CTIA compatible ; U61, U62, U63 added

# chassis ground changed ; Voltage level traslator changed to reset buffer

# Ethernet RGMII part changed to Industrial (KSZ9031RNXIC-TR)

0E removed in proven circuits: R58, R65, R368, R369, R207, R208, R72, R73, R24, R27, R28, R10, R98, R97,

# R105, R107, R106, R108, R100, R102, R101, R99, R162, R164, R320, R319

# Removed D812 ; Removed R217, R218

# Routed BT UART through USB to UART ; Changed USB to UART to CP2102N for 3M baud rate

# LED1 to LED6 symbol changed ; Changed J17 Debug connector to TMS-103-02-G-S

# R391, R392, R393, R394 removed ; R1814, R1813, R172, R168 changed to 0E

# U64 (AD2428W) and related componens added ; Removed R15, R17, R192, R196, R288

# R54, R57, R60, R68, R301 changed to 33E after SI simulation of WIFI Section

2.0

# Internal review comments implemented ; R453 added ; R203, C422 changed to DNP

# eInfochips

SD Card Detect Pin Logic Swap ; USB Hub Mode Select change from external to internal ROM 1.1 | 16/01/2019

2.2

# Beta released version

04/04/2019

03/04/2019

# CAN Isolator part changed to ADM3054

# eInfochips

# ADI review comments implemented for A2B

2.1

Removed R149 ; Changed R460 to 10K ; Removed R455 ; Swapped connection of U24 & U27 | eInfochips
0.6 | 10/10/2018 | eInfochips

0.5 08/10/2018

2.3 | LPDDR4, Processor part number changed ; Q12 value corrected as per mfg part details | 18/11/2019 | eInfochips

# Title

# Project

# Designed eInfochips

Monday, November 18, 2019 | 31 | 31

# Arrow_iMX8M_HMI_Platform

# REVISION HISTORY2

# Title

# Project

# Designed eInfochips

Monday, November 18, 2019 | 31 | 31

# Arrow_iMX8M_HMI_Platform

# REVISION HISTORY2

# Title

# Project

# Designed eInfochips

Monday, November 18, 2019 | 31 | 31

# Arrow_iMX8M_HMI_Platform

# REVISION HISTORY2
