ArrowElectronics/I.IMX8_Thor96/Hardware Docs/Block-Diagram/eI_Arrow_iMX8M_HMI_Platform_BlockDiagram.pdf

# i.MX8M HMI Platform Block Diagram v2.2

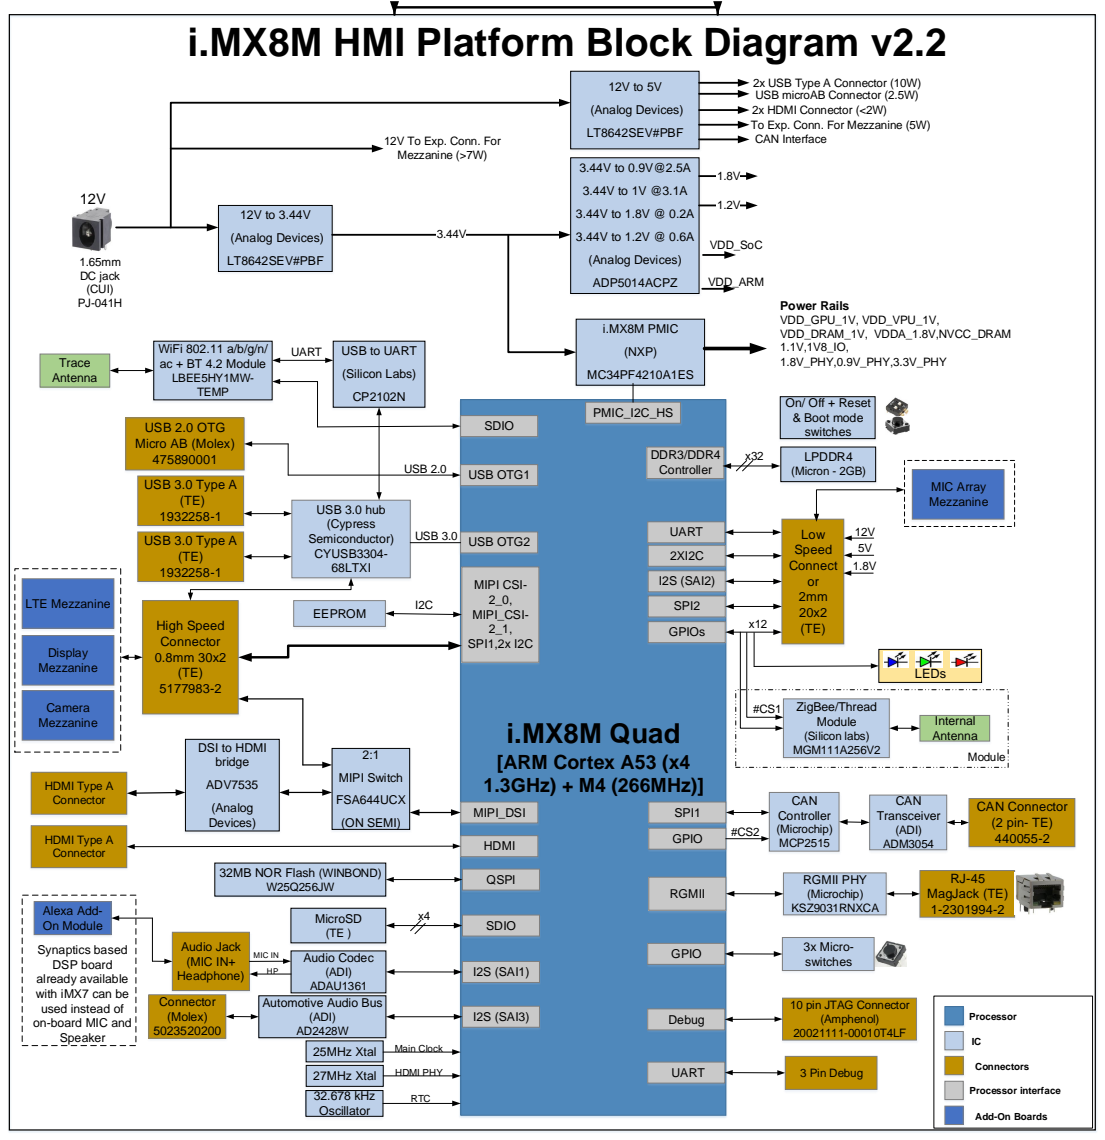
[picture p200: page 1]
i.MX8M Quad; [ARM Cortex A53 (x4 1.3GHz) + M4 (266MHz)]; PMIC_I2C_HS; DDR3/DDR4 Controller; RGMII; LPDDR4 (Micron - 2GB); RGMII PHY (Microchip) KSZ9031RNXCA; 10 pin JTAG Connector (Amphenol) 20021111-00010T4LF; QSPI; USB OTG1; USB OTG2; USB 3.0 Type A (TE) 1932258-1; 25MHz Xtal; USB 2.0; 32.678 kHz Oscillator; RTC; Main Clock; MicroSD (TE ); SDIO; USB 3.0; RJ-45 MagJack (TE) 1-2301994-2; USB 3.0 hub (Cypress Semiconductor) CYUSB3304- 68LTXI; High Speed Connector 0.8mm 30x2 (TE) 5177983-2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

2x USB Type A Connector (10W)
USB microAB Connector (2.5W)
2x HDMI Connector (<2W)
To Exp. Conn. For Mezzanine (5W)
CAN Interface

12V To Exp. Conn. For
Mezzanine (>7W)

USB to UART

On/ Off + Reset
& Boot mode
switches

USB 2.0 OTG
Micro AB (Molex)

DSI to HDMI
bridge

HDMI HDMI Type A
Connector

32MB NOR Flash (WINBOND)

Synaptics based
DSP board
already available
with iMX7 can be
used instead of
on-board MIC and
Speaker

Automotive Audio Bus

Add-On Boards

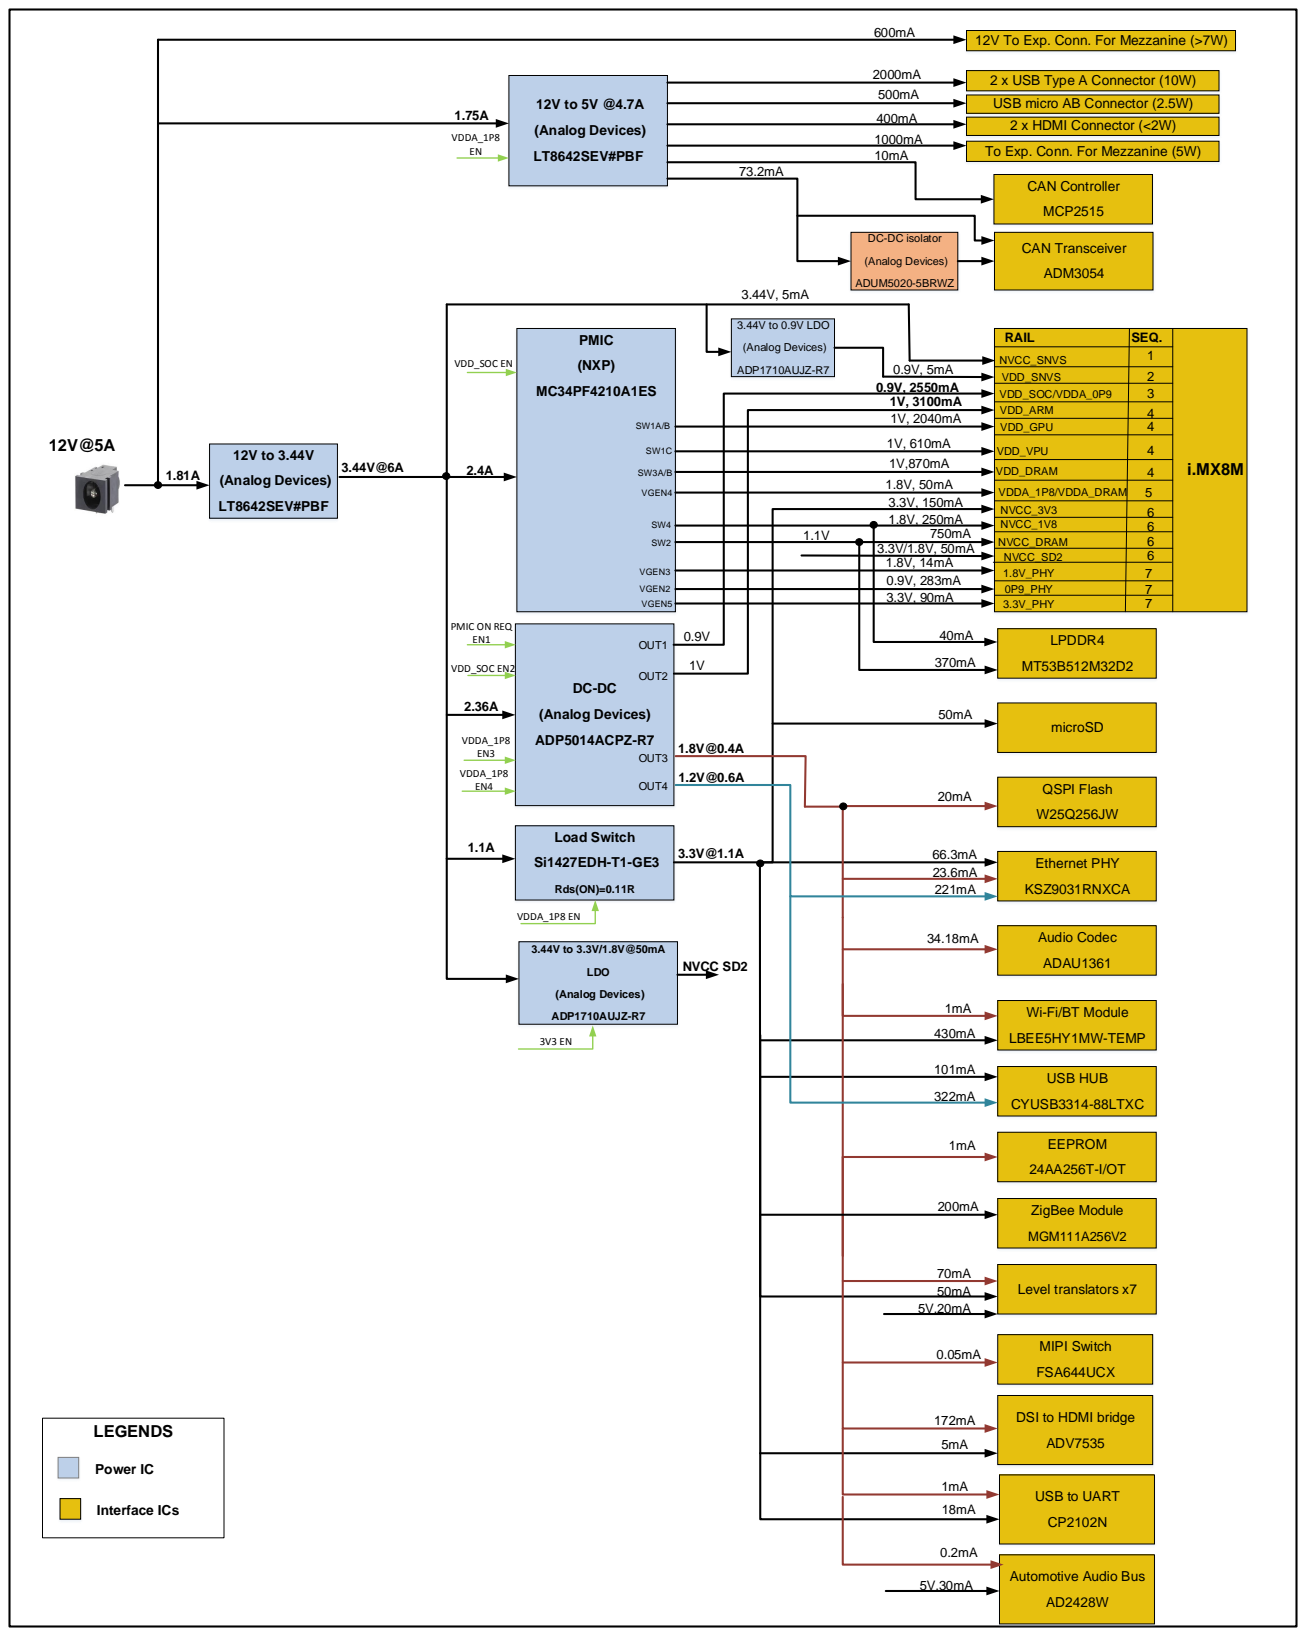
[picture p201: page 2]
(Analog Devices); LT8642SEV#PBF; PMIC; (NXP); ADP5014ACPZ-R7; OUT1; OUT2; OUT4; OUT3; LBEE5HY1MW-TEMP; LPDDR4; microSD; QSPI Flash; Ethernet PHY; KSZ9031RNXCA; Audio Codec; ADAU1361; USB HUB; CYUSB3314-88LTXC; Load Switch; Si1427EDH-T1-GE3; Rds(ON)=0.11R; NVCC_SNVS; VDD_SNVS; VDD_SOC/VDDA_0P9; VDD_ARM; VDD_GPU; VDD_VPU; VDD_DRAM; VDDA_1P8/VDDA_DRAM; NVCC_3V3 NVCC_1V8; NVCC_DRAM; 1.8V_PHY 0P9_PHY 3.3V_PHY; RAIL; SEQ.; VGEN4; VGEN3; VGEN2; VGEN5; EEPROM; Level translators x7; LEGENDS; Power IC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

12V To Exp. Conn. For Mezzanine (>7W)

2 x USB Type A Connector (10W)
USB micro AB Connector (2.5W)
2 x HDMI Connector (<2W)

To Exp. Conn. For Mezzanine (5W)

DC-DC isolator

PMIC ON REQ

Wi-Fi/BT Module

DSI to HDMI bridge

USB to UART

Automotive Audio Bus
