ArrowElectronics/I.IMX8_Thor96/(commit log)

2022-01-20 IMX8M: Added Linux kernel 5.10 support
    - Added Yocto Hardknott support
    - Added linux kernel 5.10 support
    - Added Documentation and User guides
    - Added Test case report of release
    - Setup and Build script along with Readme
    - Yocto hardknott Patches for Thor96
2022-01-21 IMX8M: Updated Documentation
    - Updated Test case report
    - Updated User Manual
2022-02-17 IMX8M: Added AP1302 ISP Driver Support in Thor96
    - Added AP1302 ISP driver support
    - Added support of AR0430 Camera sensor
    - Added support of ARX3A0 camera sensor
    - Added ISP control features of AP1302
    - Build Script and Readme is updated to support AP1302
2022-02-17 IMX8M: Updated Documentation for AP1302 Support
    - Added AP1302 supported features in Release note
    - Added AP1302 Camera user guide with steps to validate
    AP1302 on Thor96 board
    - Added Test case and results for AR0430 and ARX3A0 camera sensor
    - Updated Thor96 User guide
2022-03-10 IMX8M: Added AP1302 ISP Driver feature improvement in Thor96
    - Fixed bug in v4l2 control default values and added changes
    in meta-einfochips-ap1302
    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
2022-03-10 IMX8M: Updated Documentation for AP1302 Support
    - Added Alexa User guide to validate Alexa demo on Thor96
    - Thor96 patches directory renamed to Thor96_L5_10_52_Rel_4_2_patches
    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
2022-03-29 IMX8M: Added support for AR1335 camera sensor in Thor96
    - Added support for AR1335 camera driver
    - Build Script and Readme is updated to support AP1302 latest
    patches
2022-03-30 IMX8M: Updated Documentation for AR1335 Support
    AR1335 camera sensor and AF on Thor96 board
    - Added Test case and results for AR0430, ARX3A0 and AR1335
    camera sensor
    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
2022-06-14 IMX8M: Added auto focus feature support for AR1335 sensor
    - Auto focus feature is enabled for AR1335 camera sensor
    - Added Auto focus feature patch, modify ap1302 recipe file to
    include AR1335 auto focus patch in the build system
    - Modified Camera User guide and Release note with auto focus feature
    information
    - Added Test case report of release for auto focus feature support
    - Modified Setup and source code Build script with latest release version
    - Modified Manual build steps provided in readme with latest release version
2023-04-26 IMX8M: Added support for AR0830 camera sensor in Thor96
    - Added support for AR0830 camera driver
    - Camera user guide, Release note and test report is updated
    - Build script is updated to fetch source from nxp github
    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
    [ei_OnSemiCamModule_96B_Thor96_Testcase.xlsx]
